petersawka/OpenHornet/MCAD/51M30-01-2-03N.SLDASM

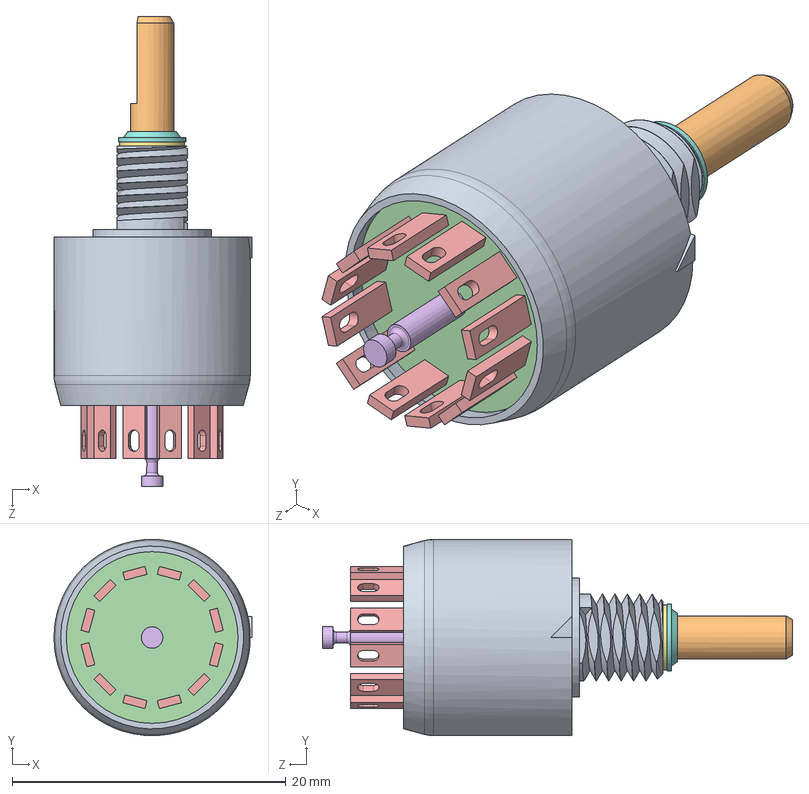
[picture p1: CAD file, 2020-11-07]
MCAD/51M30-01-2-03N.SLDASM
14.5 x 14.3 x 34.3 mm
58R3008-X
58J2001-1
58Z3130
58ZZ3040-X_PLASTIC
50C3495-5-B-001 x 12
58C3026-10
06J1025-12
58J2427
