petersawka/OpenHornet/MCAD/DSOS-0416-12D.SLDASM

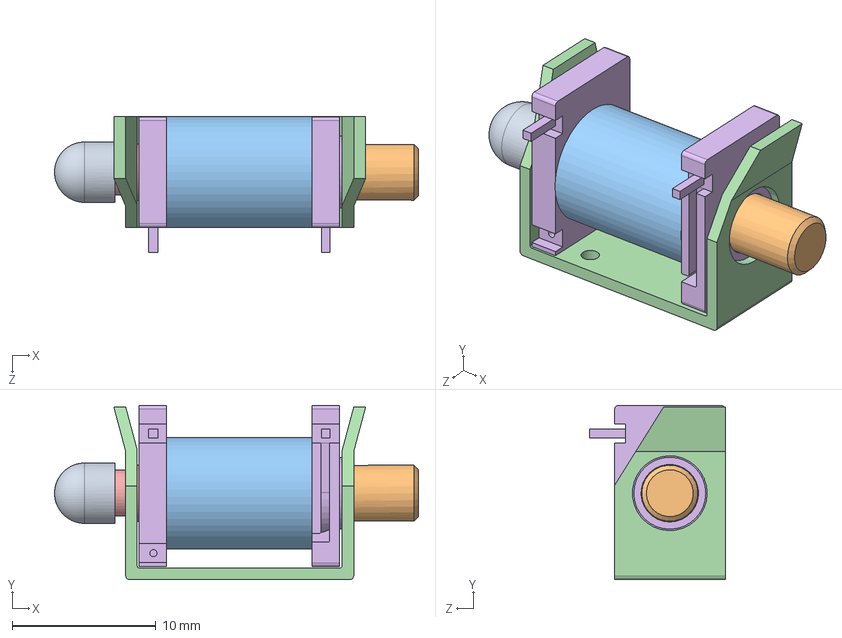
[picture p2: CAD file, 2020-11-07]
MCAD/DSOS-0416-12D.SLDASM
25.3 x 12.1 x 9.45 mm
Bumber_3248513100_051407
Plunger_3463301400_051407.dwg
Coil
Frame_3469011200
Stopper_3463600200 .bak
Bobbin
