petersawka/OpenHornet/MCAD/Wing Fold Handle Mechanism.SLDASM

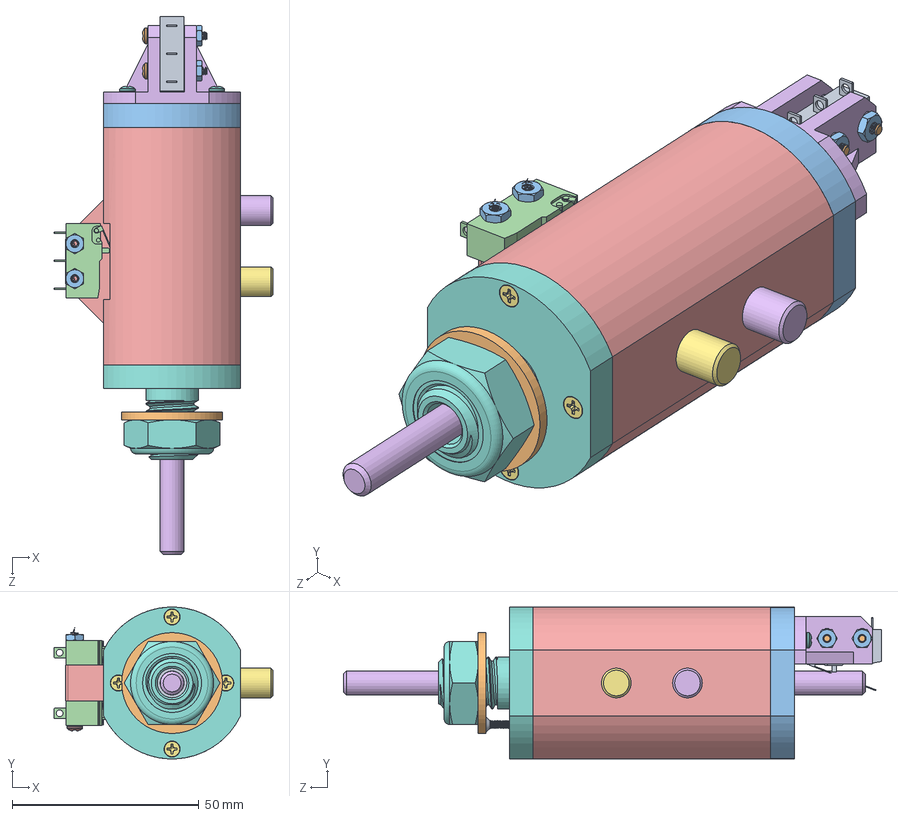
[picture p3: CAD file, 2020-11-07]
MCAD/Wing Fold Handle Mechanism.SLDASM
58.6 x 40.6 x 144.0 mm
Wing Fold Mechanism Rotary Detents
92311A105 x 3
91841A005 x 3
Wing Fold Mechanism Push-Pull Detents
9414T6 x 2
Wing Fold Mechanism .250 Shaft
92311A425
Wing Fold Mechanism Upper Cap
6338K411
93365A112 x 11
Wing Fold Mechanism Lower Cap
6338K411 (1)
Wing Fold Mechanism Main Body
Wing Fold Mechanism Locking Limit Switch Bracket
96640A027 x 8
91249A050 x 2
7658K15
91249A060 x 2
91841A003 x 4
7658K16 x 2
91249A066 x 2
84835A44
84835A36
Wing Fold Handle Retaining Nut
96640A025
92141A034
