petersawka/OpenHornet/MCAD/631H_SLASH_2 - SWITCH, TOGGLE, ON-OFF, STD BAT.SLDASM

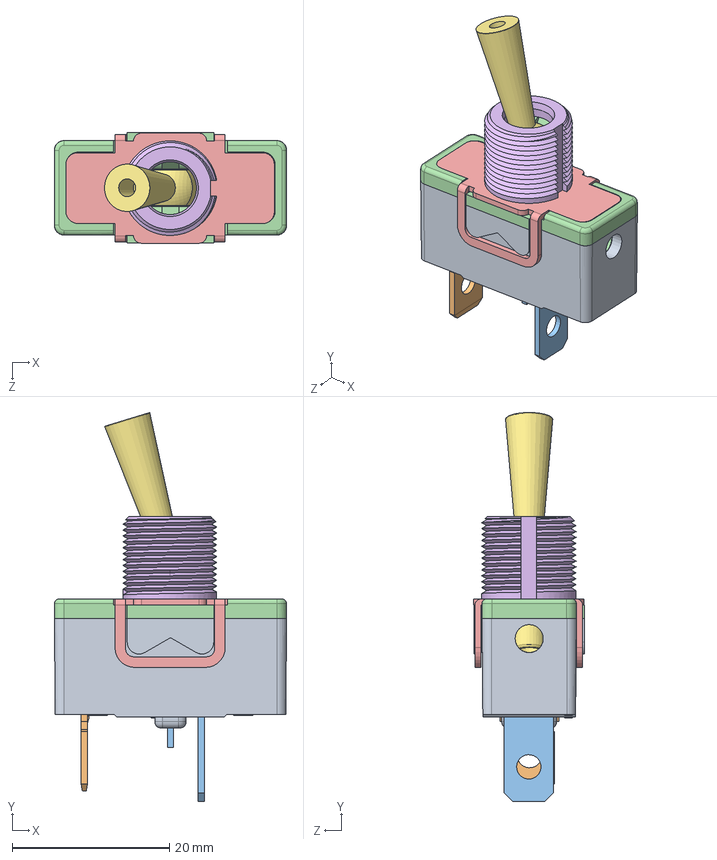
[picture p4: CAD file, 2020-11-07]
MCAD/631H_SLASH_2 - SWITCH, TOGGLE, ON-OFF, STD BAT.SLDASM
29.5 x 49.4 x 14.1 mm
