petersawka/OpenHornet/MCAD/ESE11HS2.SLDASM

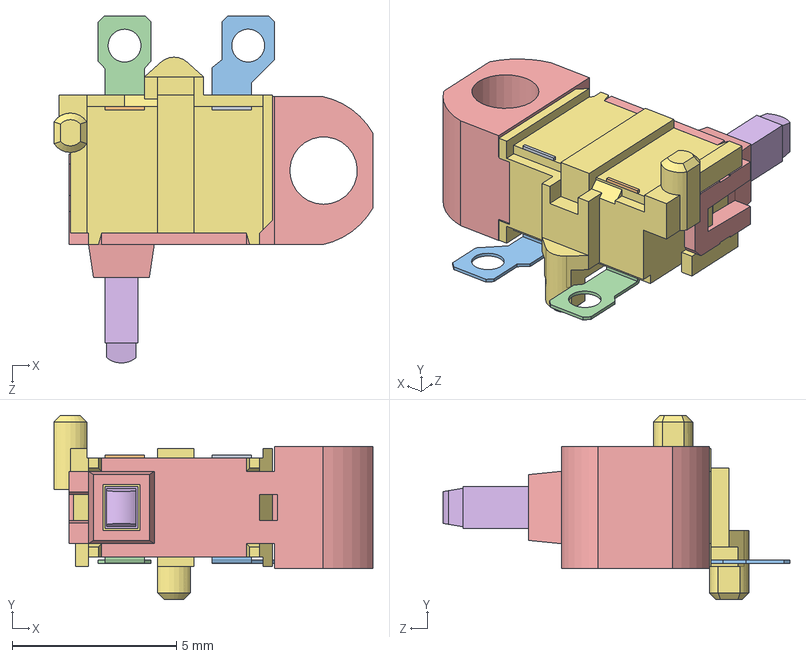
[picture p5: CAD file, 2020-11-07]
MCAD/ESE11HS2.SLDASM
9.70 x 5.60 x 10.6 mm
sw-3d-131-e11ts8-hs-sk-r00
sw-3d-131-e11ts8-hs-sk-r00_2
sw-3d-131-e11ts8-hs-sk-r00_3
sw-3d-131-e11ts8-hs-sk-r00_4
sw-3d-131-e11cv9a-hs-sk-r00
sw-3d-131-e11lv9-hs-sk-r00
sw-3d-131-e11cs3-hs-pc-r00
