petersawka/OpenHornet/MCAD/SIM CNTL Panel.sldasm

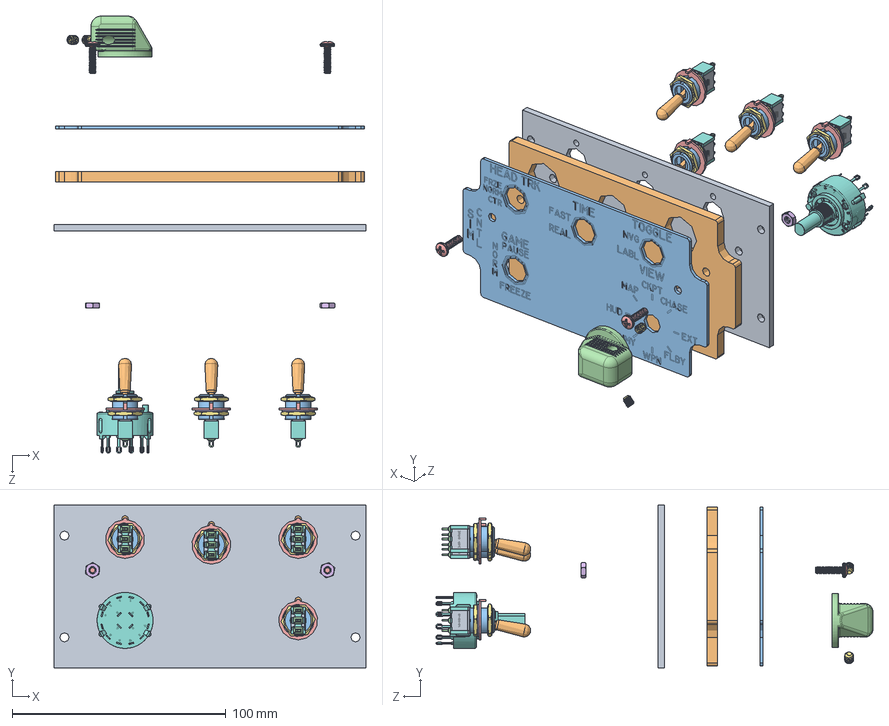
[picture p6: CAD file, 2020-11-07]
MCAD/SIM CNTL Panel.sldasm
146.1 x 76.2 x 204.5 mm
SIM CNTL Panel Backplate
SIM CNTL Panel Lightplate
SIM CNTL Panel Legend Plate
MS21384-04DNN v1
91249A148 - PHS, 6-32 X .500, 18-8, BLACK-OXIDE x 2
90760A007 - NUT, 6-32, JAM, STEEL, ZINC-PLATED x 2
92311A189 - SCREW, SET, 8-32 X .1875, CUP POINT, HEX DRIVE, 18-8 x 2
100-300SPXBODY x 4
100SPXBRACKET_1 x 4
100T8 x 4
100B13BUSHING x 4
100-300SPXM1 x 4
HDW17 - LOCKING RING, B13 x 4
HDW12 - LOCK WASHER, B13 x 4
HDW4 - NUT, B13 x 8
A12505RNZQ - SWITCH, ROTARY, 45 DEG, 8 POS, FIXED
