petersawka/OpenHornet/MCAD/100SPxT8B13M1QEH - SWITCH, TOGGLE, SPDT, 18mm BAT.SLDASM

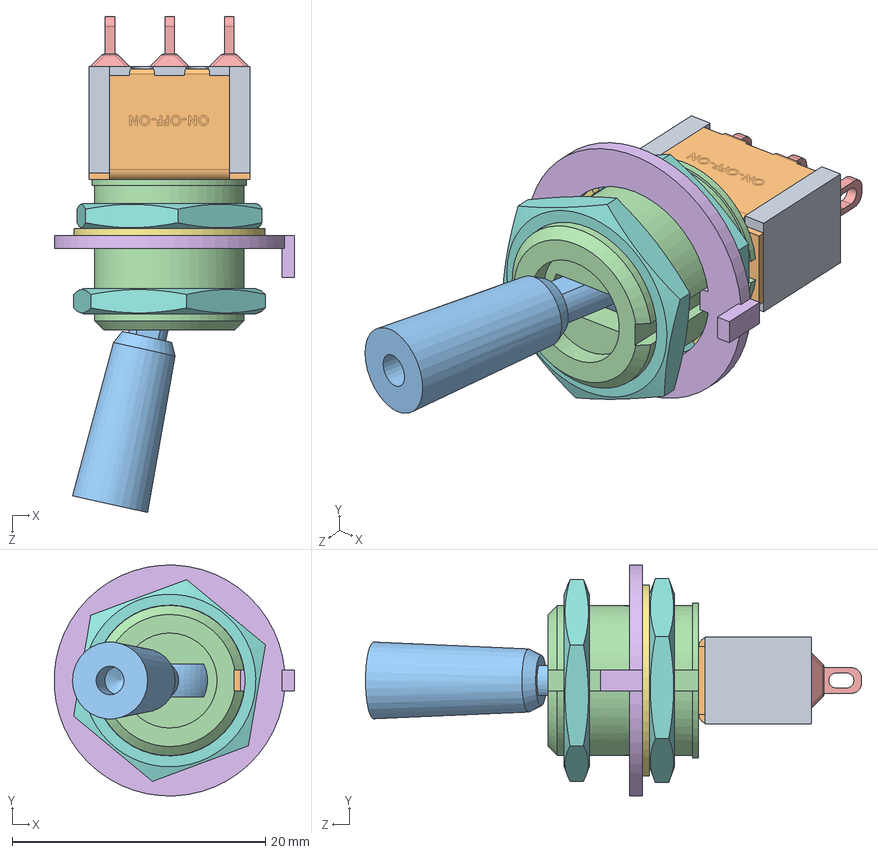
[picture p7: CAD file, 2020-11-07]
MCAD/100SPxT8B13M1QEH - SWITCH, TOGGLE, SPDT, 18mm BAT.SLDASM
19.0 x 18.2 x 39.2 mm
100-300SPXBODY
100SPXBRACKET_1
100T8
100B13BUSHING
100-300SPXM1
HDW17 - LOCKING RING, B13
HDW12 - LOCK WASHER, B13
HDW4 - NUT, B13 x 2
