petersawka/OpenHornet/MCAD/OBOGS Panel.SLDASM

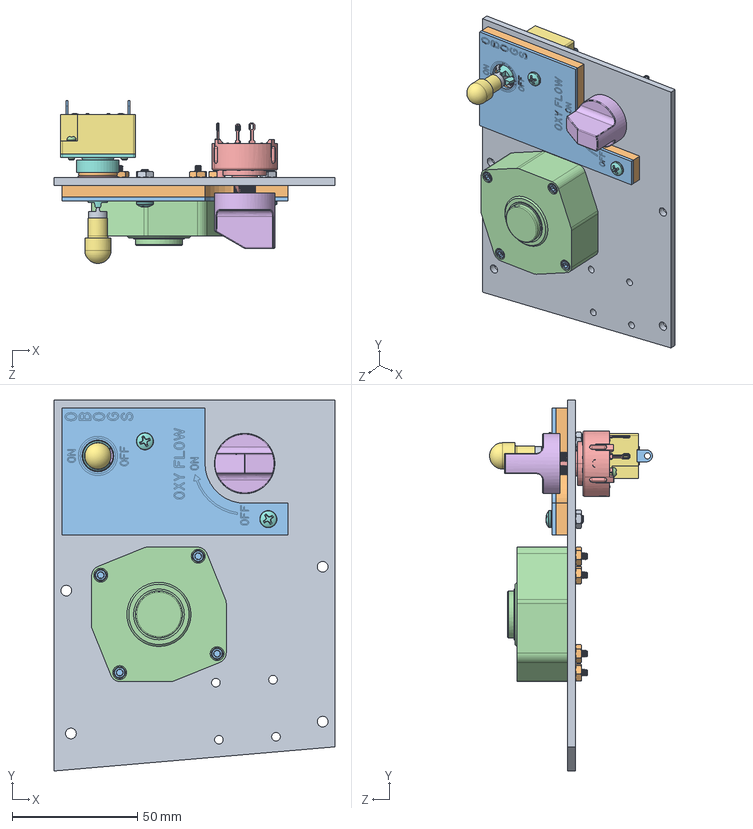
[picture p8: CAD file, 2020-11-07]
MCAD/OBOGS Panel.SLDASM
112.3 x 148.3 x 65.1 mm
OBOGS Backplate
OBOGS Lightplate
OBOGS Legend Plate
OBOGS Regulator
A11405RNZQ - SWITCH, ROTARY, 90 DEG, 2 POS
OBOGS Knob
S2AL_SMC_body1-body
S2AL_SMC_plate13
S2AL_S2AL_bat
S2AL_AT537
S2AL_SMC_trmnls2-terminals
S2AL_M2_5x7_5 x 2
S2AL_AT508
S2AL_AT503M
Round Locking Bat
91249A148 - PHS, 6-32 X .500, 18-8, BLACK-OXIDE x 2
90760A007 - NUT, 6-32, JAM, STEEL, ZINC-PLATED x 2
91841A005 - NUT, 4-40, 18-8 x 4
91251A115 - SHCS, 4-40 X 1.000, STEEL, BLACK OXIDE x 4
