petersawka/OpenHornet/MCAD/Magnetically Actuated Switch.sldasm

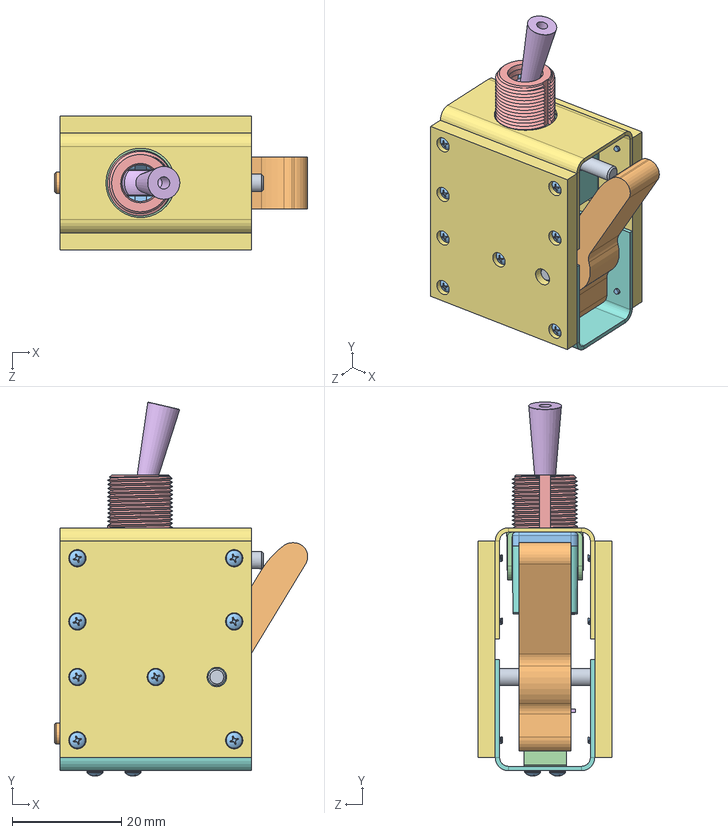
[picture p9: CAD file, 2020-11-07]
MCAD/Magnetically Actuated Switch.sldasm
46.4 x 68.4 x 24.6 mm
Bumber_3248513100_051407
Plunger_3463301400_051407.dwg
Coil
Frame_3469011200
Stopper_3463600200 .bak
Bobbin
Mag Held Switch Side Plate x 2
Upper Mag Switch Bracket
Lower Mag Switch Bracket
98381A474 - PIN, DOWEL, .125 OD X .825L, ALLOY STEEL x 2
Mag Switch Lever
99461A505 - PHS, 0-42 X .125, SELF TAPPING, 18-8 x 18
