petersawka/OpenHornet/MCAD/HS13Z_D - SWITCH, ROTARY, 45 DEG, 4 POS, FIXED.sldasm

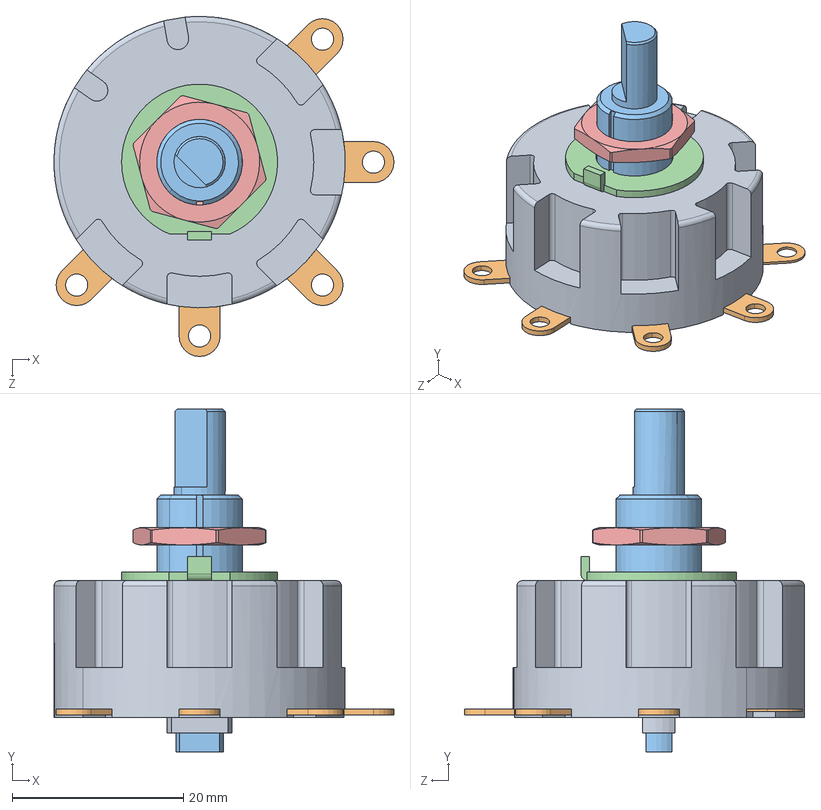
[picture p10: CAD file, 2020-11-07]
MCAD/HS13Z_D - SWITCH, ROTARY, 45 DEG, 4 POS, FIXED.sldasm
39.7 x 40.0 x 39.7 mm
_HS13Z_body_2
_HS13Z_trmnls_4
_HS13Z_D_shaft_6
_AT518_12
_AT526_8
