petersawka/OpenHornet/MCAD/SxAL.sldasm

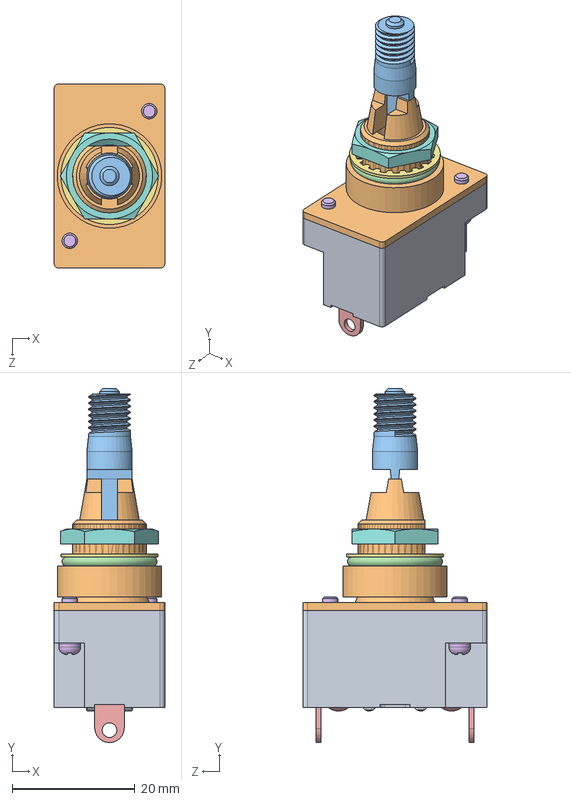
[picture p11: CAD file, 2020-11-07]
MCAD/SxAL.sldasm
18.0 x 57.6 x 30.0 mm
S2AL_SMC_body1-body
S2AL_SMC_plate13
S2AL_S2AL_bat
S2AL_AT537
S2AL_SMC_trmnls2-terminals
S2AL_M2_5x7_5 x 2
S2AL_AT508
S2AL_AT503M
