petersawka/OpenHornet/MCAD/SNSR Panel.sldasm

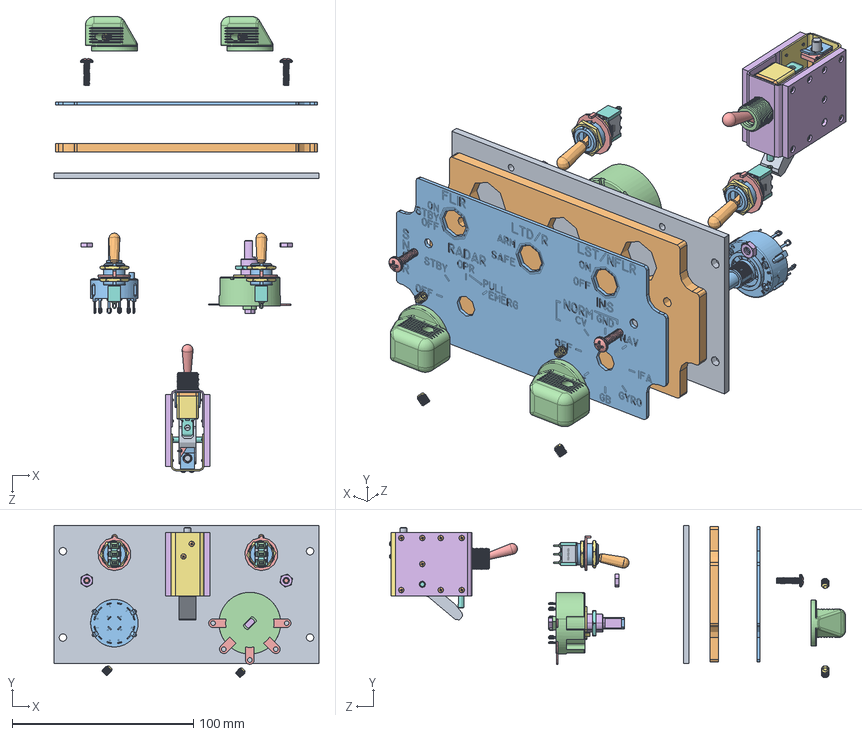
[picture p12: CAD file, 2020-11-07]
MCAD/SNSR Panel.sldasm
146.1 x 84.0 x 251.4 mm
SNSR Panel Backplate
SNSR Panel Lightplate
SNSR Panel Legend Plate
MS21384-04DNN v1 x 2
91249A148 - PHS, 6-32 X .500, 18-8, BLACK-OXIDE x 2
90760A007 - NUT, 6-32, JAM, STEEL, ZINC-PLATED x 2
92311A189 - SCREW, SET, 8-32 X .1875, CUP POINT, HEX DRIVE, 18-8 x 4
100-300SPXBODY x 2
100SPXBRACKET_1 x 2
100T8 x 2
100B13BUSHING x 2
100-300SPXM1 x 2
HDW17 - LOCKING RING, B13 x 2
HDW12 - LOCK WASHER, B13 x 2
HDW4 - NUT, B13 x 4
Bumber_3248513100_051407
Plunger_3463301400_051407.dwg
Coil
Frame_3469011200
Stopper_3463600200 .bak
Bobbin
Mag Held Switch Side Plate x 2
Upper Mag Switch Bracket
Lower Mag Switch Bracket
98381A474 - PIN, DOWEL, .125 OD X .825L, ALLOY STEEL x 2
Mag Switch Lever
99461A505 - PHS, 0-42 X .125, SELF TAPPING, 18-8 x 18
A12505RNZQ - SWITCH, ROTARY, 45 DEG, 8 POS, FIXED
_HS13Z_body_2
_HS13Z_trmnls_4
_HS13Z_D_shaft_6
_AT518_12
_AT526_8
