petersawka/OpenHornet/MCAD/DSOL-0630-12E - SOLENOID, OPEN-FRAME, PULL, INTERMITTENT, 12V, .50 STROKE.SLDASM

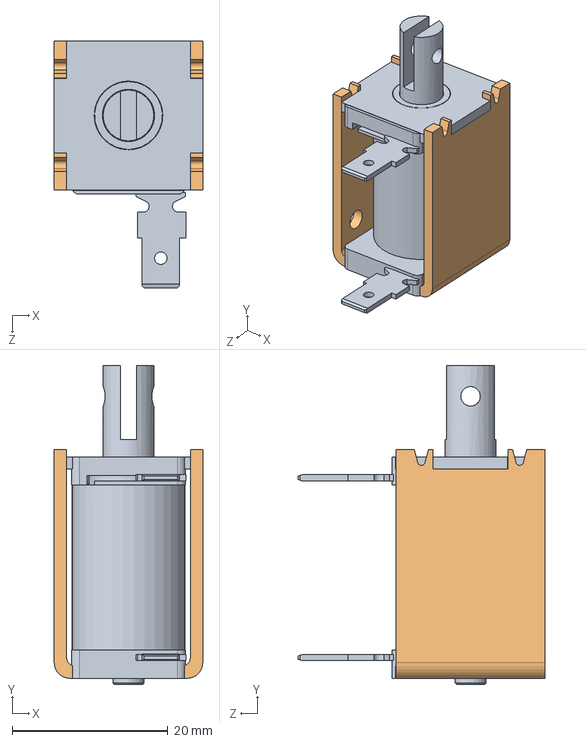
[picture p13: CAD file, 2020-11-07]
MCAD/DSOL-0630-12E - SOLENOID, OPEN-FRAME, PULL, INTERMITTENT, 12V, .50 STROKE.SLDASM
19.1 x 40.9 x 31.6 mm
COPPER_WIRE-DSOS-0630-24
U-FRAME_DSOS-0630-24
