petersawka/OpenHornet/MCAD/INT LT Panel.sldasm

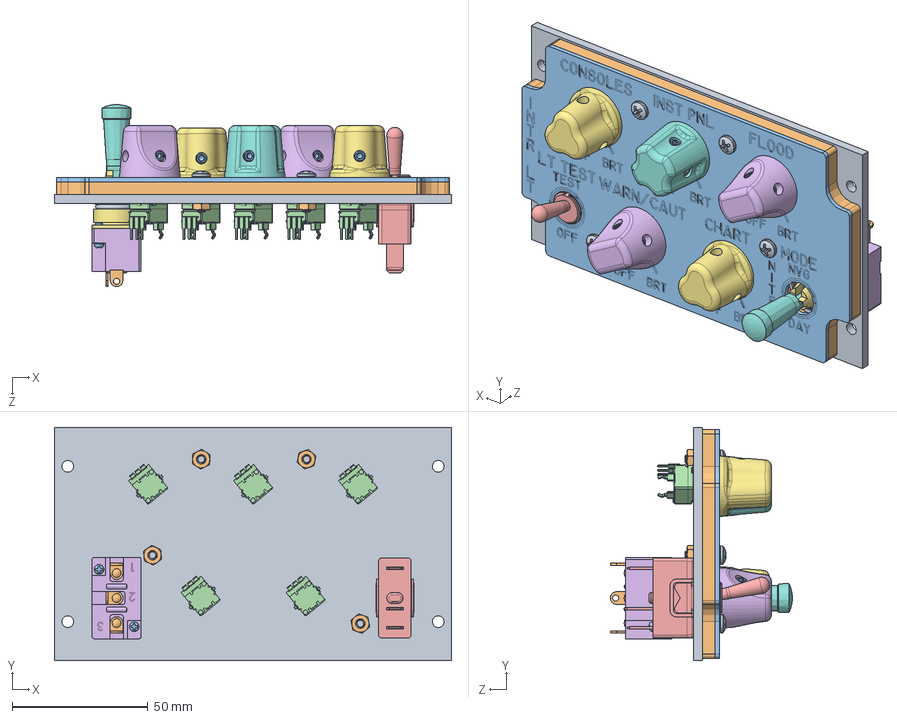
[picture p14: CAD file, 2020-11-07]
MCAD/INT LT Panel.sldasm
146.1 x 85.7 x 67.0 mm
INT Lights Backplate
INT Lights Lightplate
INT Lights Legend Plate
P0915N-FC20BR10K x 5
635H_SLASH_2 - SWITCH, TOGGLE, ON-MOM, REGULAR BAT
S2AL_SMC_body1-body
S2AL_SMC_plate13
S2AL_S2AL_bat
S2AL_AT537
S2AL_SMC_trmnls2-terminals
S2AL_M2_5x7_5 x 2
S2AL_AT508
S2AL_AT503M
MS21385-04CNN v1 x 2
MS21385-04ENN v3 x 2
MS21385-04BNN v1
91249A148 - PHS, 6-32 X .500, 18-8, BLACK-OXIDE x 4
90760A007 - NUT, 6-32, JAM, STEEL, ZINC-PLATED x 4
92311A189 - SCREW, SET, 8-32 X .1875, CUP POINT, HEX DRIVE, 18-8 x 10
