petersawka/OpenHornet/MCAD/Wing Fold Mechanism Rotating ASSY.SLDASM

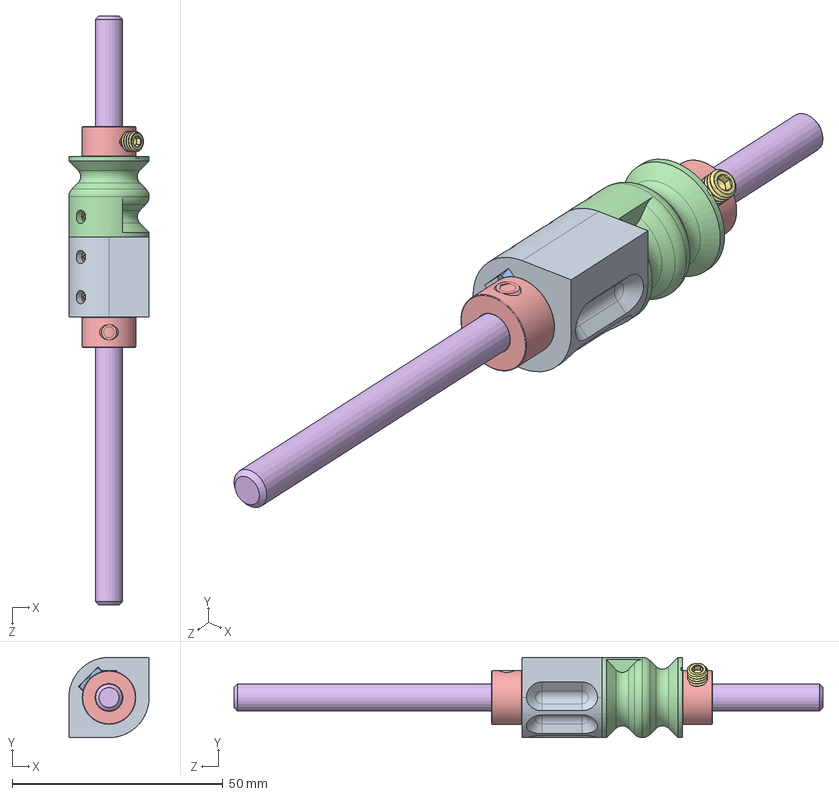
[picture p15: CAD file, 2020-11-07]
MCAD/Wing Fold Mechanism Rotating ASSY.SLDASM
19.1 x 19.1 x 139.7 mm
Wing Fold Mechanism Rotary Detents
92311A105 x 3
91841A005 x 3
Wing Fold Mechanism Push-Pull Detents
9414T6 x 2
Wing Fold Mechanism .250 Shaft
92311A425
