petersawka/OpenHornet/release/2_Upper Instrument Panel/manufacturing/3D Printed/OH1A8A1A-49 - UFC COMM LED Spacer Plate.STL

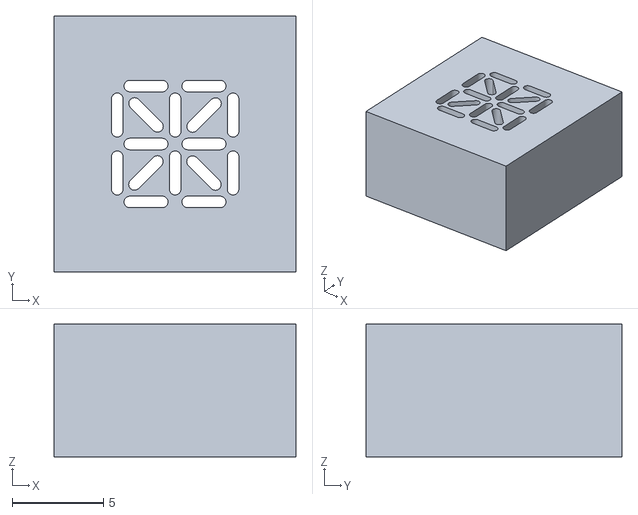
[picture p16: CAD file, 2020-11-07]
release/2_Upper Instrument Panel/manufacturing/3D Printed/OH1A8A1A-49 - UFC COMM LED Spacer Plate.STL
13.2 x 14.0 x 7.28
