petersawka/OpenHornet/release/2_Upper Instrument Panel/manufacturing/CNC/UIP .50 inch Parts/.50 DXF Drawings/UIP Left Inboard Longeron.dxf

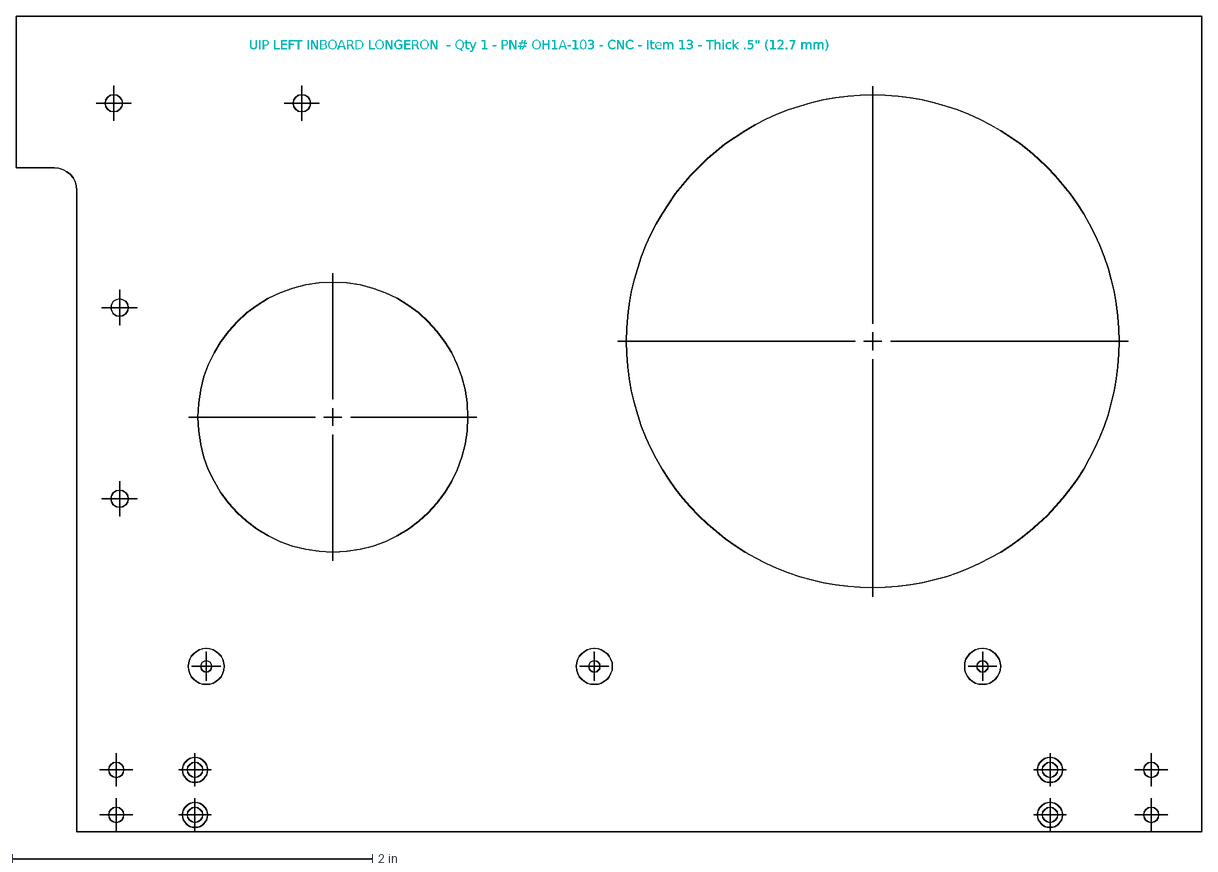
[picture p17: CAD file, 2020-11-07]
release/2_Upper Instrument Panel/manufacturing/CNC/UIP .50 inch Parts/.50 DXF Drawings/UIP Left Inboard Longeron.dxf
UIP LEFT INBOARD LONGERON - Qty 1 - PN# OH1A-103 - CNC - Item 13 - Thick .5" (12.7 mm)
