petersawka/OpenHornet/release/2_Upper Instrument Panel/manufacturing/CNC/UIP .75 inch Parts/.75 DXF Drawings/UIP Right Inboard Longeron.DXF

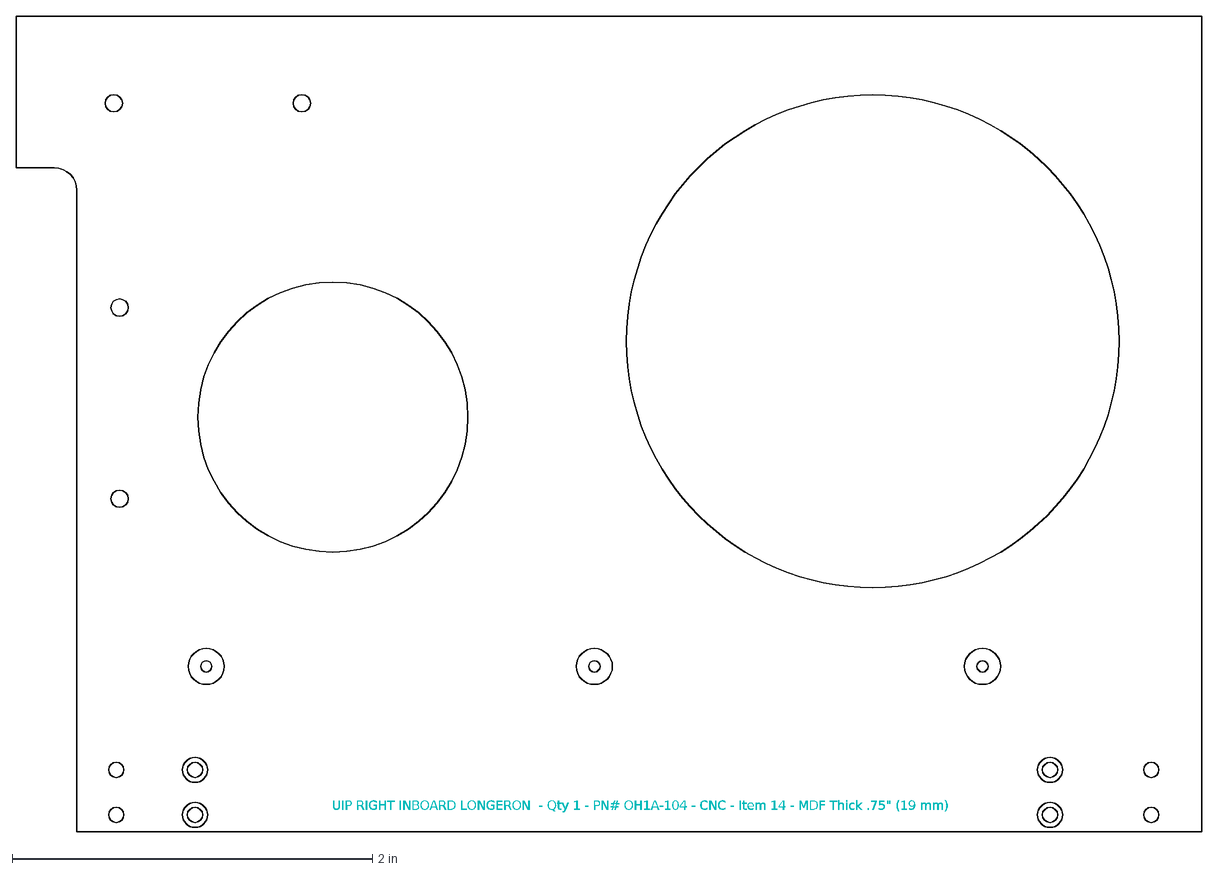
[picture p18: CAD file, 2020-11-07]
release/2_Upper Instrument Panel/manufacturing/CNC/UIP .75 inch Parts/.75 DXF Drawings/UIP Right Inboard Longeron.DXF
UIP RIGHT INBOARD LONGERON - Qty 1 - PN# OH1A-104 - CNC - Item 14 - MDF Thick .75" (19 mm)
