petersawka/OpenHornet/release/3_Lower Instrument Panel/Manufacturing/CNC/LIP .0625 inch Parts/.0625 DXF Drawings/LIP L EXT Skin.dxf

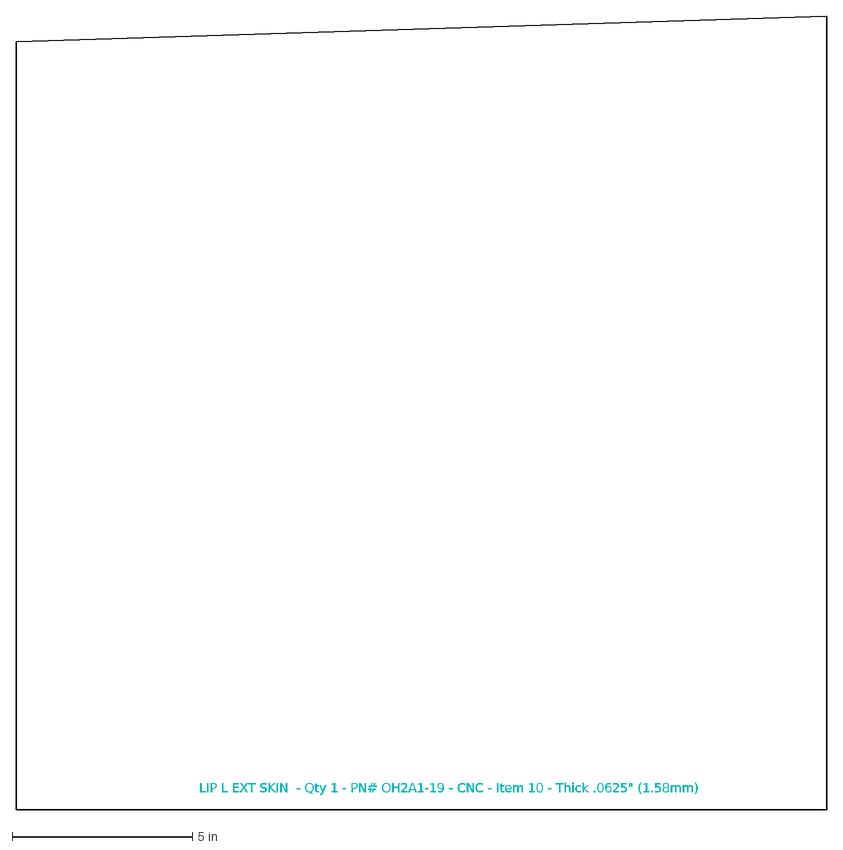
[picture p19: CAD file, 2020-11-07]
release/3_Lower Instrument Panel/Manufacturing/CNC/LIP .0625 inch Parts/.0625 DXF Drawings/LIP L EXT Skin.dxf
LIP L EXT SKIN - Qty 1 - PN# OH2A1-19 - CNC - Item 10 - Thick .0625" (1.58mm)
