petersawka/OpenHornet/release/3_Lower Instrument Panel/Manufacturing/CNC/LIP .125 inch Parts/.125 DXF Drawings/Upper Center Pedestal AMPCD Trim.dxf

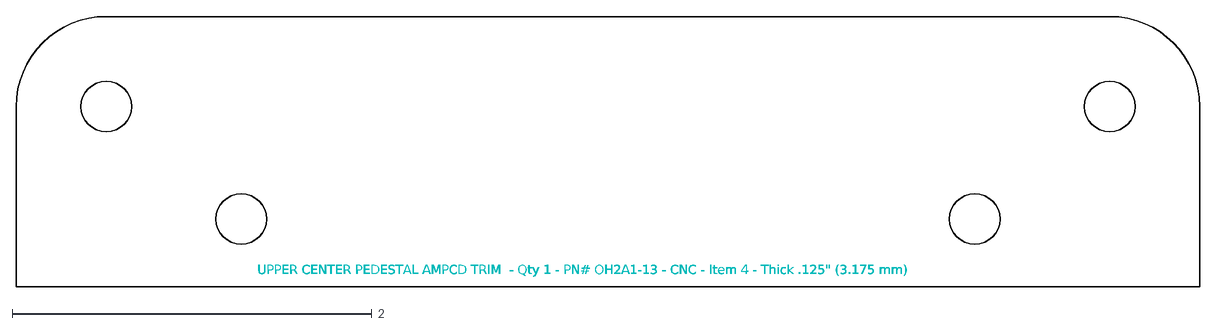
[picture p20: CAD file, 2020-11-07]
release/3_Lower Instrument Panel/Manufacturing/CNC/LIP .125 inch Parts/.125 DXF Drawings/Upper Center Pedestal AMPCD Trim.dxf
UPPER CENTER PEDESTAL AMPCD TRIM - Qty 1 - PN# OH2A1-13 - CNC - Item 4 - Thick .125" (3.175 mm)
