petersawka/OpenHornet/MCAD/Primary Rib G.sldprt

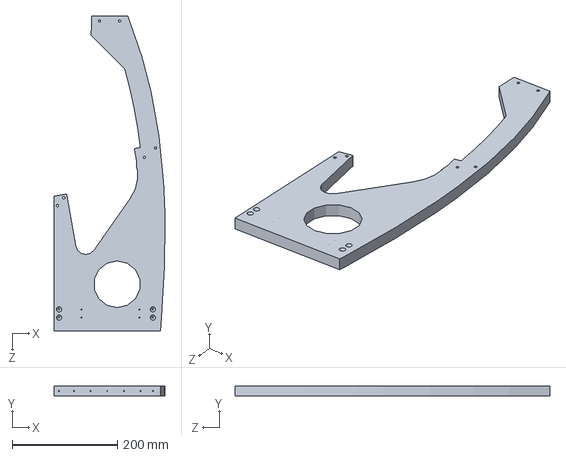
[picture p21: CAD file, 2020-11-07]
MCAD/Primary Rib G.sldprt
210.8 x 19.1 x 599.7 mm
