petersawka/OpenHornet/release/2_Upper Instrument Panel/manufacturing/3D Printed/OH1A2A-14 - Bracket, Master Arm Panel.STL

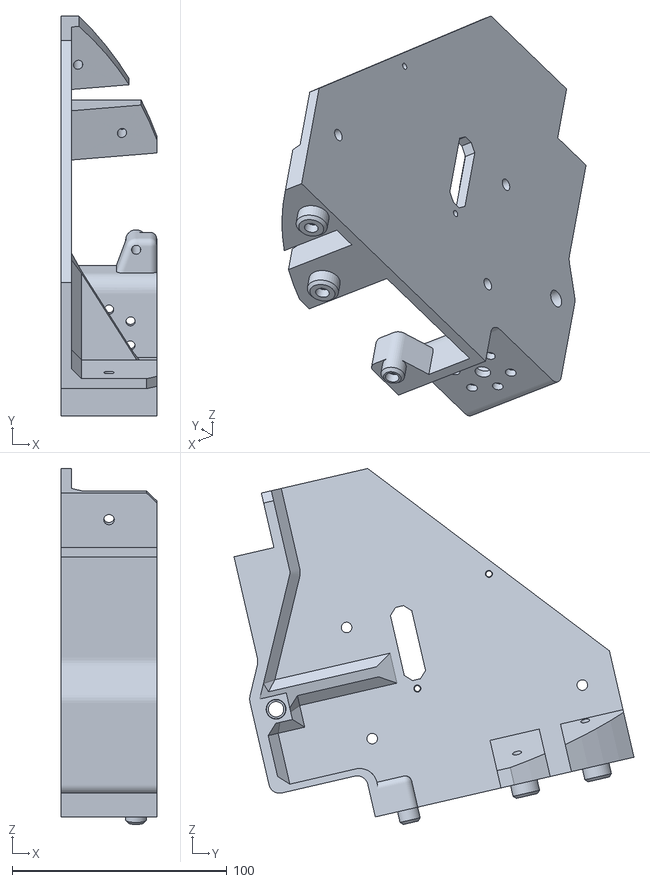
[picture p22: CAD file, 2020-11-07]
release/2_Upper Instrument Panel/manufacturing/3D Printed/OH1A2A-14 - Bracket, Master Arm Panel.STL
44.5 x 186.1 x 165.6
