petersawka/OpenHornet/release/3_Lower Instrument Panel/Manufacturing/CNC/LIP .0625 inch Parts/.0625 DXF Drawings/LIP R EXT SKIN.dxf

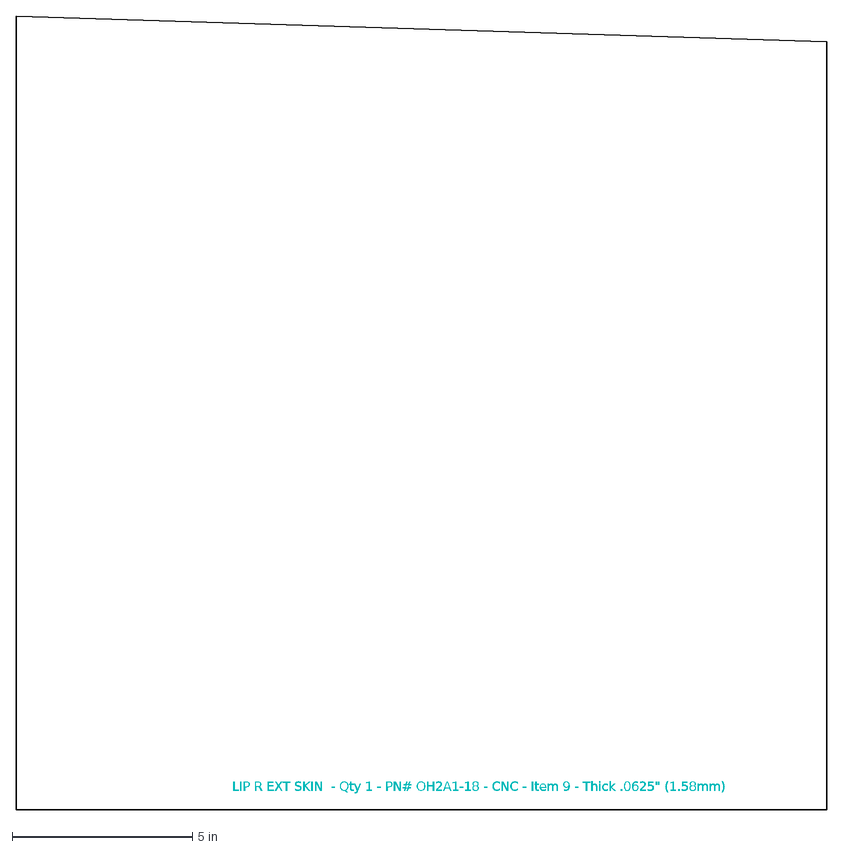
[picture p23: CAD file, 2020-11-07]
release/3_Lower Instrument Panel/Manufacturing/CNC/LIP .0625 inch Parts/.0625 DXF Drawings/LIP R EXT SKIN.dxf
LIP R EXT SKIN - Qty 1 - PN# OH2A1-18 - CNC - Item 9 - Thick .0625" (1.58mm)
