petersawka/OpenHornet/release/3_Lower Instrument Panel/Manufacturing/CNC/LIP .50 inch Parts/.50 DXF Drawings/Rudder Pedal Gantry Interface Plate.dxf

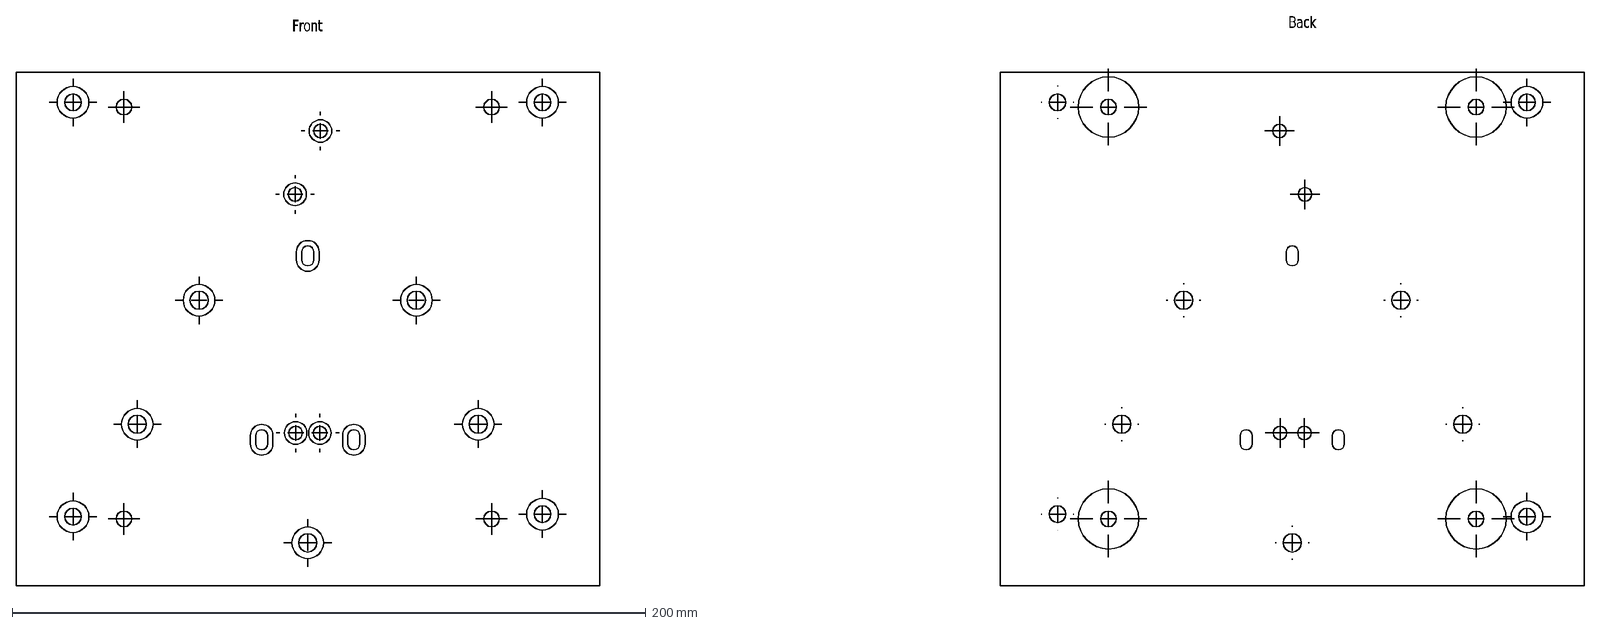
[picture p24: CAD file, 2020-11-07]
release/3_Lower Instrument Panel/Manufacturing/CNC/LIP .50 inch Parts/.50 DXF Drawings/Rudder Pedal Gantry Interface Plate.dxf
Back
Front
