petersawka/OpenHornet/release/2_Upper Instrument Panel/manufacturing/3D Printed/OH1A3A-11 - DDI Button.STL

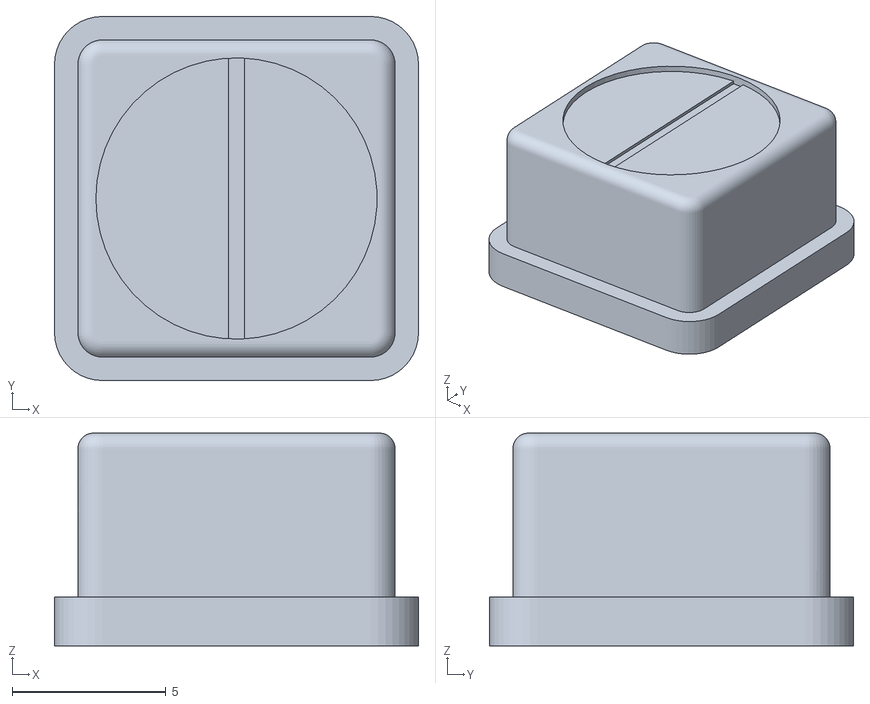
[picture p25: CAD file, 2020-11-07]
release/2_Upper Instrument Panel/manufacturing/3D Printed/OH1A3A-11 - DDI Button.STL
11.8 x 11.8 x 6.92
