petersawka/OpenHornet/release/2_Upper Instrument Panel/manufacturing/CNC/UIP .50 inch Parts/.50 DXF Drawings/Upper HUD Box Support.DXF

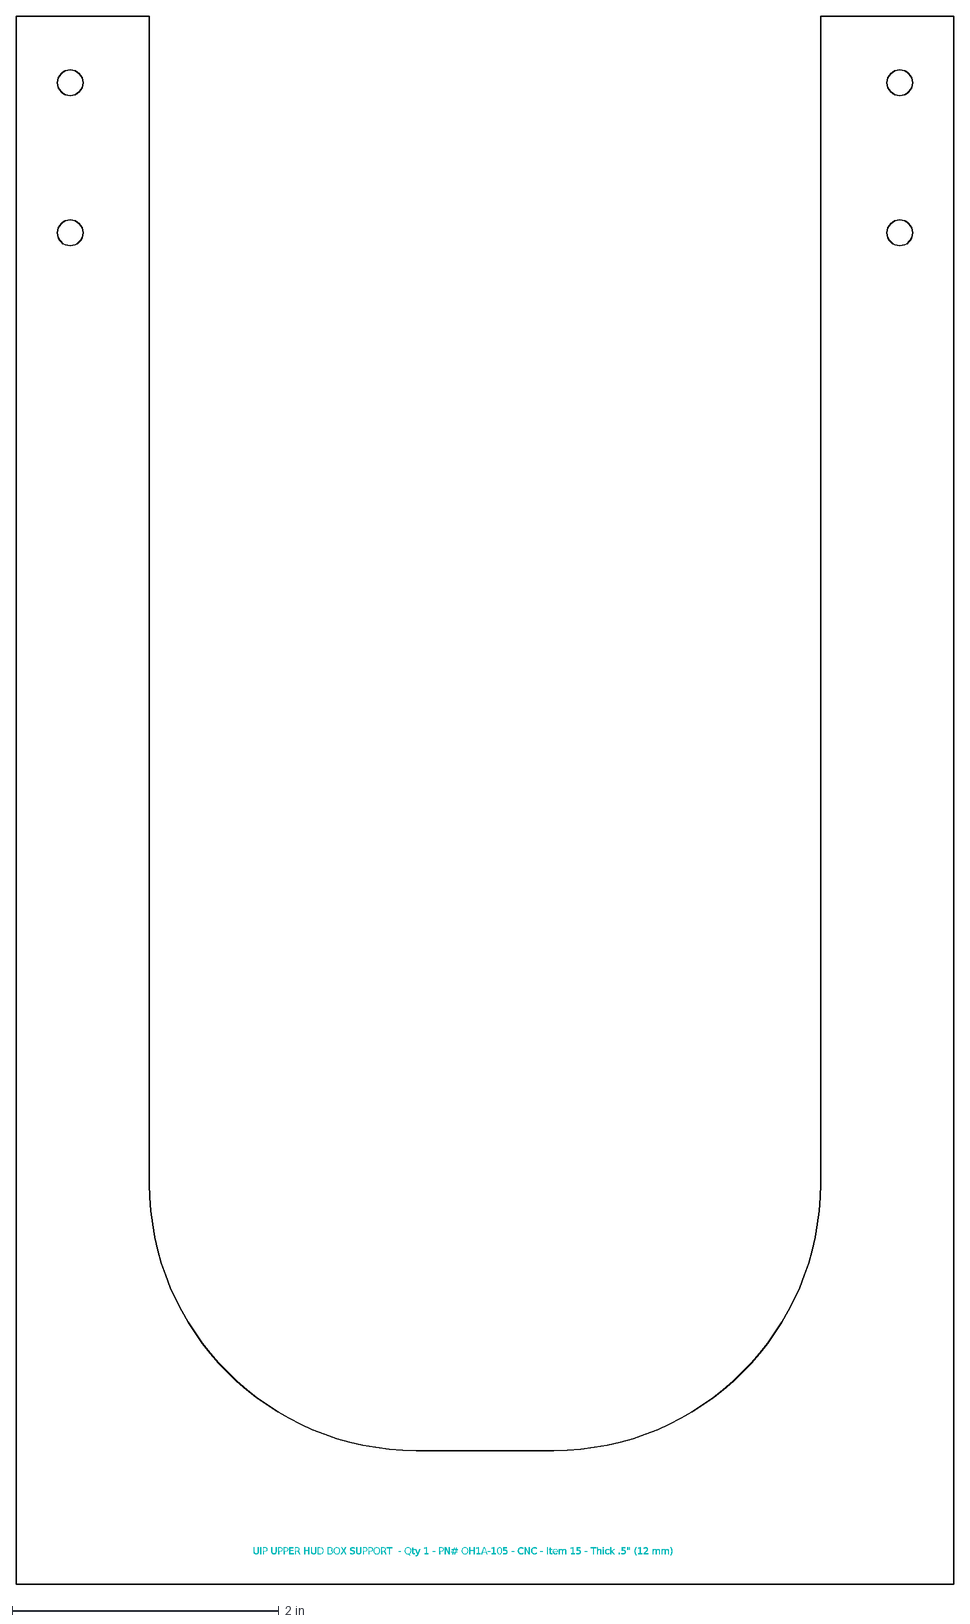
[picture p26: CAD file, 2020-11-07]
release/2_Upper Instrument Panel/manufacturing/CNC/UIP .50 inch Parts/.50 DXF Drawings/Upper HUD Box Support.DXF
UIP UPPER HUD BOX SUPPORT - Qty 1 - PN# OH1A-105 - CNC - Item 15 - Thick .5" (12 mm)
