petersawka/OpenHornet/release/2_Upper Instrument Panel/manufacturing/CNC/UIP .75 inch Parts/.75 DXF Drawings/UIP Left Inboard Longeron.DXF

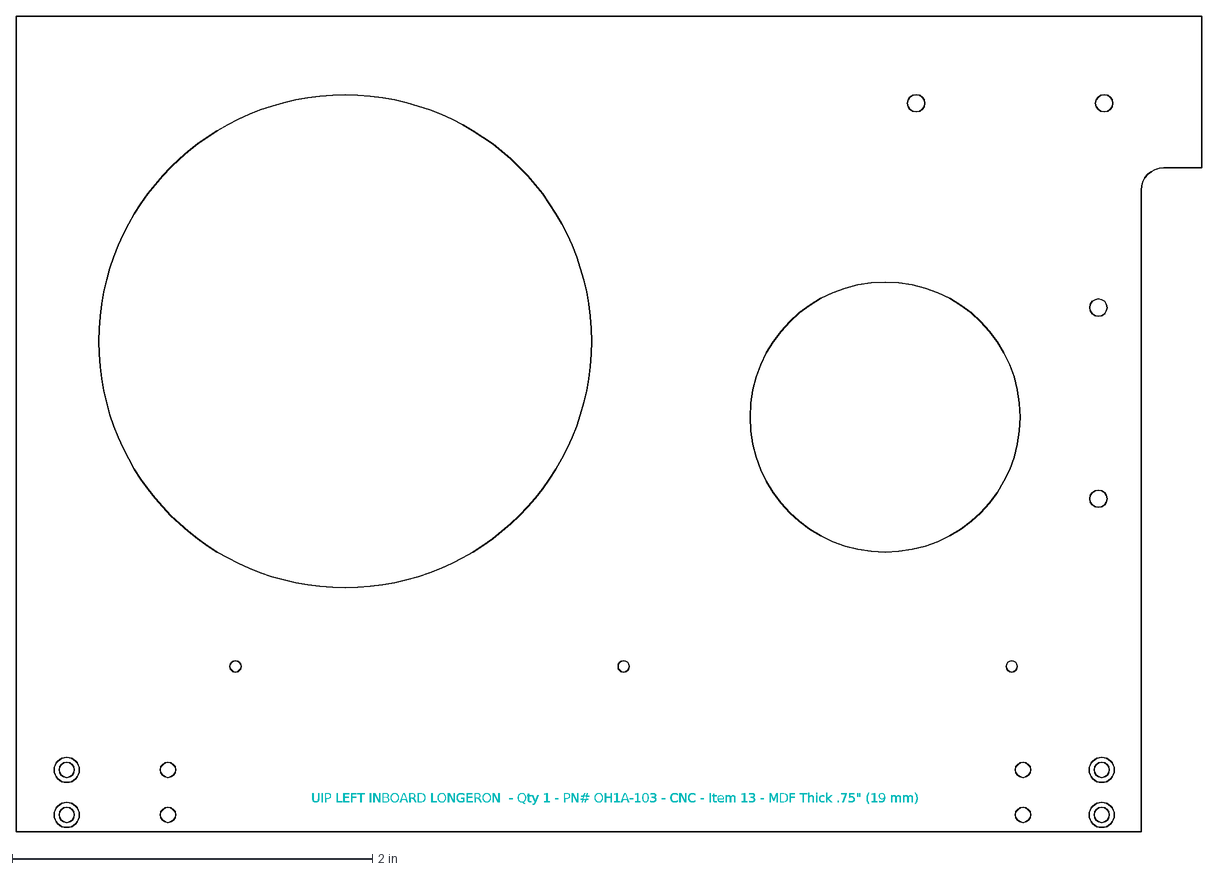
[picture p27: CAD file, 2020-11-07]
release/2_Upper Instrument Panel/manufacturing/CNC/UIP .75 inch Parts/.75 DXF Drawings/UIP Left Inboard Longeron.DXF
UIP LEFT INBOARD LONGERON - Qty 1 - PN# OH1A-103 - CNC - Item 13 - MDF Thick .75" (19 mm)
