petersawka/OpenHornet/release/2_Upper Instrument Panel/manufacturing/3D Printed/OH1A8A1A-13 - UFC Outer Spacer Plate.STL

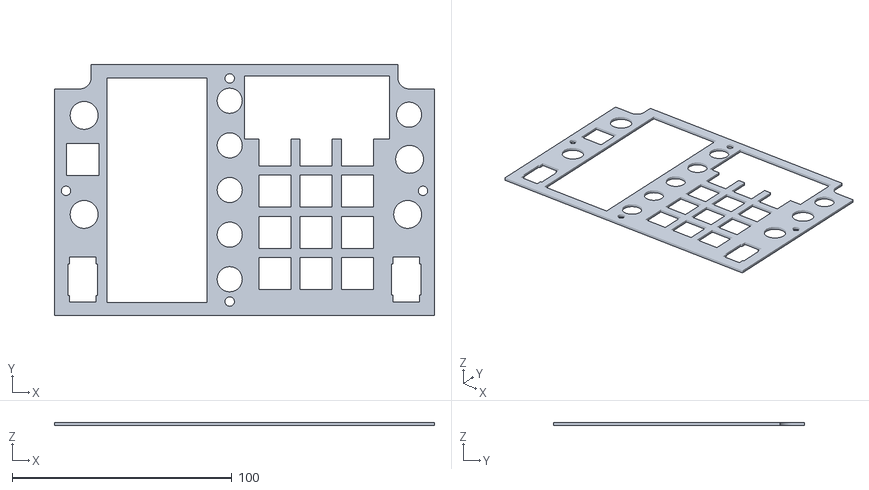
[picture p28: CAD file, 2020-11-07]
release/2_Upper Instrument Panel/manufacturing/3D Printed/OH1A8A1A-13 - UFC Outer Spacer Plate.STL
173.0 x 114.3 x 1.59
