petersawka/OpenHornet/release/3_Lower Instrument Panel/Manufacturing/CNC/LIP .75 inch Parts/.75 DXF Drawings/Right LIP Canopy Sill1.dxf

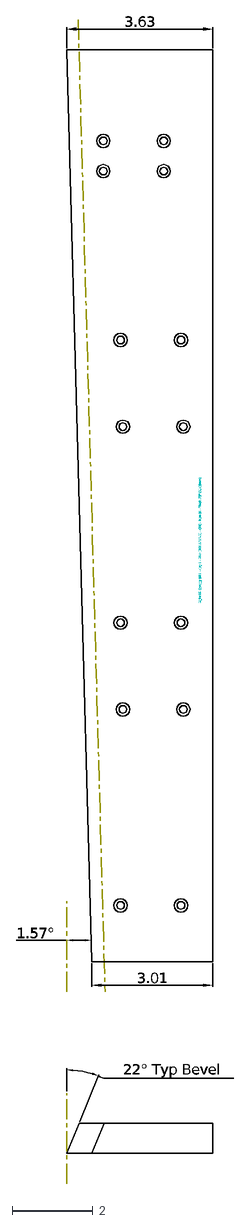
[picture p29: CAD file, 2020-11-07]
release/3_Lower Instrument Panel/Manufacturing/CNC/LIP .75 inch Parts/.75 DXF Drawings/Right LIP Canopy Sill1.dxf
22° Typ Bevel
Right LIP Canopy Sill1 - Qty 1 - PN# OH2A1A1A-40 - CNC - Item 31 - Thick .75" (19.05mm)
1.57°
3.63
3.01
