petersawka/OpenHornet/release/2_Upper Instrument Panel/manufacturing/3D Printed/OH1A8A1A-44 - UFC MS21382-0XNX.STL

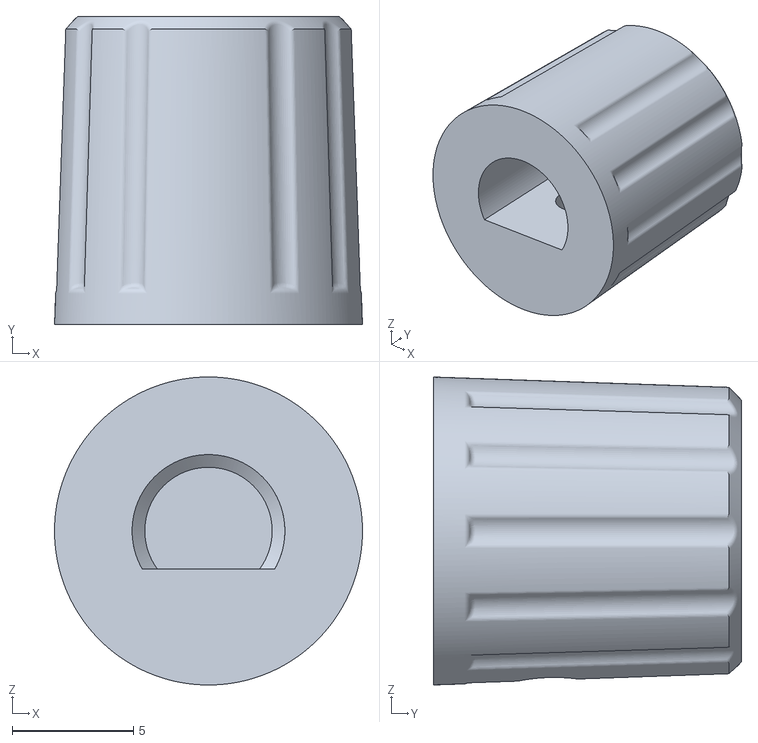
[picture p30: CAD file, 2020-11-07]
release/2_Upper Instrument Panel/manufacturing/3D Printed/OH1A8A1A-44 - UFC MS21382-0XNX.STL
12.7 x 12.7 x 12.7
