petersawka/OpenHornet/release/2_Upper Instrument Panel/manufacturing/3D Printed/OH1A8A2A-13 - HUD Panel Legend Plate.STL

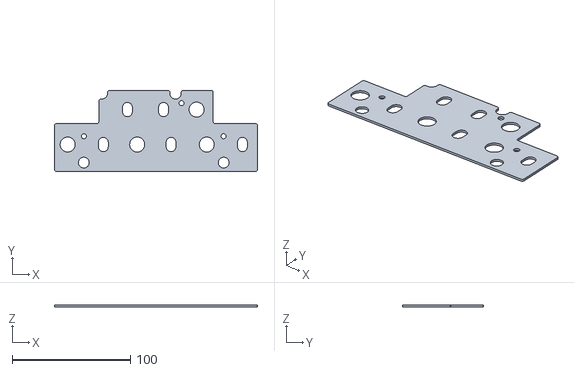
[picture p31: CAD file, 2020-11-07]
release/2_Upper Instrument Panel/manufacturing/3D Printed/OH1A8A2A-13 - HUD Panel Legend Plate.STL
171.4 x 68.6 x 1.59
