petersawka/OpenHornet/release/2_Upper Instrument Panel/manufacturing/3D Printed/OH1A8A2A-12 - HUD Panel Light Plate.STL

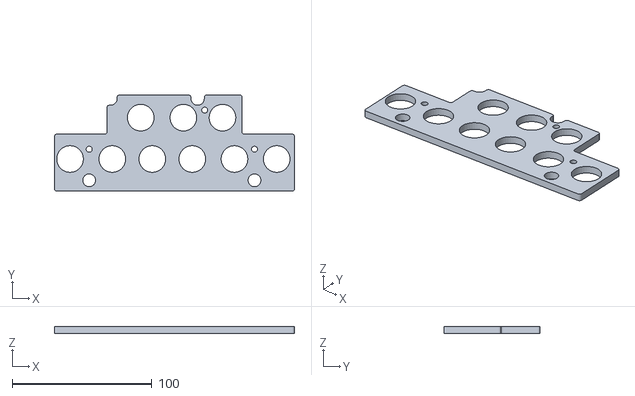
[picture p32: CAD file, 2020-11-07]
release/2_Upper Instrument Panel/manufacturing/3D Printed/OH1A8A2A-12 - HUD Panel Light Plate.STL
171.4 x 68.6 x 4.76
