petersawka/OpenHornet/release/2_Upper Instrument Panel/manufacturing/3D Printed/OH1A3A-14 - DDI Fingerguard, Left Clipped.STL

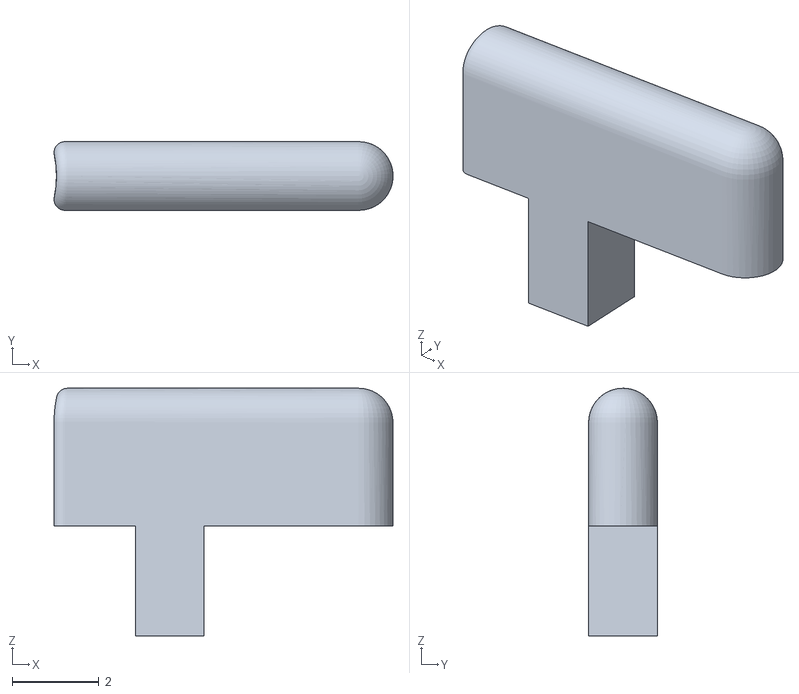
[picture p33: CAD file, 2020-11-07]
release/2_Upper Instrument Panel/manufacturing/3D Printed/OH1A3A-14 - DDI Fingerguard, Left Clipped.STL
7.83 x 1.59 x 5.72
