petersawka/OpenHornet/MCAD/AMPCD Button.sldprt

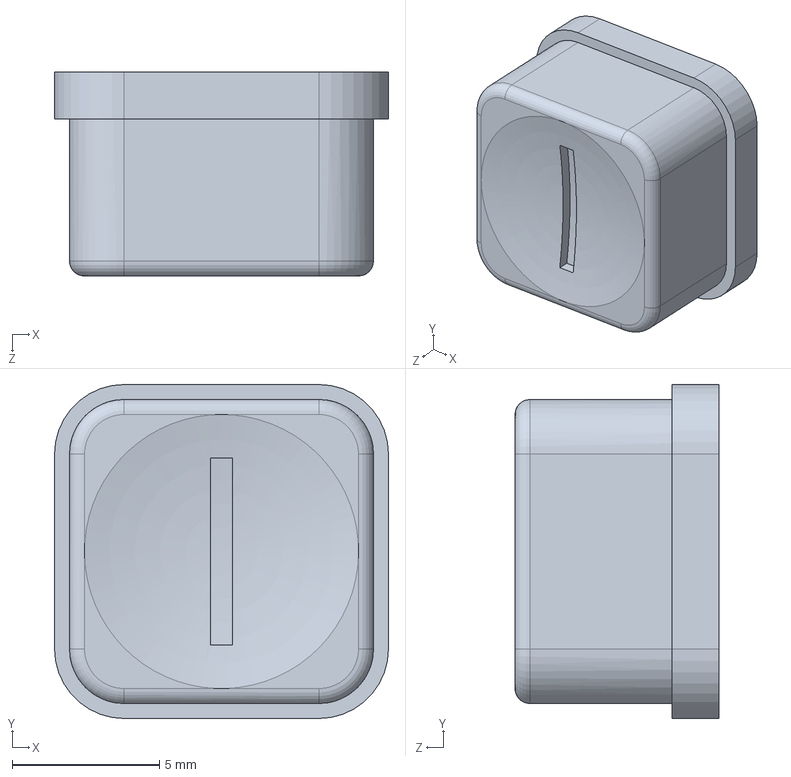
[picture p34: CAD file, 2020-11-07]
MCAD/AMPCD Button.sldprt
11.3 x 11.3 x 6.92 mm
