petersawka/OpenHornet/release/2_Upper Instrument Panel/manufacturing/3D Printed/OH1A7A-14 - KNOB, KORRY, RD239-A1G2.stl

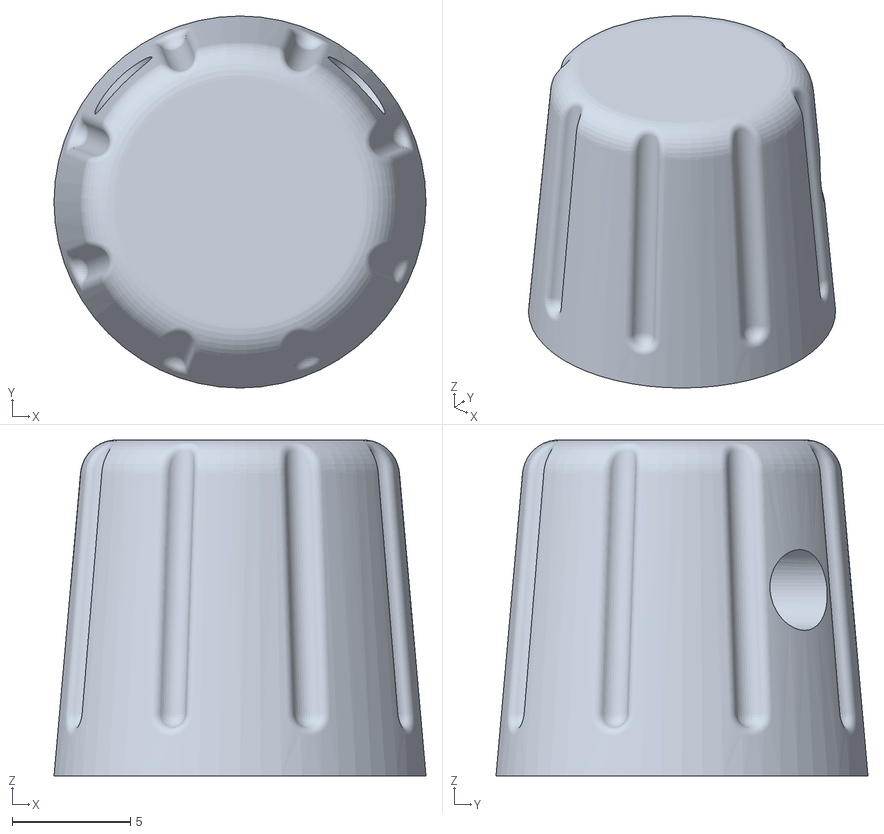
[picture p35: CAD file, 2020-11-07]
release/2_Upper Instrument Panel/manufacturing/3D Printed/OH1A7A-14 - KNOB, KORRY, RD239-A1G2.stl
15.7 x 15.7 x 14.2
