petersawka/OpenHornet/release/2_Upper Instrument Panel/manufacturing/3D Printed/OH1A2A-41 - EMERG JETT Button.STL

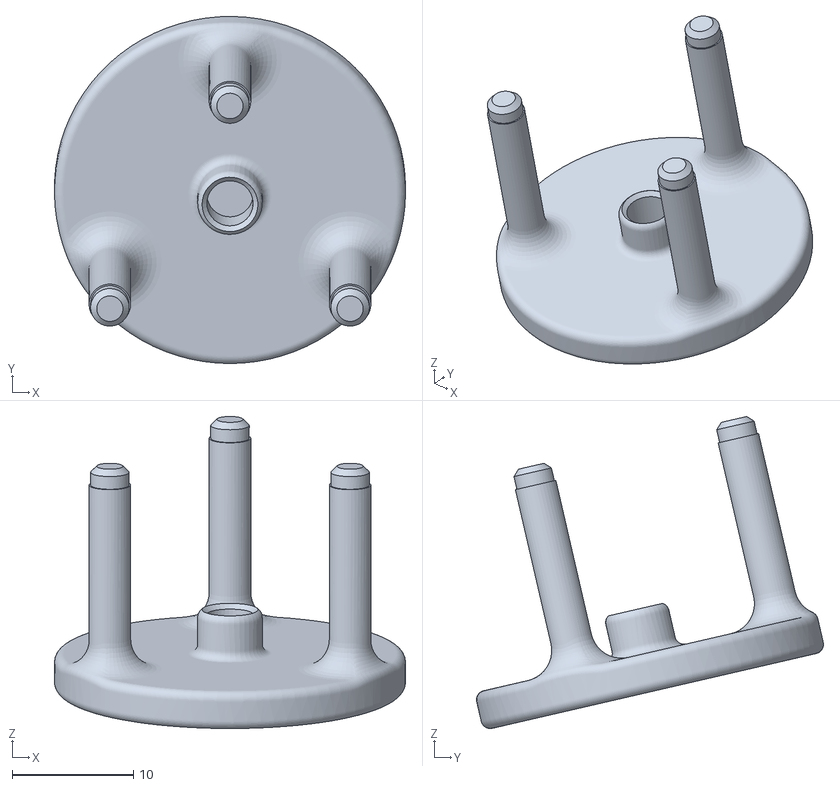
[picture p36: CAD file, 2020-11-07]
release/2_Upper Instrument Panel/manufacturing/3D Printed/OH1A2A-41 - EMERG JETT Button.STL
28.9 x 28.6 x 25.7
