petersawka/OpenHornet/release/2_Upper Instrument Panel/manufacturing/3D Printed/OH1A3A-19 - DDI MS21382-0XNX (MODIFIED).stl

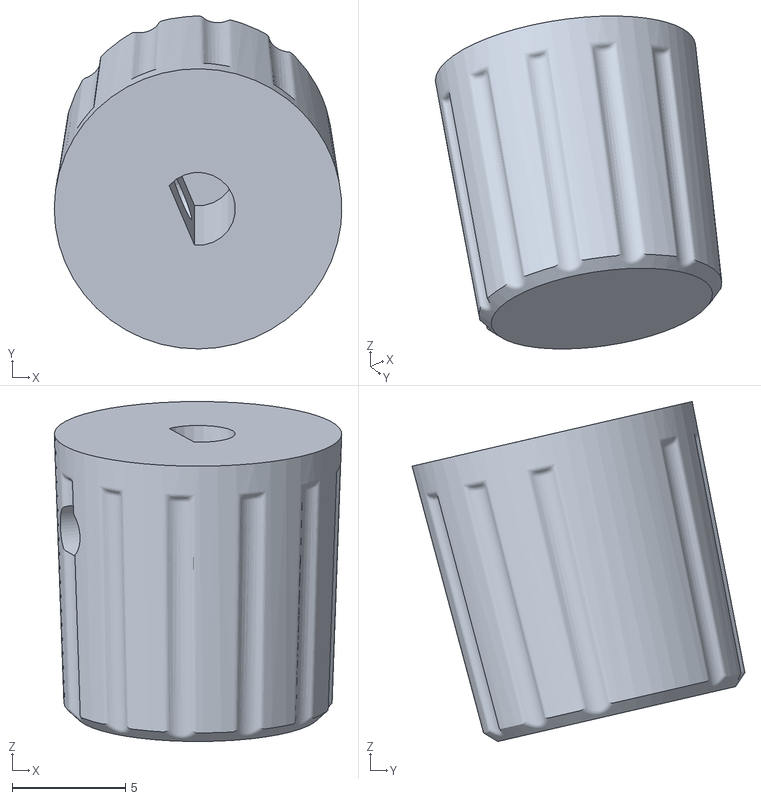
[picture p37: CAD file, 2020-11-07]
release/2_Upper Instrument Panel/manufacturing/3D Printed/OH1A3A-19 - DDI MS21382-0XNX (MODIFIED).stl
12.7 x 14.7 x 15.0
