petersawka/OpenHornet/release/2_Upper Instrument Panel/manufacturing/3D Printed/OH1A7A-11 - Spin Panel Lightplate.STL

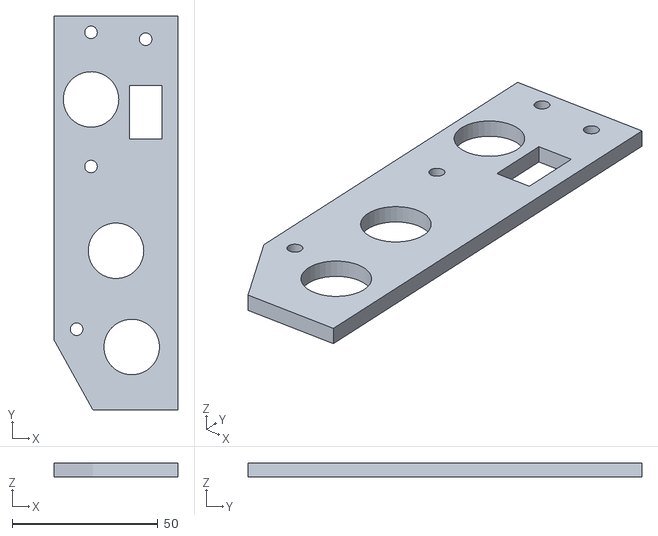
[picture p38: CAD file, 2020-11-07]
release/2_Upper Instrument Panel/manufacturing/3D Printed/OH1A7A-11 - Spin Panel Lightplate.STL
42.5 x 135.1 x 4.76
