petersawka/OpenHornet/MCAD/Right Console - Right AUX Spacer.sldprt

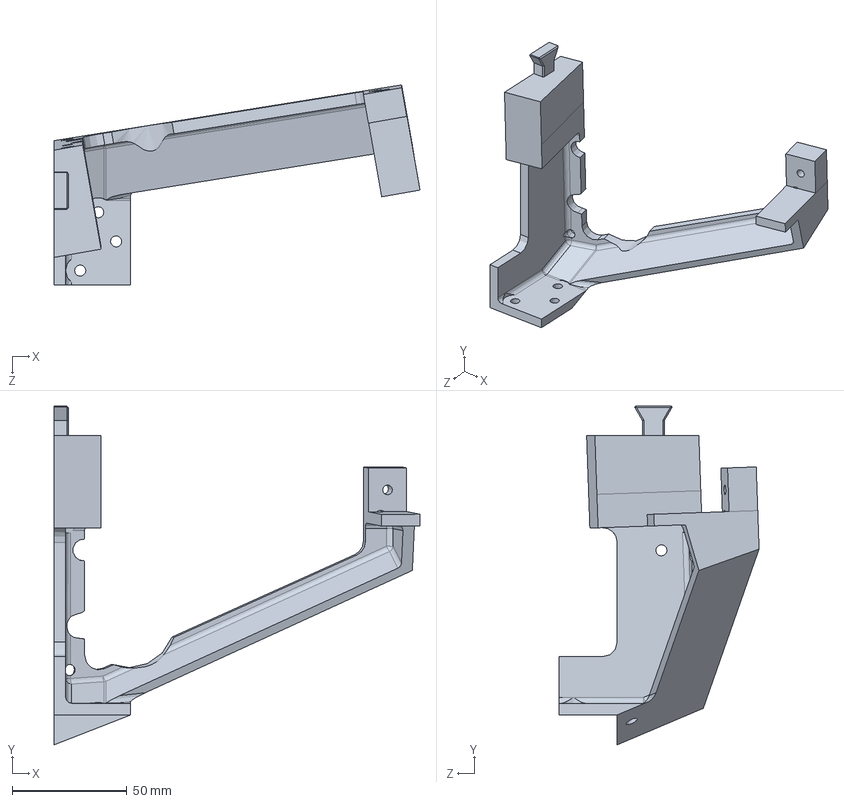
[picture p39: CAD file, 2020-11-07]
MCAD/Right Console - Right AUX Spacer.sldprt
159.5 x 147.7 x 87.3 mm
