petersawka/OpenHornet/release/2_Upper Instrument Panel/manufacturing/3D Printed/OH1A8A1A-17 - UFC COMM Knob.STL

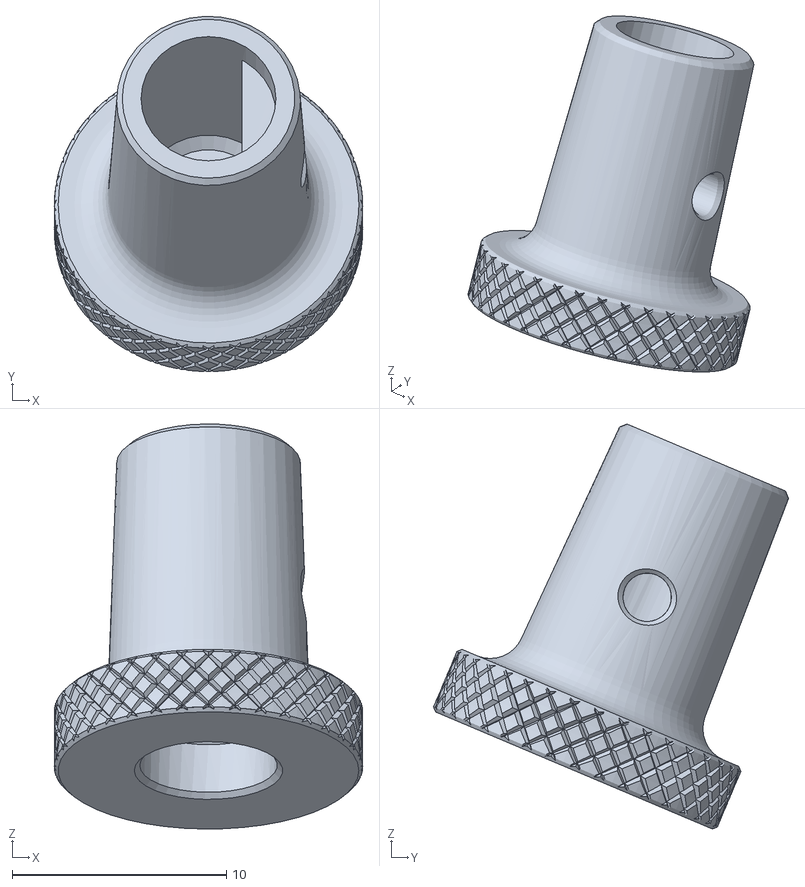
[picture p40: CAD file, 2020-11-07]
release/2_Upper Instrument Panel/manufacturing/3D Printed/OH1A8A1A-17 - UFC COMM Knob.STL
14.4 x 16.6 x 18.9
