petersawka/OpenHornet/MCAD/Left AUX Vent Plug.sldprt

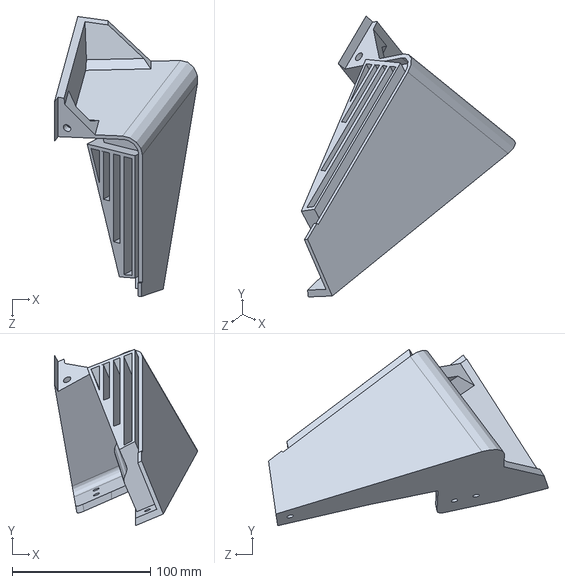
[picture p41: CAD file, 2020-11-07]
MCAD/Left AUX Vent Plug.sldprt
103.4 x 127.6 x 202.3 mm
