petersawka/OpenHornet/release/2_Upper Instrument Panel/manufacturing/3D Printed/OH1A4A-13 - Pushbutton Indicator Standoff.STL

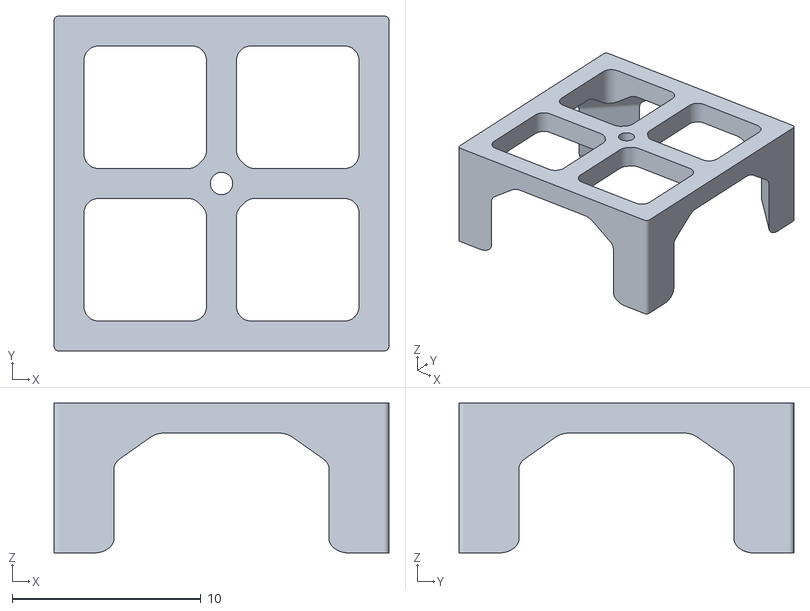
[picture p42: CAD file, 2020-11-07]
release/2_Upper Instrument Panel/manufacturing/3D Printed/OH1A4A-13 - Pushbutton Indicator Standoff.STL
17.7 x 17.7 x 7.94
