petersawka/OpenHornet/release/2_Upper Instrument Panel/manufacturing/3D Printed/OH1A7A-20 - Spin Indicator Body.STL

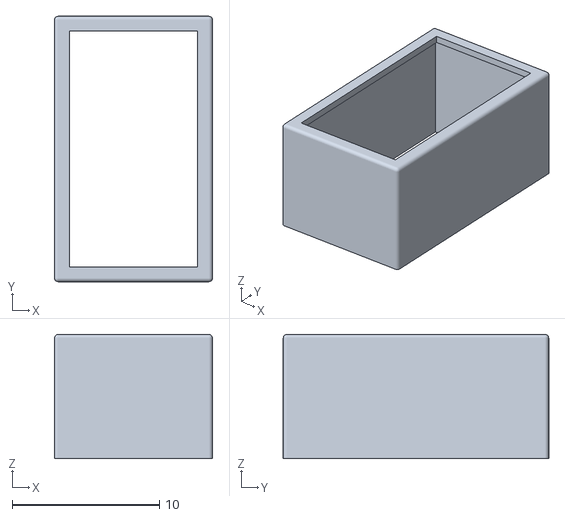
[picture p43: CAD file, 2020-11-07]
release/2_Upper Instrument Panel/manufacturing/3D Printed/OH1A7A-20 - Spin Indicator Body.STL
10.7 x 18.0 x 8.45
