petersawka/OpenHornet/MCAD/SNSR Panel Backplate.sldprt

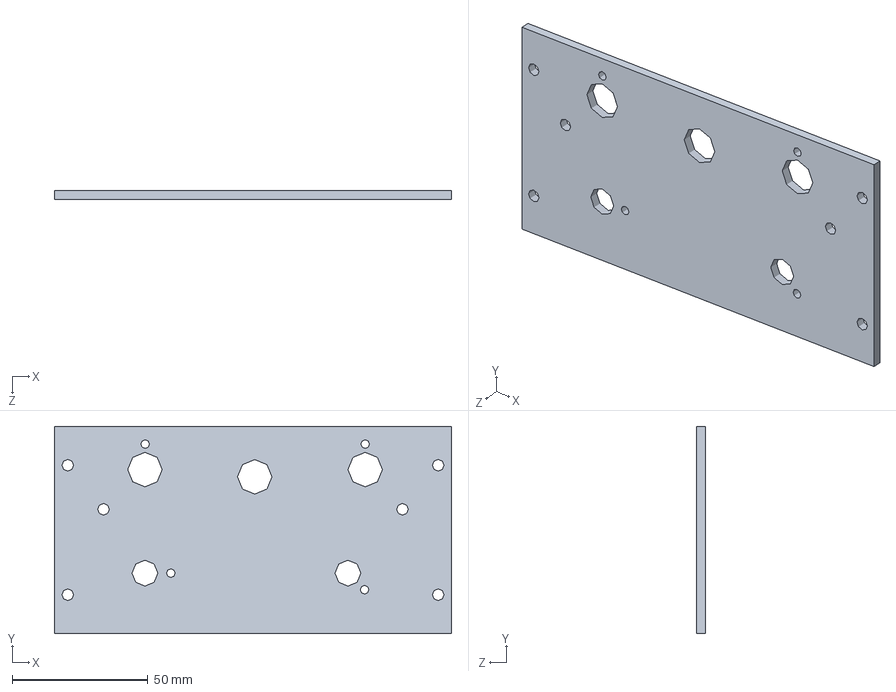
[picture p44: CAD file, 2020-11-07]
MCAD/SNSR Panel Backplate.sldprt
146.1 x 76.2 x 3.17 mm
