petersawka/OpenHornet/release/2_Upper Instrument Panel/manufacturing/3D Printed/OH1A-108 - Upper UIP Face Mount, Right.stl

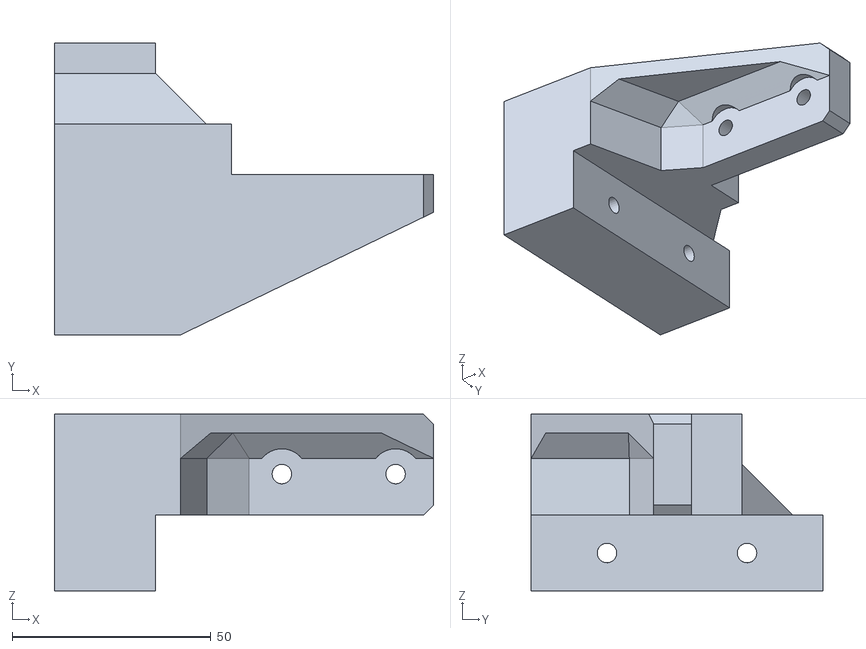
[picture p45: CAD file, 2020-11-07]
release/2_Upper Instrument Panel/manufacturing/3D Printed/OH1A-108 - Upper UIP Face Mount, Right.stl
95.3 x 73.3 x 44.5
