petersawka/OpenHornet/release/2_Upper Instrument Panel/manufacturing/3D Printed/OH1A8A3A-10 - AP Module FWD Body.STL

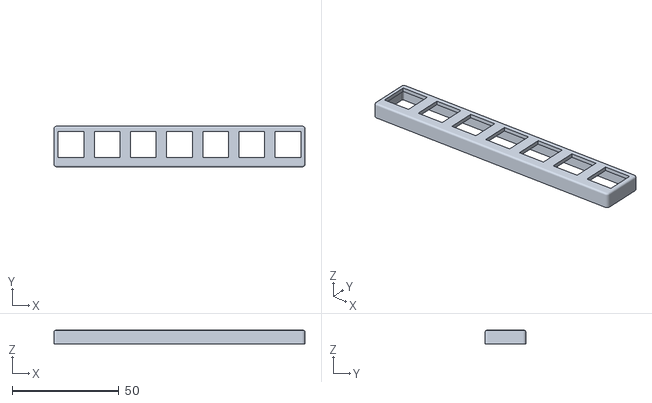
[picture p46: CAD file, 2020-11-07]
release/2_Upper Instrument Panel/manufacturing/3D Printed/OH1A8A3A-10 - AP Module FWD Body.STL
117.5 x 19.1 x 6.35
