petersawka/OpenHornet/MCAD/Left AUX Support Bracket, Lower, Outboard.sldprt

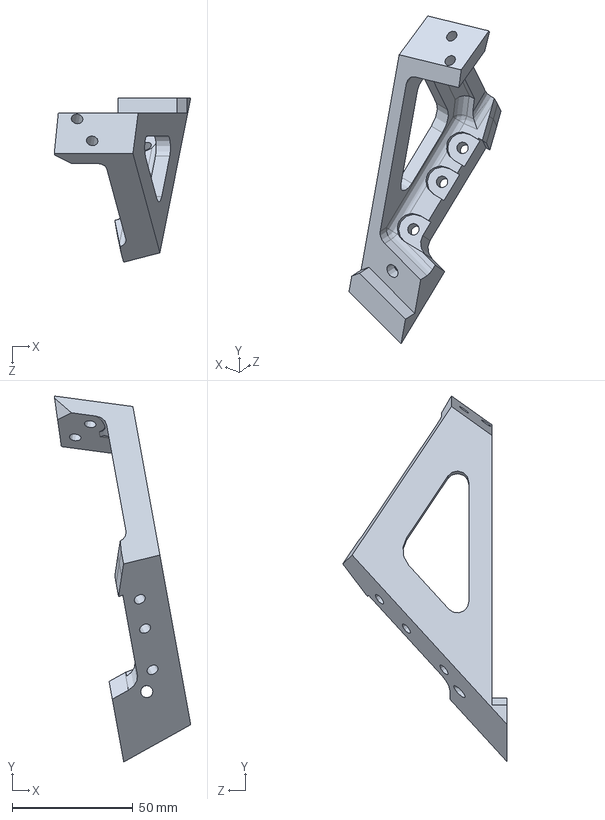
[picture p47: CAD file, 2020-11-07]
MCAD/Left AUX Support Bracket, Lower, Outboard.sldprt
56.5 x 151.5 x 68.1 mm
