petersawka/OpenHornet/release/2_Upper Instrument Panel/manufacturing/3D Printed/OH1A4A-12 - EWI Light Channels, Left.STL

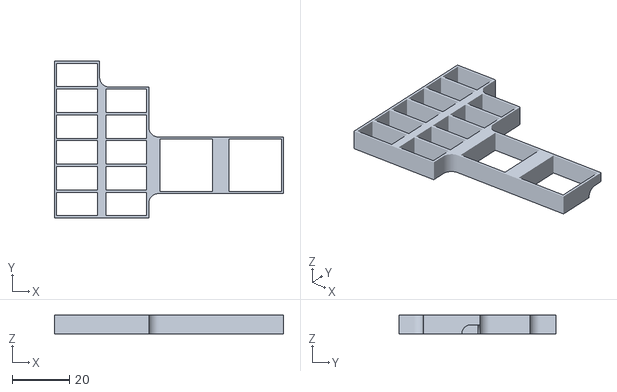
[picture p48: CAD file, 2020-11-07]
release/2_Upper Instrument Panel/manufacturing/3D Printed/OH1A4A-12 - EWI Light Channels, Left.STL
79.8 x 54.6 x 6.53
