petersawka/OpenHornet/release/2_Upper Instrument Panel/manufacturing/3D Printed/OH1A2A-10 - Master Arm Legend Plate.STL

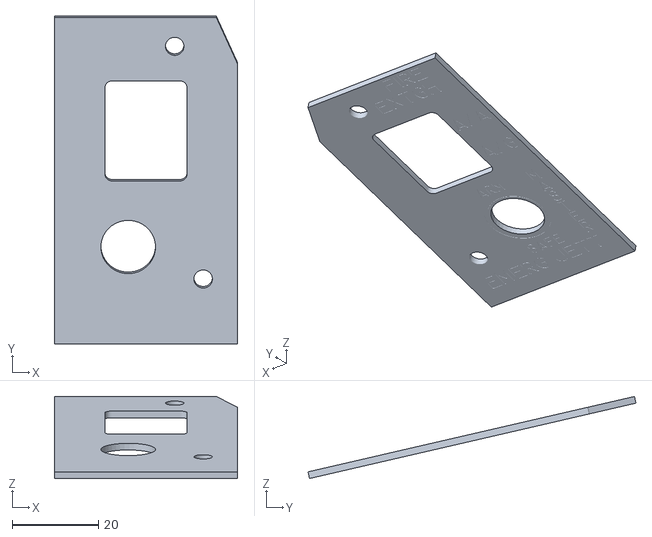
[picture p49: CAD file, 2020-11-07]
release/2_Upper Instrument Panel/manufacturing/3D Printed/OH1A2A-10 - Master Arm Legend Plate.STL
42.5 x 76.2 x 19.0
