petersawka/OpenHornet/release/2_Upper Instrument Panel/manufacturing/3D Printed/OH1A-109 - UIP Display Pressure Foot.stl

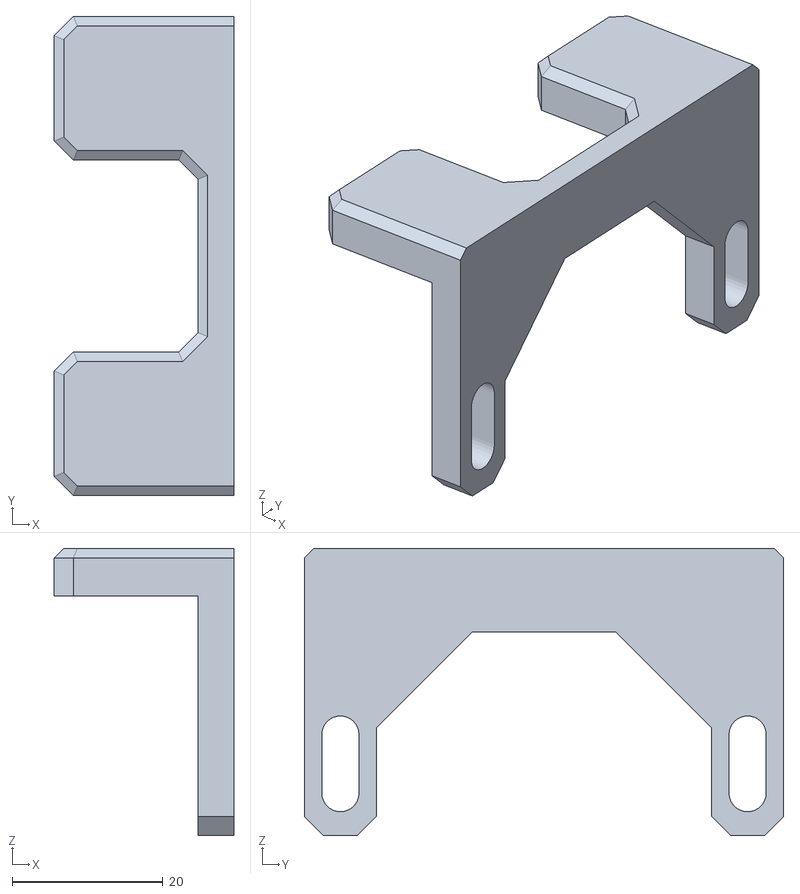
[picture p50: CAD file, 2020-11-07]
release/2_Upper Instrument Panel/manufacturing/3D Printed/OH1A-109 - UIP Display Pressure Foot.stl
23.8 x 63.5 x 38.1
