petersawka/OpenHornet/MCAD/Right Console Floor.sldprt

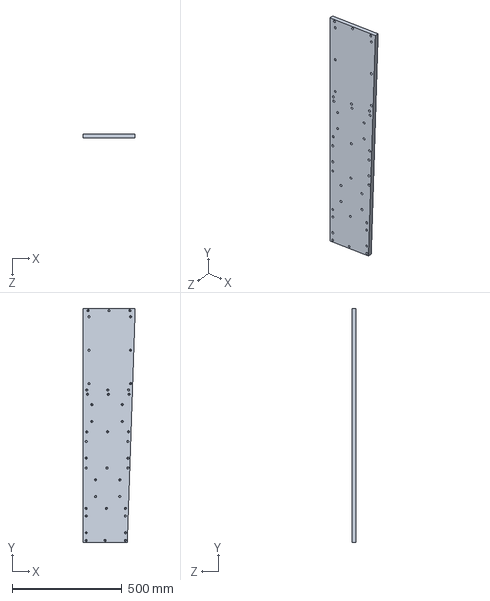
[picture p51: CAD file, 2020-11-07]
MCAD/Right Console Floor.sldprt
239.3 x 1066.8 x 19.1 mm
