petersawka/OpenHornet/release/2_Upper Instrument Panel/manufacturing/3D Printed/OH1A8A1A-18 - UFC COMM Bezel.STL

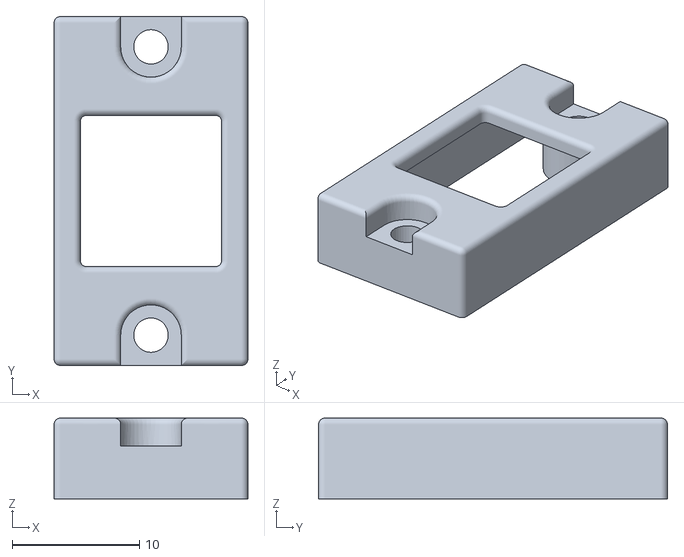
[picture p52: CAD file, 2020-11-07]
release/2_Upper Instrument Panel/manufacturing/3D Printed/OH1A8A1A-18 - UFC COMM Bezel.STL
15.2 x 27.4 x 6.35
