petersawka/OpenHornet/MCAD/ECS Panel Backplate.sldprt

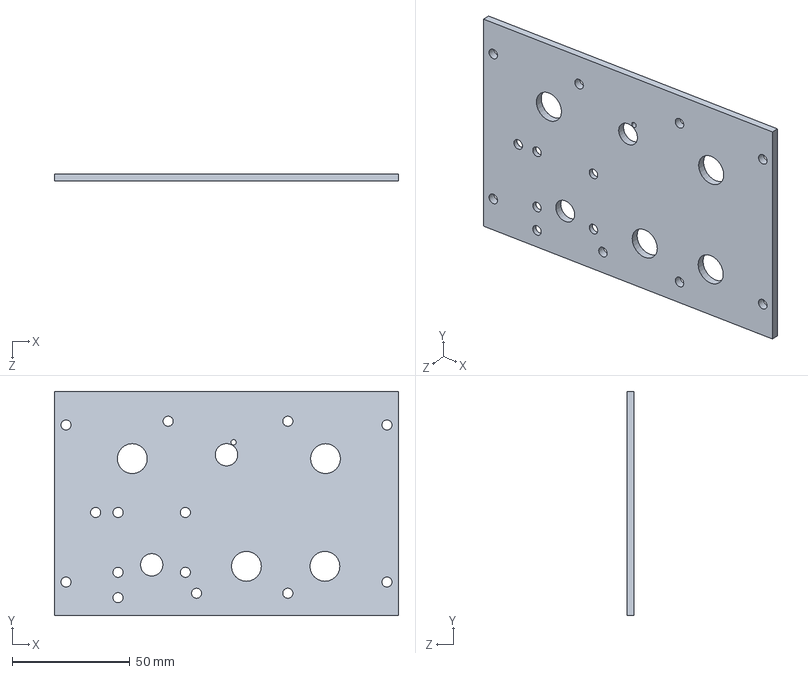
[picture p53: CAD file, 2020-11-07]
MCAD/ECS Panel Backplate.sldprt
146.1 x 95.2 x 3.17 mm
