petersawka/OpenHornet/release/2_Upper Instrument Panel/manufacturing/3D Printed/OH1A3A-15 - DDI Fingerguards, Right Clipped.STL

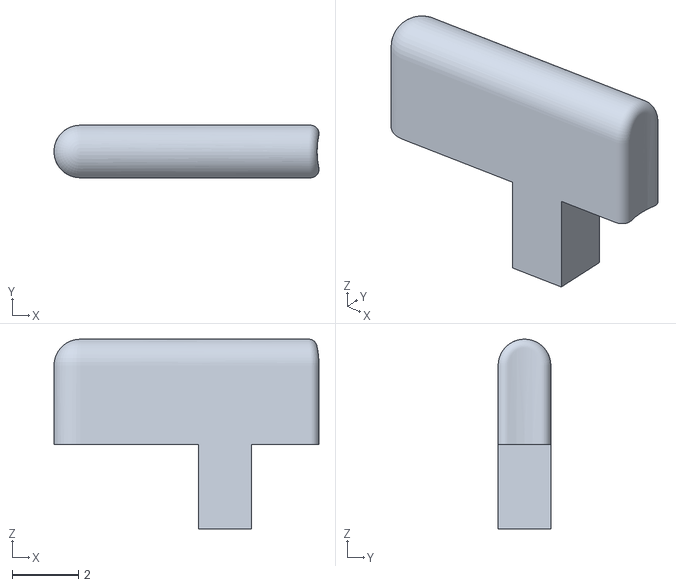
[picture p54: CAD file, 2020-11-07]
release/2_Upper Instrument Panel/manufacturing/3D Printed/OH1A3A-15 - DDI Fingerguards, Right Clipped.STL
7.98 x 1.59 x 5.72
