petersawka/OpenHornet/MCAD/KY58 Panel FWD Legend Plate.sldprt

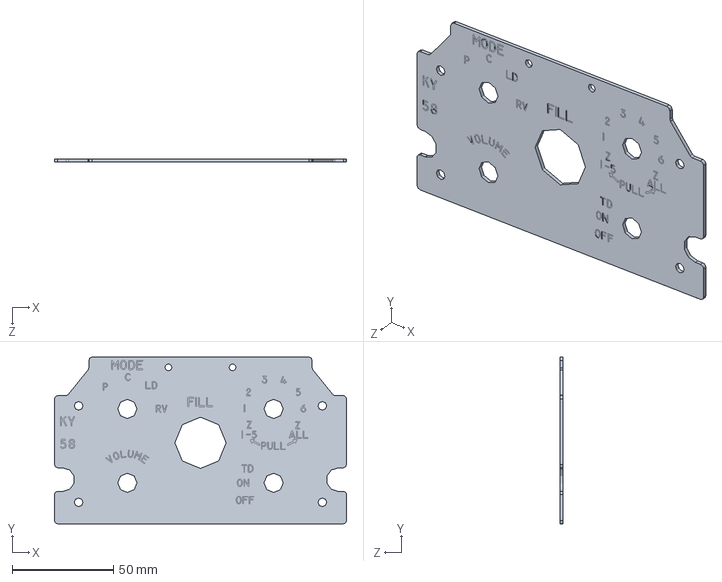
[picture p55: CAD file, 2020-11-07]
MCAD/KY58 Panel FWD Legend Plate.sldprt
144.5 x 82.6 x 1.59 mm
