petersawka/OpenHornet/release/2_Upper Instrument Panel/manufacturing/3D Printed/OH1A8A1A-24 - UFC Scratchpad Bezel.STL

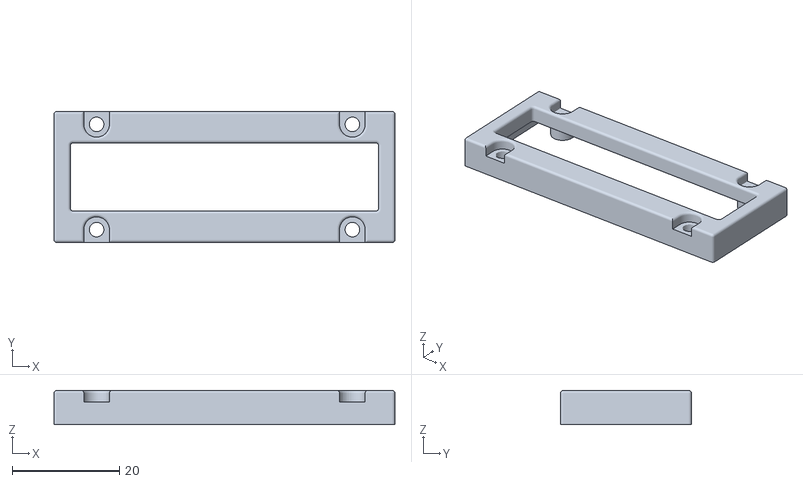
[picture p56: CAD file, 2020-11-07]
release/2_Upper Instrument Panel/manufacturing/3D Printed/OH1A8A1A-24 - UFC Scratchpad Bezel.STL
63.5 x 24.4 x 6.35
