petersawka/OpenHornet/MCAD/SNSR Panel Lightplate.sldprt

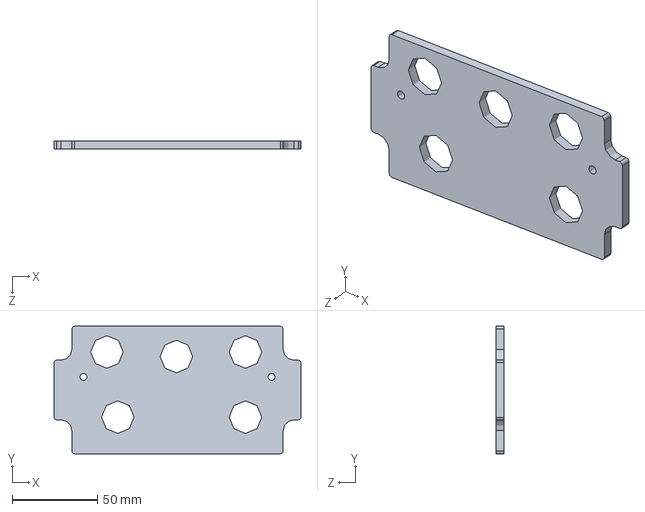
[picture p57: CAD file, 2020-11-07]
MCAD/SNSR Panel Lightplate.sldprt
144.5 x 74.6 x 4.76 mm
