petersawka/OpenHornet/release/2_Upper Instrument Panel/manufacturing/3D Printed/OH1A2A-40 - EMERG JETT Housing.STL

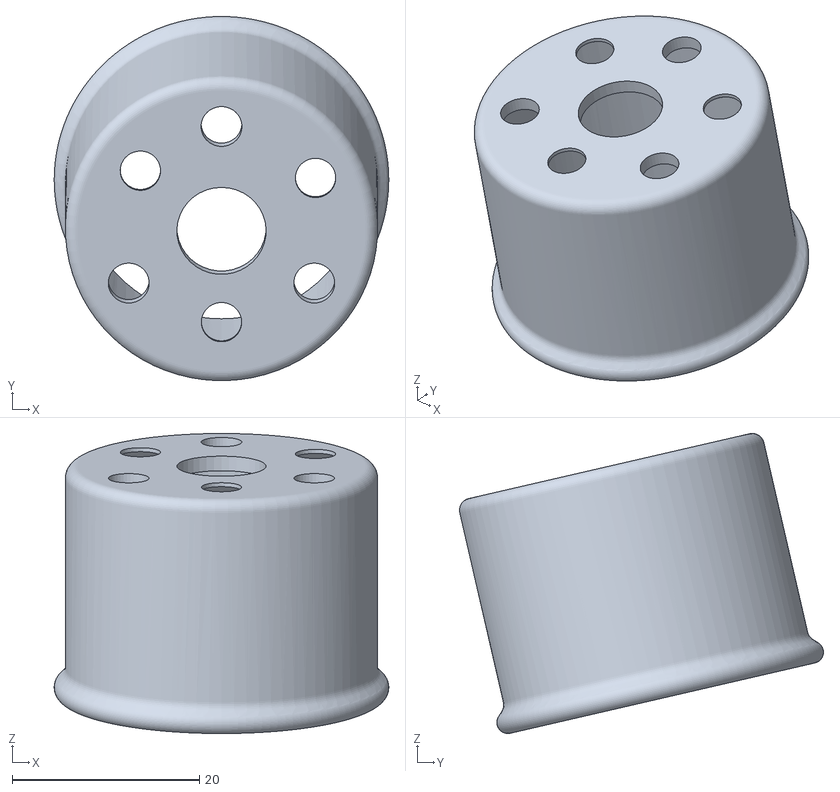
[picture p58: CAD file, 2020-11-07]
release/2_Upper Instrument Panel/manufacturing/3D Printed/OH1A2A-40 - EMERG JETT Housing.STL
35.7 x 38.8 x 32.0
