petersawka/OpenHornet/release/2_Upper Instrument Panel/manufacturing/3D Printed/OH1A-114 - HUD Panel Cnnection Bracket.stl

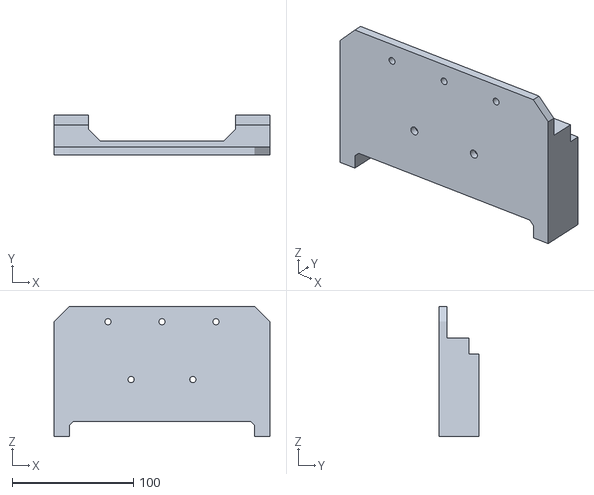
[picture p59: CAD file, 2020-11-07]
release/2_Upper Instrument Panel/manufacturing/3D Printed/OH1A-114 - HUD Panel Cnnection Bracket.stl
177.8 x 32.6 x 107.3
