petersawka/OpenHornet/MCAD/KY58 Panel AFT Lightplate.sldprt

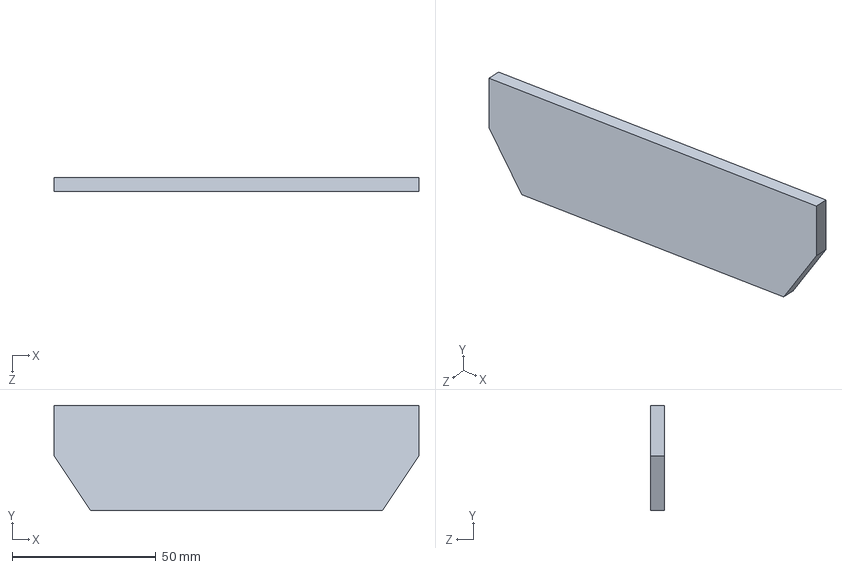
[picture p60: CAD file, 2020-11-07]
MCAD/KY58 Panel AFT Lightplate.sldprt
127.0 x 36.6 x 4.76 mm
