petersawka/OpenHornet/release/2_Upper Instrument Panel/manufacturing/3D Printed/OH1A8A2A-15 - KNOB, MS21387.stl

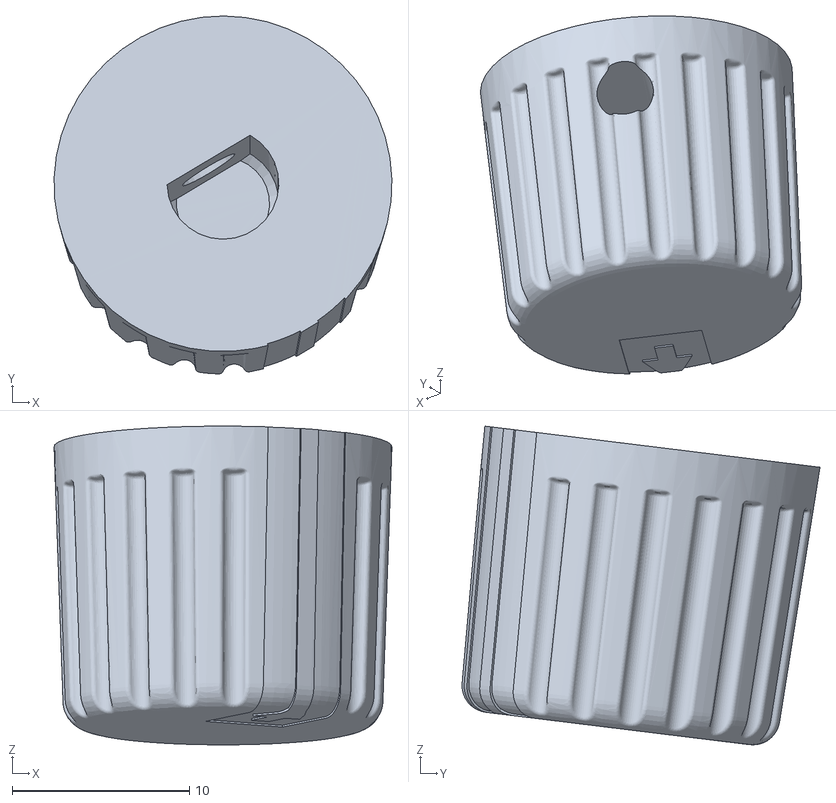
[picture p61: CAD file, 2020-11-07]
release/2_Upper Instrument Panel/manufacturing/3D Printed/OH1A8A2A-15 - KNOB, MS21387.stl
19.0 x 20.2 x 18.0
