petersawka/OpenHornet/release/2_Upper Instrument Panel/manufacturing/3D Printed/OH1A8A1A-27 - UFC Square Button.STL

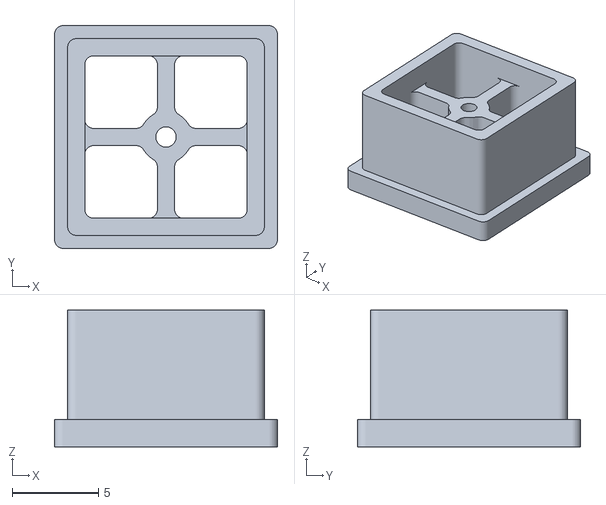
[picture p62: CAD file, 2020-11-07]
release/2_Upper Instrument Panel/manufacturing/3D Printed/OH1A8A1A-27 - UFC Square Button.STL
13.0 x 13.0 x 7.94
