petersawka/OpenHornet/release/2_Upper Instrument Panel/manufacturing/3D Printed/OH1A6A-12 - EWI Light Channels, Right.STL

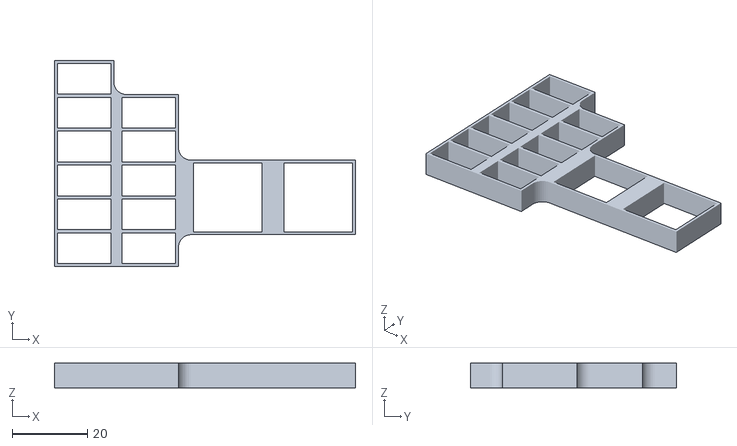
[picture p63: CAD file, 2020-11-07]
release/2_Upper Instrument Panel/manufacturing/3D Printed/OH1A6A-12 - EWI Light Channels, Right.STL
79.8 x 54.6 x 6.53
