petersawka/OpenHornet/release/3_Lower Instrument Panel/Manufacturing/CNC/LIP .75 inch Parts/.75 DXF Drawings/Center Pedestal Lower Mount.dxf

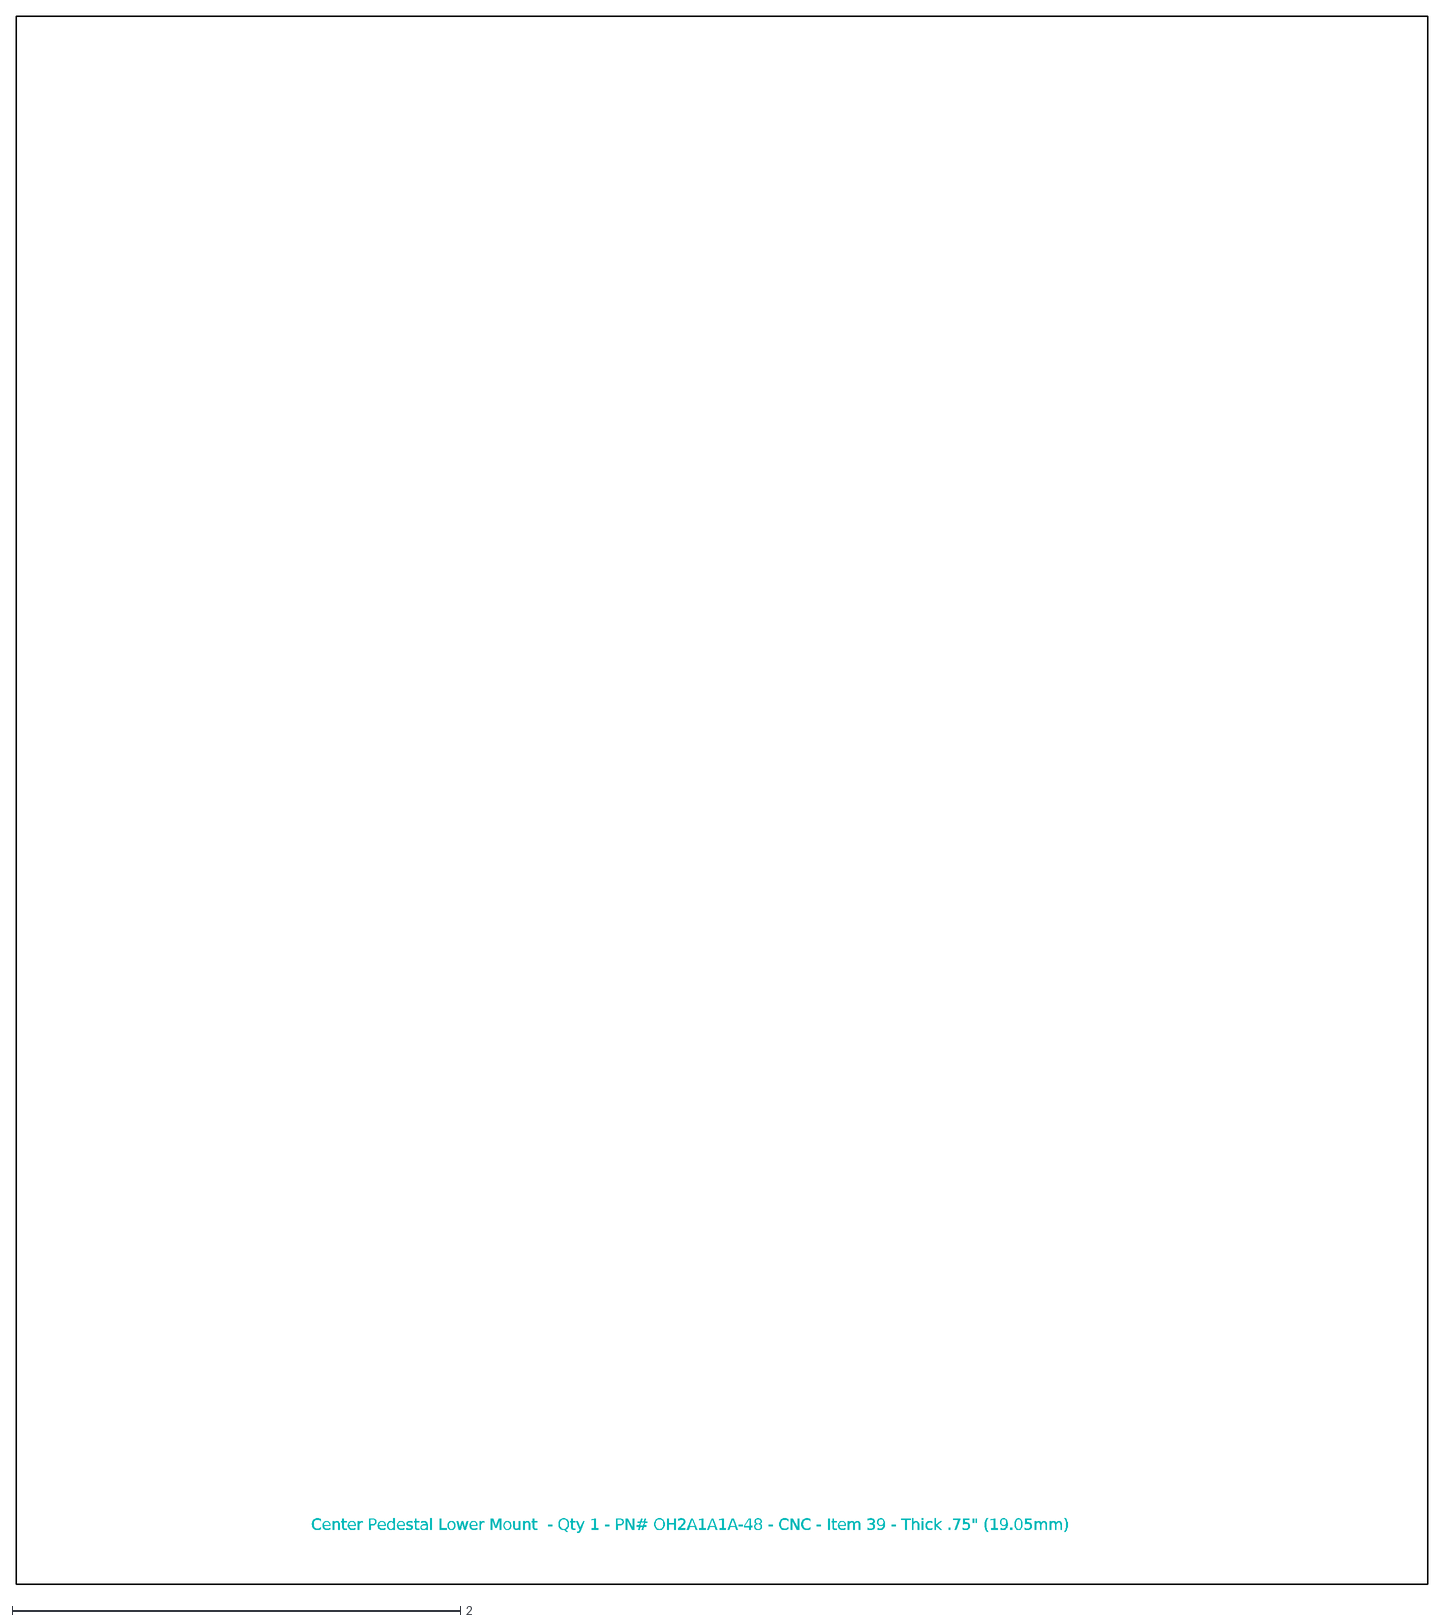
[picture p64: CAD file, 2020-11-07]
release/3_Lower Instrument Panel/Manufacturing/CNC/LIP .75 inch Parts/.75 DXF Drawings/Center Pedestal Lower Mount.dxf
Center Pedestal Lower Mount - Qty 1 - PN# OH2A1A1A-48 - CNC - Item 39 - Thick .75" (19.05mm)
