petersawka/OpenHornet/MCAD/KY58 Panel Backplate.sldprt

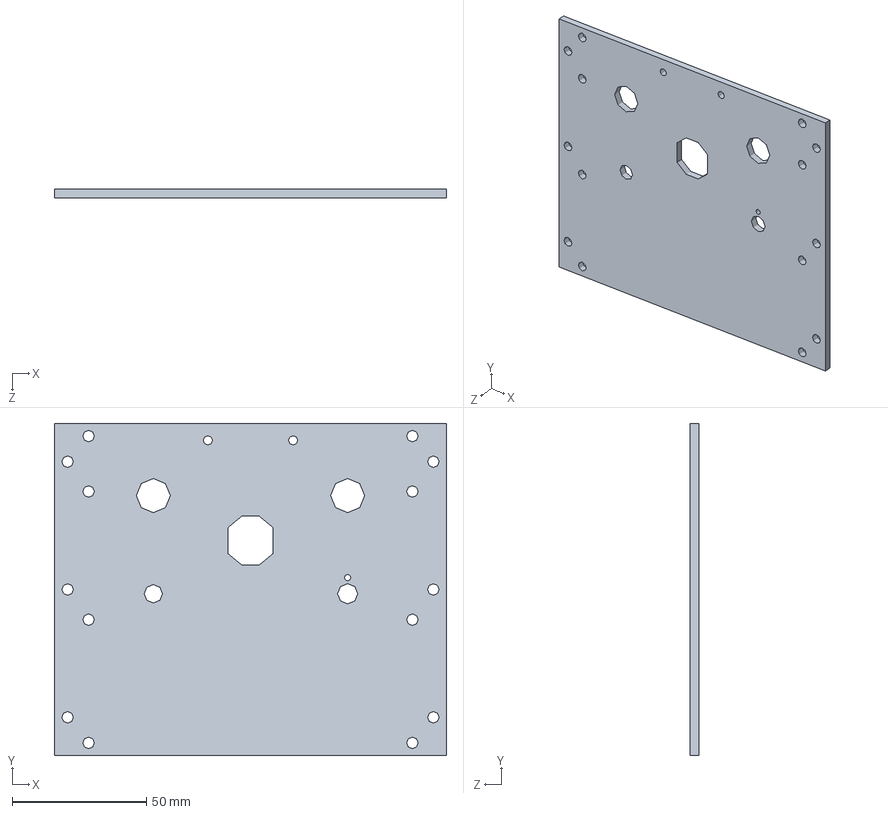
[picture p65: CAD file, 2020-11-07]
MCAD/KY58 Panel Backplate.sldprt
146.1 x 123.8 x 3.17 mm
