petersawka/OpenHornet/release/2_Upper Instrument Panel/manufacturing/3D Printed/OH1A8A4A-11 - HUD BIT Box Lid.STL

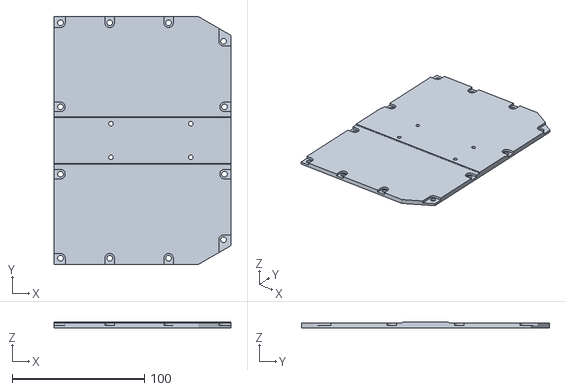
[picture p67: CAD file, 2020-11-07]
release/2_Upper Instrument Panel/manufacturing/3D Printed/OH1A8A4A-11 - HUD BIT Box Lid.STL
133.3 x 187.3 x 4.60
