petersawka/OpenHornet/release/2_Upper Instrument Panel/manufacturing/3D Printed/OH1A8A1A-48 - UFC COMM Matrixing Plate.STL

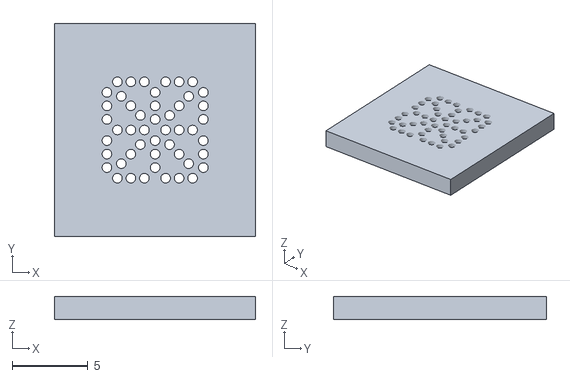
[picture p68: CAD file, 2020-11-07]
release/2_Upper Instrument Panel/manufacturing/3D Printed/OH1A8A1A-48 - UFC COMM Matrixing Plate.STL
13.2 x 14.0 x 1.52
