petersawka/OpenHornet/release/2_Upper Instrument Panel/manufacturing/3D Printed/OH1A8A1A-43 - UFC Round Button Guard.STL

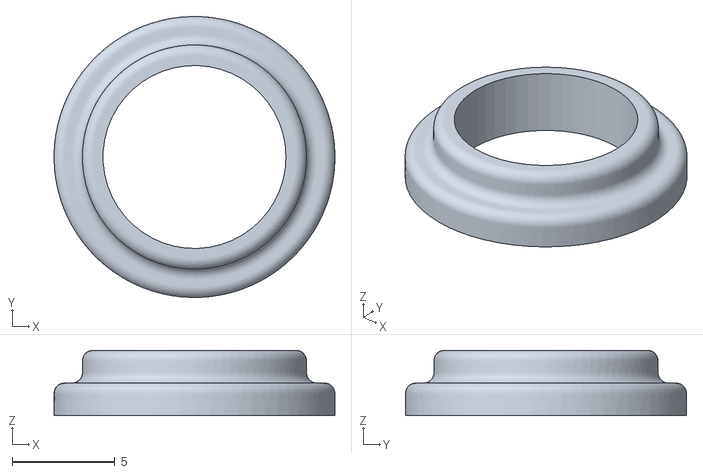
[picture p69: CAD file, 2020-11-07]
release/2_Upper Instrument Panel/manufacturing/3D Printed/OH1A8A1A-43 - UFC Round Button Guard.STL
13.7 x 13.7 x 3.18
