petersawka/OpenHornet/release/2_Upper Instrument Panel/manufacturing/3D Printed/OH1A-116 - MFD Lower Support A, Right.stl

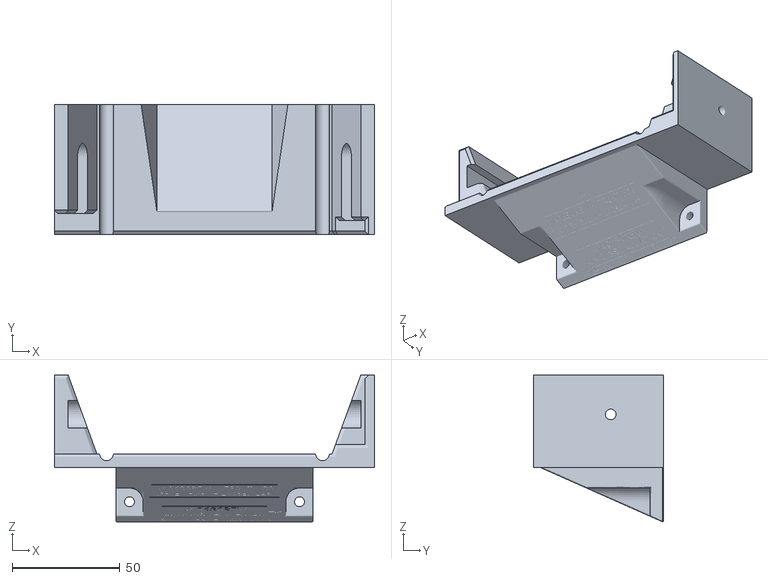
[picture p70: CAD file, 2020-11-07]
release/2_Upper Instrument Panel/manufacturing/3D Printed/OH1A-116 - MFD Lower Support A, Right.stl
148.2 x 60.3 x 68.0
