petersawka/OpenHornet/MCAD/Korry BP246-A1B1 v3.sldprt

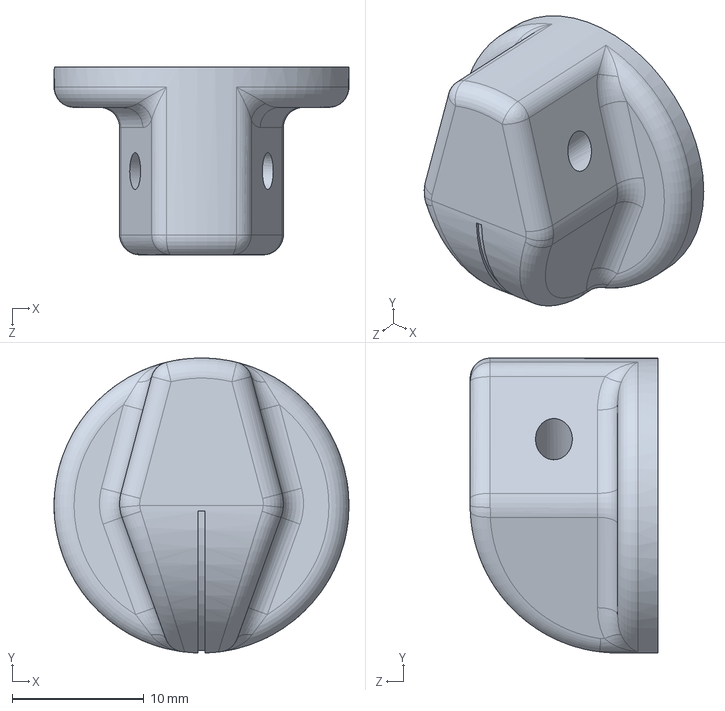
[picture p71: CAD file, 2020-11-07]
MCAD/Korry BP246-A1B1 v3.sldprt
22.4 x 22.3 x 14.2 mm
