petersawka/OpenHornet/release/2_Upper Instrument Panel/manufacturing/3D Printed/OH1A8A4A-10 - HUD BIT BOX.STL

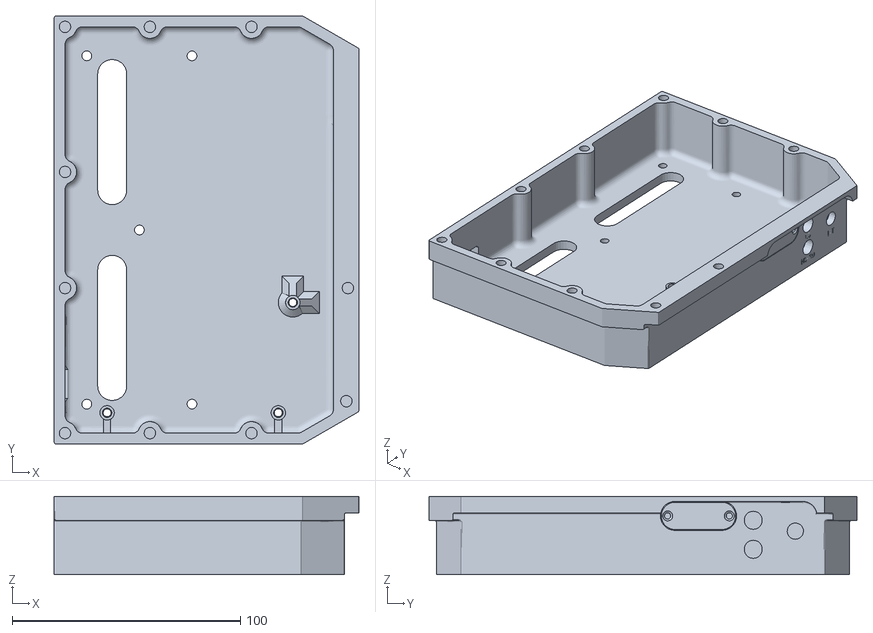
[picture p72: CAD file, 2020-11-07]
release/2_Upper Instrument Panel/manufacturing/3D Printed/OH1A8A4A-10 - HUD BIT BOX.STL
133.3 x 187.3 x 34.3
