petersawka/OpenHornet/release/2_Upper Instrument Panel/manufacturing/3D Printed/OH1A2A-21 - Master Mode Pushbutton Bezel.STL

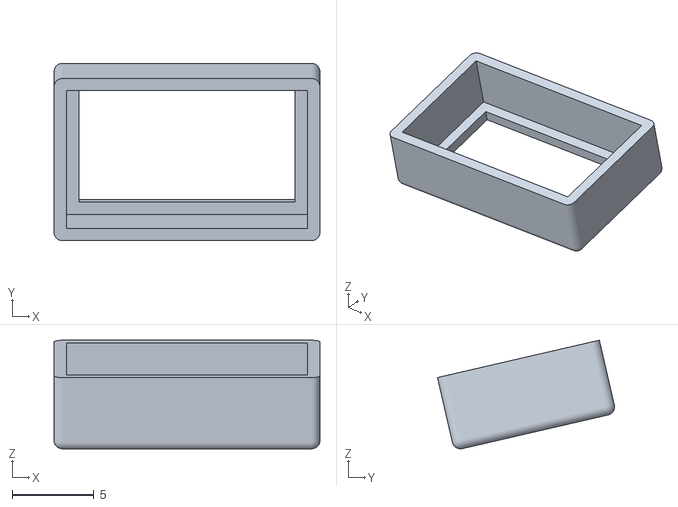
[picture p73: CAD file, 2020-11-07]
release/2_Upper Instrument Panel/manufacturing/3D Printed/OH1A2A-21 - Master Mode Pushbutton Bezel.STL
16.3 x 10.8 x 6.64
