petersawka/OpenHornet/MCAD/Upper Instrument Panel Mount.sldprt

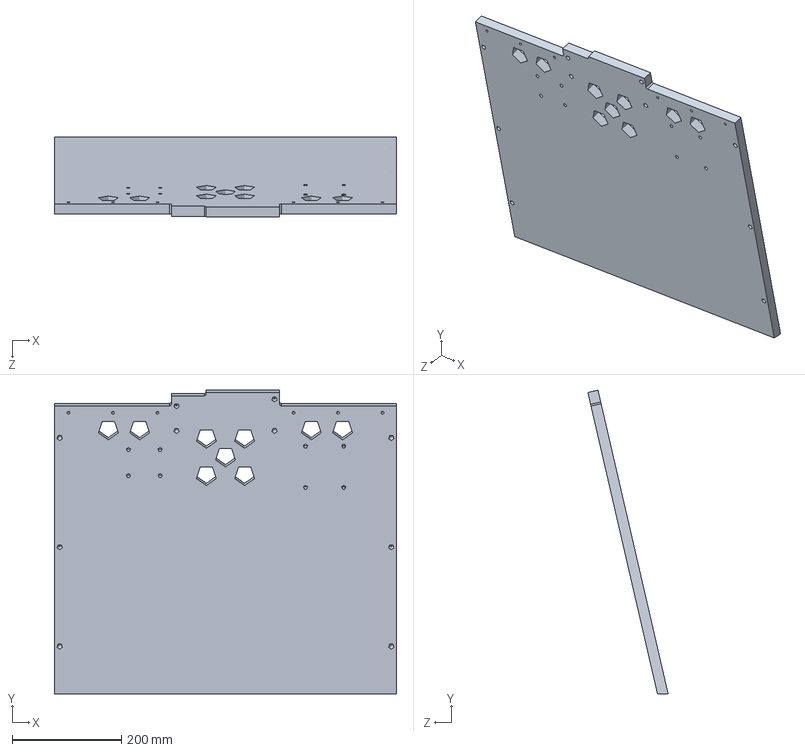
[picture p74: CAD file, 2020-11-07]
MCAD/Upper Instrument Panel Mount.sldprt
624.8 x 554.9 x 146.7 mm
