petersawka/OpenHornet/release/2_Upper Instrument Panel/manufacturing/3D Printed/OH1A6A-10 - EWI Legend Plate, Right.STL

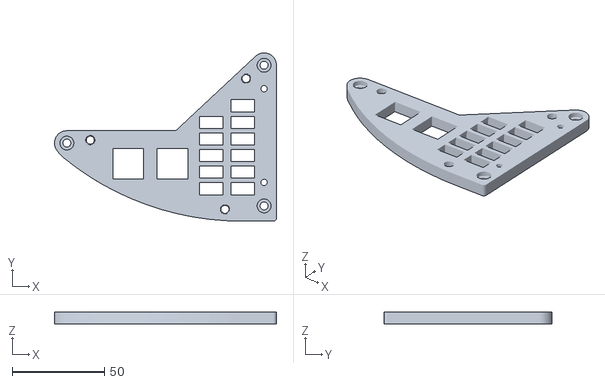
[picture p75: CAD file, 2020-11-07]
release/2_Upper Instrument Panel/manufacturing/3D Printed/OH1A6A-10 - EWI Legend Plate, Right.STL
120.4 x 91.2 x 6.35
