petersawka/OpenHornet/release/2_Upper Instrument Panel/manufacturing/3D Printed/OH1A3A-13 - DDI Fingerguards.STL

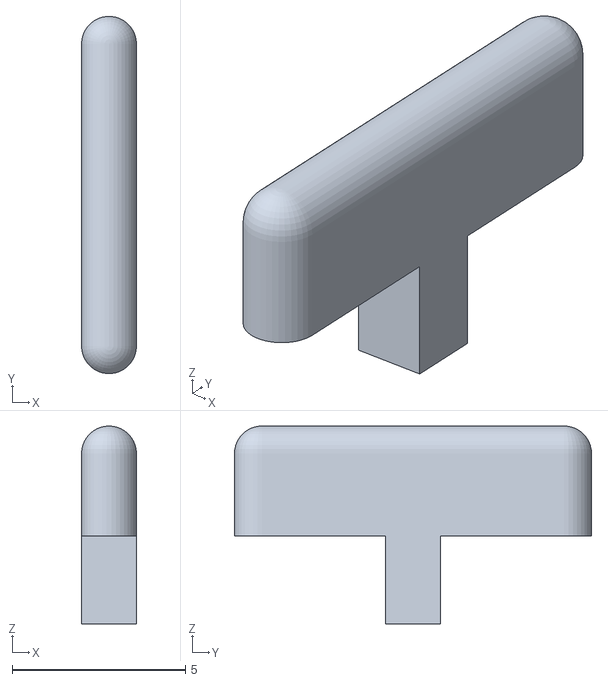
[picture p76: CAD file, 2020-11-07]
release/2_Upper Instrument Panel/manufacturing/3D Printed/OH1A3A-13 - DDI Fingerguards.STL
1.59 x 10.3 x 5.72
