petersawka/OpenHornet/MCAD/200MSPxT1B1M1QE.SLDPRT

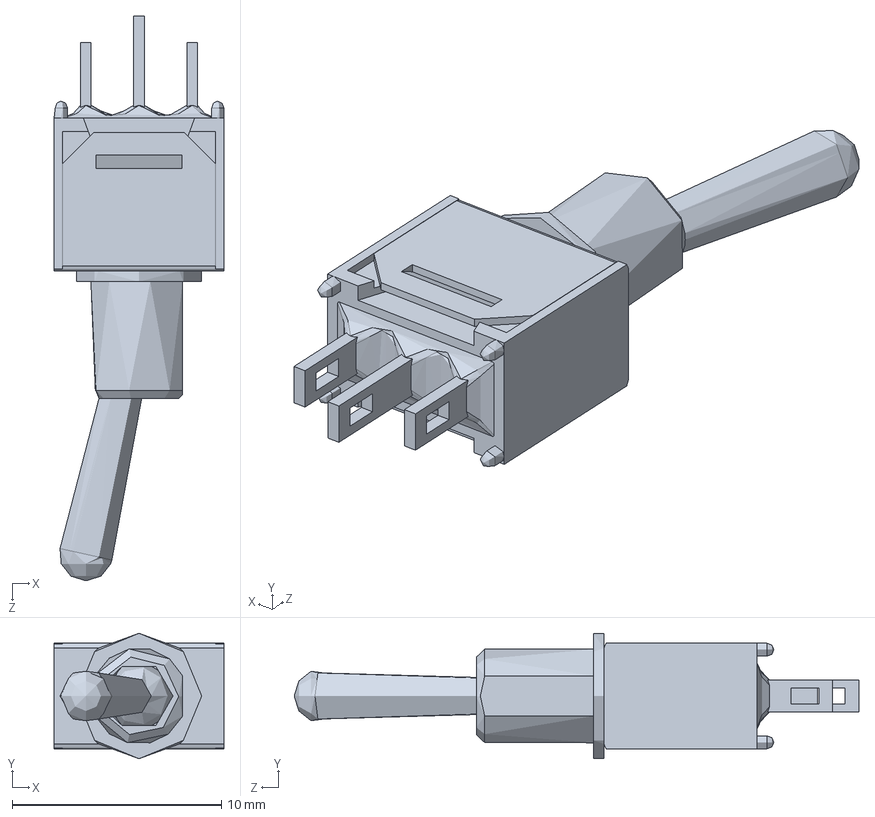
[picture p77: CAD file, 2020-11-07]
MCAD/200MSPxT1B1M1QE.SLDPRT
8.13 x 6.00 x 27.0 mm
