petersawka/OpenHornet/release/2_Upper Instrument Panel/manufacturing/3D Printed/OH1A-112 - MFD Lower Support C.stl

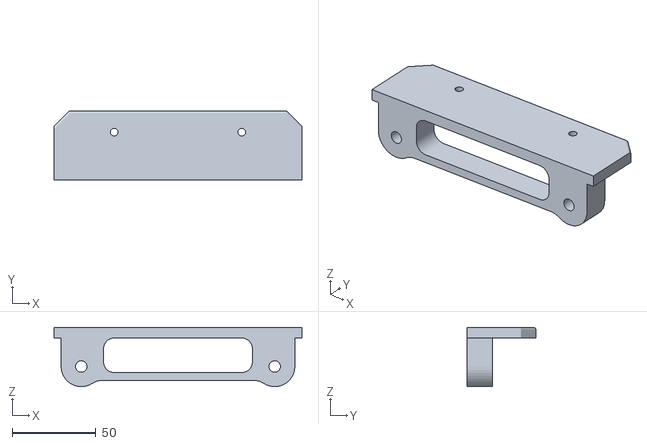
[picture p78: CAD file, 2020-11-07]
release/2_Upper Instrument Panel/manufacturing/3D Printed/OH1A-112 - MFD Lower Support C.stl
148.2 x 41.3 x 35.4
