petersawka/OpenHornet/release/2_Upper Instrument Panel/manufacturing/3D Printed/OH1A2A-33 - .55 SQ Indicator Actuator.STL

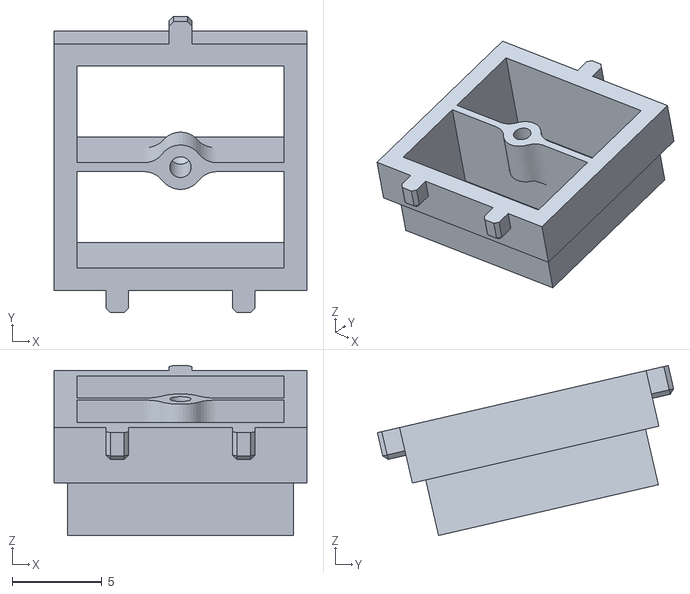
[picture p79: CAD file, 2020-11-07]
release/2_Upper Instrument Panel/manufacturing/3D Printed/OH1A2A-33 - .55 SQ Indicator Actuator.STL
14.1 x 16.5 x 9.47
