petersawka/OpenHornet/MCAD/G-H Right Outboard Spacer.sldprt

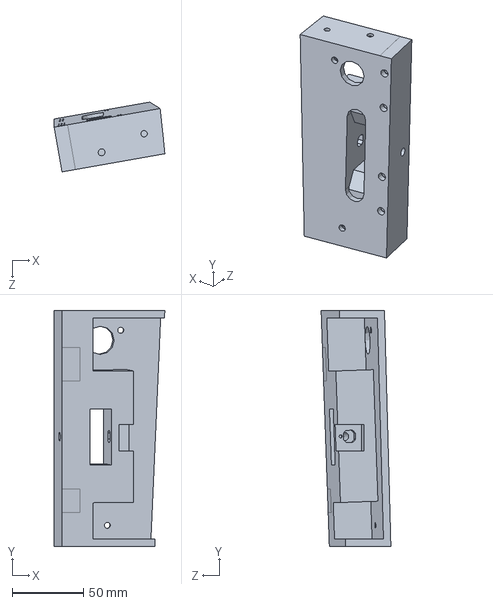
[picture p80: CAD file, 2020-11-07]
MCAD/G-H Right Outboard Spacer.sldprt
77.4 x 165.1 x 48.8 mm
