petersawka/OpenHornet/release/2_Upper Instrument Panel/manufacturing/3D Printed/OH1A8A2A-14 - KNOB, TS3750.stl

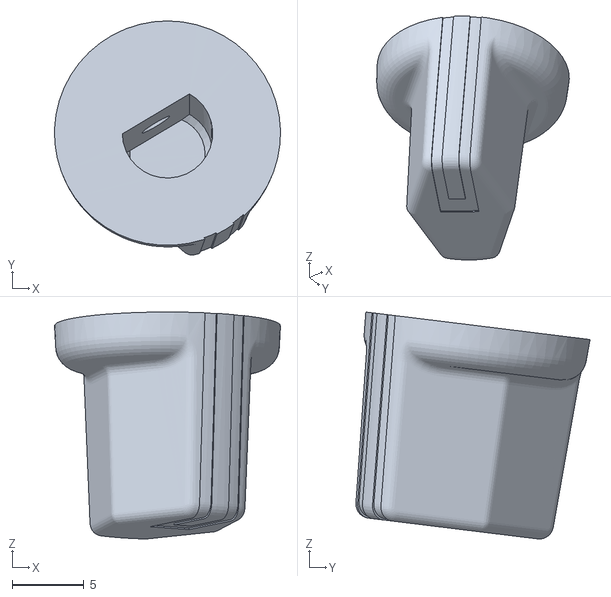
[picture p81: CAD file, 2020-11-07]
release/2_Upper Instrument Panel/manufacturing/3D Printed/OH1A8A2A-14 - KNOB, TS3750.stl
15.7 x 16.3 x 15.8
