petersawka/OpenHornet/release/2_Upper Instrument Panel/manufacturing/3D Printed/OH1A8A1A-16 - FWD UFC Guard.STL.stl

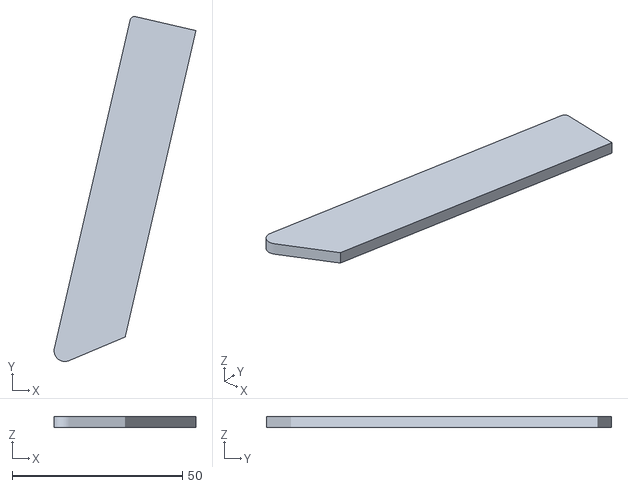
[picture p82: CAD file, 2020-11-07]
release/2_Upper Instrument Panel/manufacturing/3D Printed/OH1A8A1A-16 - FWD UFC Guard.STL.stl
41.7 x 101.4 x 3.17
