petersawka/OpenHornet/release/2_Upper Instrument Panel/manufacturing/3D Printed/OH1A8A1A-28 - UFC Round Button.STL

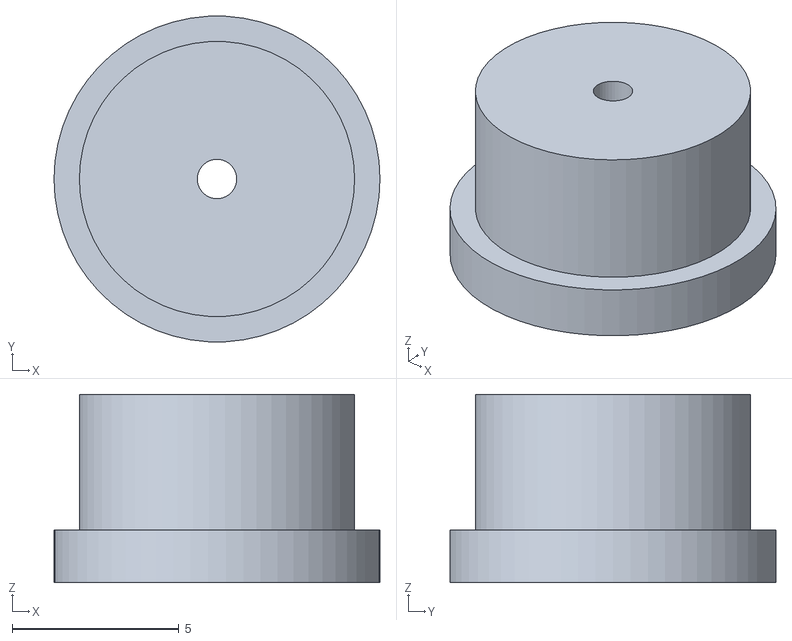
[picture p83: CAD file, 2020-11-07]
release/2_Upper Instrument Panel/manufacturing/3D Printed/OH1A8A1A-28 - UFC Round Button.STL
9.78 x 9.76 x 5.65
