petersawka/OpenHornet/release/2_Upper Instrument Panel/manufacturing/3D Printed/OH1A2A-13 - Master Arm Module Spacer.STL

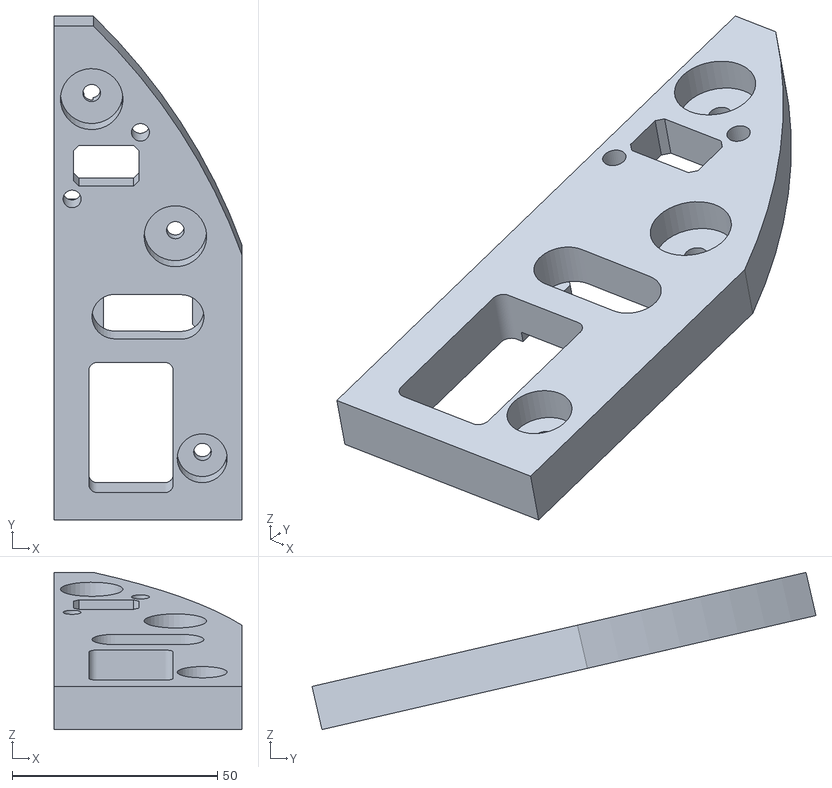
[picture p84: CAD file, 2020-11-07]
release/2_Upper Instrument Panel/manufacturing/3D Printed/OH1A2A-13 - Master Arm Module Spacer.STL
45.7 x 122.8 x 38.3
