petersawka/OpenHornet/MCAD/KY58 Panel FWD Lightplate.sldprt

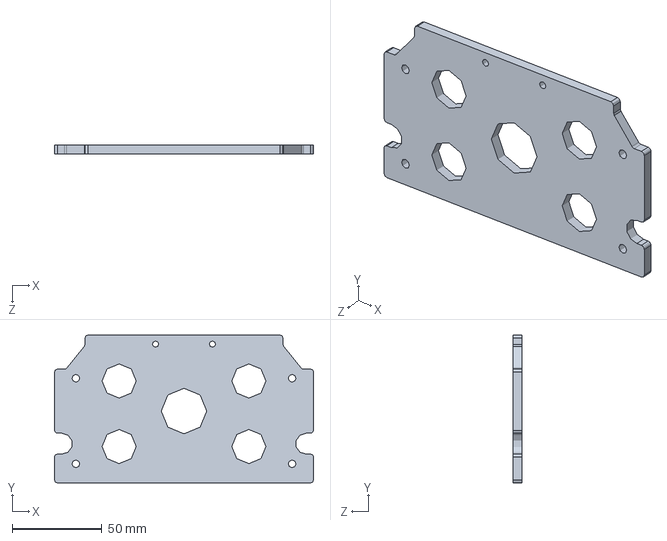
[picture p85: CAD file, 2020-11-07]
MCAD/KY58 Panel FWD Lightplate.sldprt
144.5 x 82.6 x 4.76 mm
