petersawka/OpenHornet/release/2_Upper Instrument Panel/manufacturing/3D Printed/OH1A6A-11 - EWI Chassis, Right.STL

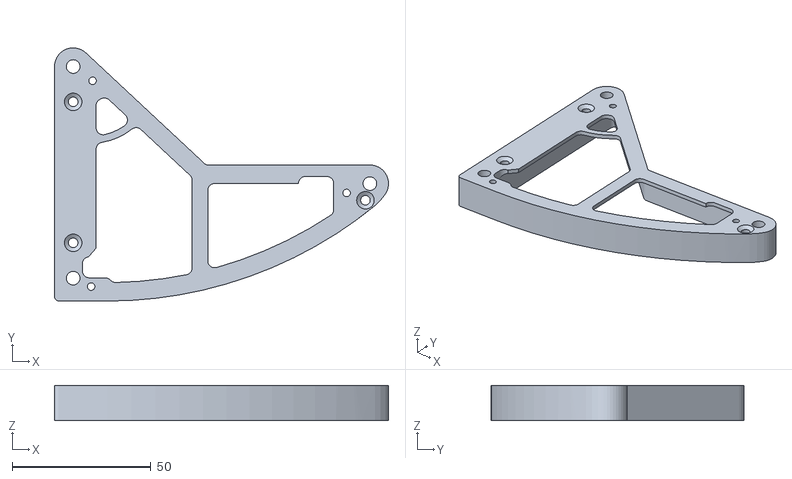
[picture p86: CAD file, 2020-11-07]
release/2_Upper Instrument Panel/manufacturing/3D Printed/OH1A6A-11 - EWI Chassis, Right.STL
120.4 x 91.2 x 12.7
