petersawka/OpenHornet/MCAD/Primary Rib H.sldprt

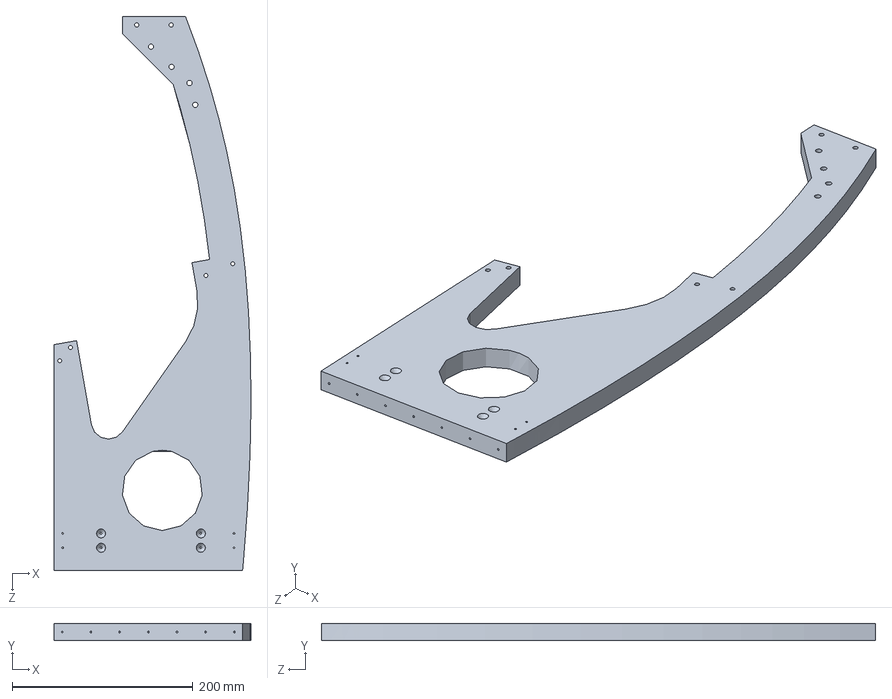
[picture p87: CAD file, 2020-11-07]
MCAD/Primary Rib H.sldprt
218.0 x 19.1 x 613.5 mm
