petersawka/OpenHornet/MCAD/Primary Rib B.sldprt

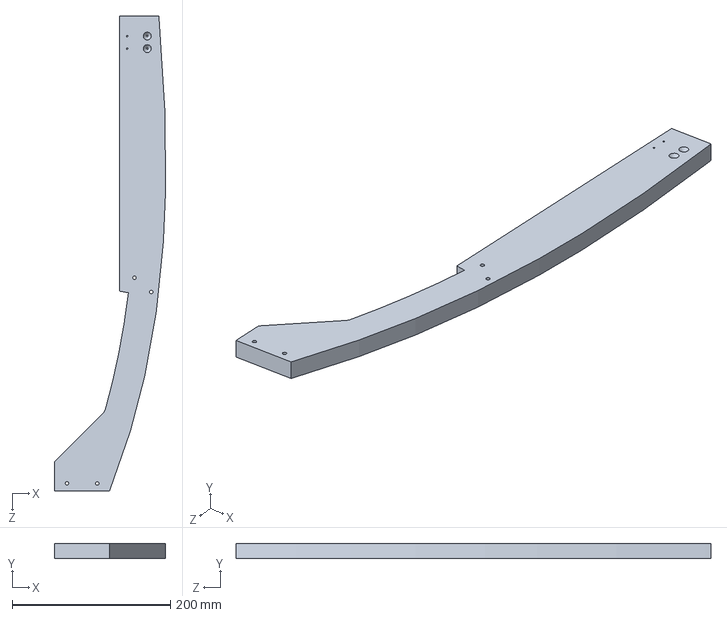
[picture p88: CAD file, 2020-11-07]
MCAD/Primary Rib B.sldprt
140.4 x 19.1 x 599.7 mm
