petersawka/OpenHornet/release/2_Upper Instrument Panel/manufacturing/3D Printed/OH1A3A-16 - DDI Mounting Spacer.STL

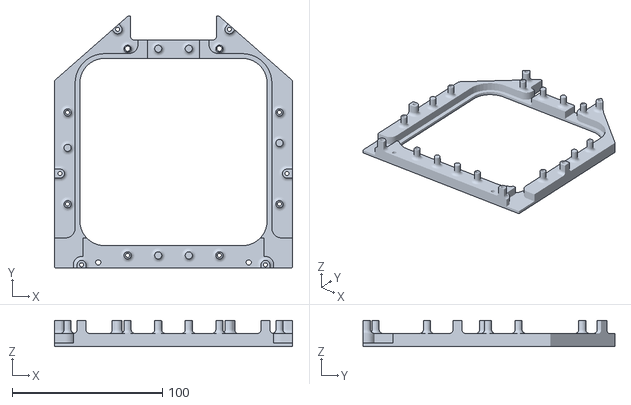
[picture p89: CAD file, 2020-11-07]
release/2_Upper Instrument Panel/manufacturing/3D Printed/OH1A3A-16 - DDI Mounting Spacer.STL
158.2 x 167.4 x 17.4
