petersawka/OpenHornet/MCAD/DEFOG Lever.SLDPRT

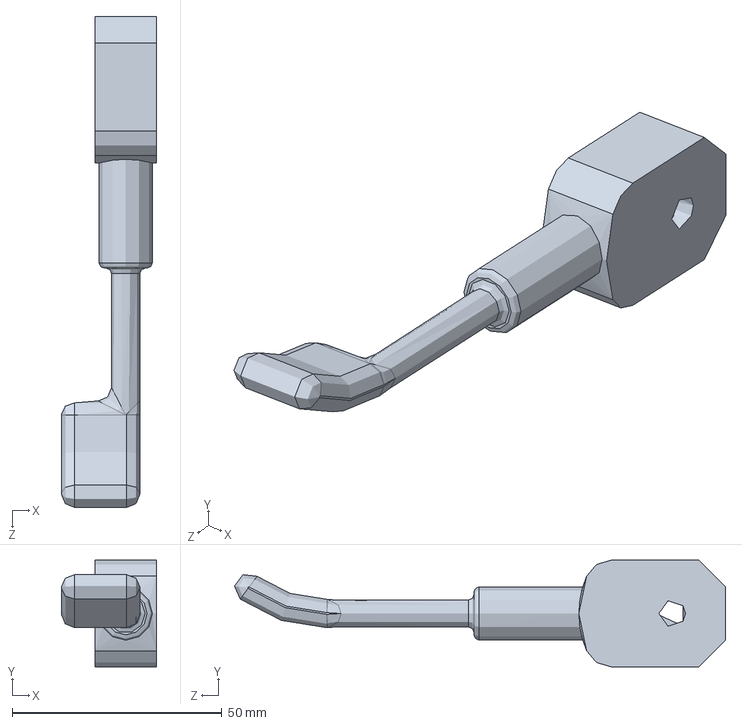
[picture p90: CAD file, 2020-11-07]
MCAD/DEFOG Lever.SLDPRT
22.7 x 25.4 x 116.9 mm
