petersawka/OpenHornet/release/2_Upper Instrument Panel/manufacturing/3D Printed/OH1A2A-12 - Master Arm Backplate.STL

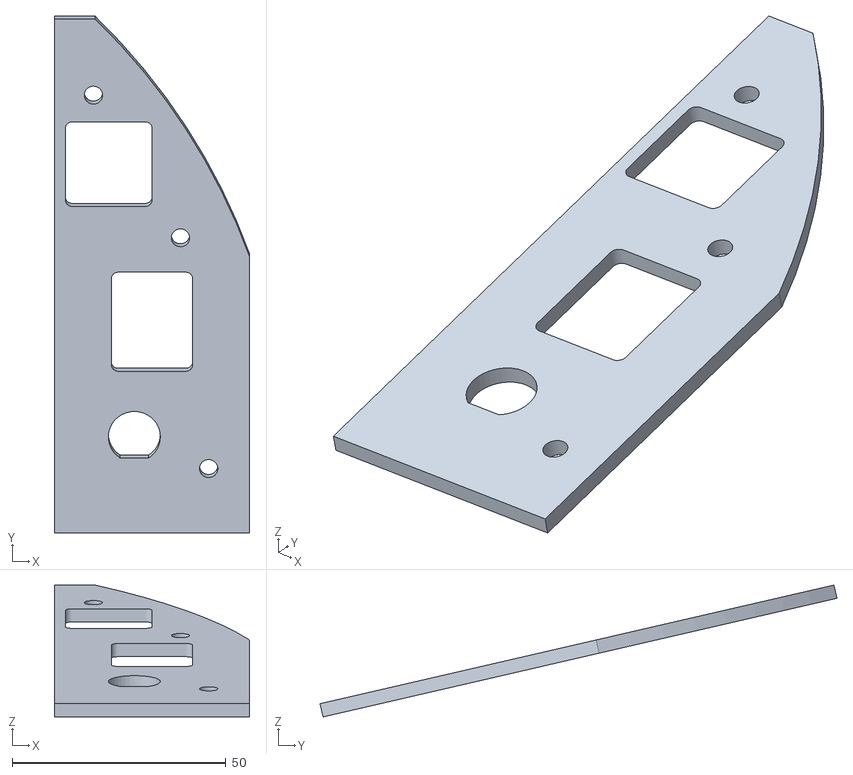
[picture p91: CAD file, 2020-11-07]
release/2_Upper Instrument Panel/manufacturing/3D Printed/OH1A2A-12 - Master Arm Backplate.STL
45.7 x 121.1 x 30.9
