petersawka/OpenHornet/MCAD/RH Seat Pan Outboard Support.sldprt

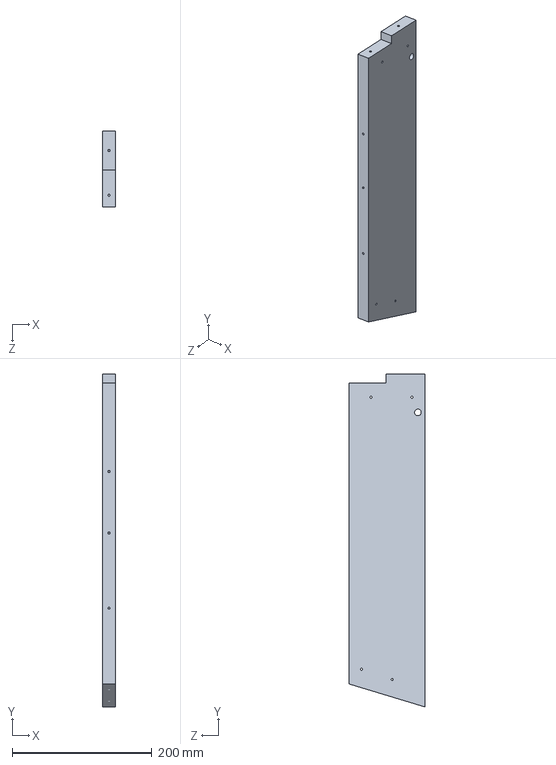
[picture p92: CAD file, 2020-11-07]
MCAD/RH Seat Pan Outboard Support.sldprt
19.0 x 477.0 x 109.3 mm
