petersawka/OpenHornet/release/2_Upper Instrument Panel/manufacturing/3D Printed/OH1A3A-10 - DDI Bezel.STL

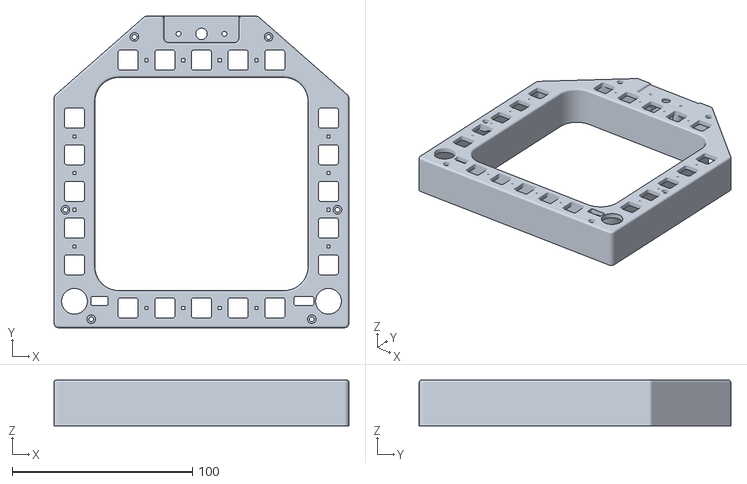
[picture p93: CAD file, 2020-11-07]
release/2_Upper Instrument Panel/manufacturing/3D Printed/OH1A3A-10 - DDI Bezel.STL
163.5 x 172.7 x 25.4
