petersawka/OpenHornet/MCAD/Left AUX Support Bracket, Lower, Inboard.sldprt

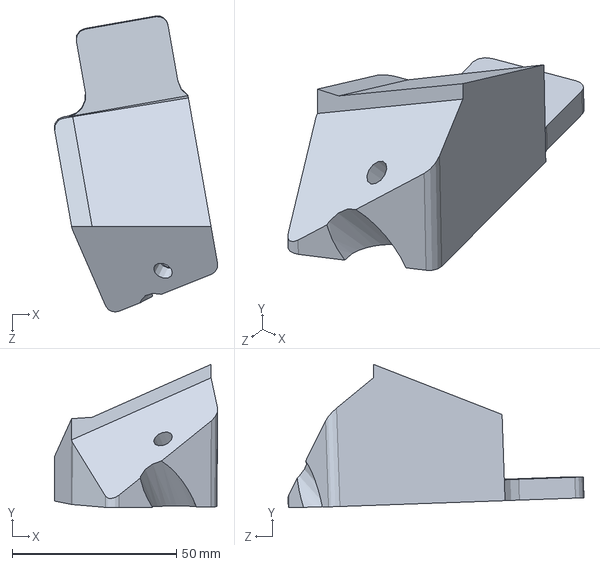
[picture p94: CAD file, 2020-11-07]
MCAD/Left AUX Support Bracket, Lower, Inboard.sldprt
49.7 x 43.7 x 90.2 mm
