petersawka/OpenHornet/(list of files, cad)

Other CAD files:
MCAD/Right Circuit Breakers.sldasm
MCAD/AV COOL Panel.sldasm
release/2_Upper Instrument Panel/manufacturing/CNC/UIP .125 inch Parts/.125 DXF Drawings/UIP Right Glareshield.dxf
release/2_Upper Instrument Panel/manufacturing/CNC/UIP .125 inch Parts/.125 Nested Parts DXF files/.125 Nested Parts.dxf
release/2_Upper Instrument Panel/manufacturing/CNC/UIP .25 inch Parts/.25 DXF Drawings/Upper Instrument Panel Face.dxf
release/2_Upper Instrument Panel/manufacturing/CNC/UIP .25 inch Parts/.25 Nested Parts DXF files/.25 Inch Nested Drawings.dxf
release/2_Upper Instrument Panel/manufacturing/CNC/UIP .50 inch Parts/.50 Nested Parts DXF files/.50 Nested Drawings.dxf
release/2_Upper Instrument Panel/manufacturing/CNC/UIP .75 inch Parts/.75 Nested Parts DXF files/.75 Nested Parts DXF.dxf
release/3_Lower Instrument Panel/Manufacturing/CNC/LIP .0625 inch Parts/.0625 DWG Drawings/0125 Nested Parts.dwg
release/3_Lower Instrument Panel/Manufacturing/CNC/LIP .0625 inch Parts/.0625 Nested Parts DXF files/0625 Nested Parts.dxf
release/3_Lower Instrument Panel/Manufacturing/CNC/LIP .125 inch Parts/.125 Nested Parts DXF files/0125 Nested Parts.dxf
release/3_Lower Instrument Panel/Manufacturing/CNC/LIP .50 inch Parts/.50 DXF Drawings/Left Outboard Bulkhead.dxf
release/3_Lower Instrument Panel/Manufacturing/CNC/LIP .50 inch Parts/.50 Nested Parts DXF files/050 Inch Nested Parts.dxf
release/3_Lower Instrument Panel/Manufacturing/CNC/LIP .75 inch Parts/.75 DXF Drawings/Left Outboard Footwell Wall.dxf
release/3_Lower Instrument Panel/Manufacturing/CNC/LIP .75 inch Parts/.75 Nested Parts DXF files/075 Inch Nested Parts.dxf
release/2_Upper Instrument Panel/manufacturing/CNC/UIP .125 inch Parts/.125 DXF Drawings/UIP Left Glareshield.DXF
release/2_Upper Instrument Panel/manufacturing/CNC/UIP .50 inch Parts/.50 DXF Drawings/UIP Left Outboard Longeron.DXF
release/2_Upper Instrument Panel/manufacturing/CNC/UIP .75 inch Parts/.75 DXF Drawings/UIP FWD Bulkhead.DXF
release/3_Lower Instrument Panel/Manufacturing/CNC/LIP .75 inch Parts/.75 DXF Drawings/Subfloor Brace D.dxf
release/2_Upper Instrument Panel/manufacturing/CNC/UIP .125 inch Parts/.125 DXF Drawings/UIP Upper HUD Box Cover.DXF
release/3_Lower Instrument Panel/Manufacturing/CNC/LIP .50 inch Parts/.50 DXF Drawings/Right Outboard Bulkhead.dxf
release/3_Lower Instrument Panel/Manufacturing/CNC/LIP .75 inch Parts/.75 DXF Drawings/Right Outboard Footwell Wall.dxf
release/2_Upper Instrument Panel/manufacturing/CNC/UIP .75 inch Parts/.75 DXF Drawings/UIP Floor.DXF
release/3_Lower Instrument Panel/Manufacturing/CNC/LIP .75 inch Parts/.75 DXF Drawings/Rib R.dxf
release/3_Lower Instrument Panel/Manufacturing/CNC/LIP .75 inch Parts/.75 DXF Drawings/Rib N.dxf
release/3_Lower Instrument Panel/Manufacturing/CNC/LIP .75 inch Parts/.75 DXF Drawings/Subfloor Brace G.dxf
release/3_Lower Instrument Panel/Manufacturing/CNC/LIP .75 inch Parts/.75 DXF Drawings/Upper Instrument Panel Mount.dxf
release/3_Lower Instrument Panel/Manufacturing/CNC/LIP .75 inch Parts/.75 DXF Drawings/Lower Instrument Panel Base.dxf
release/3_Lower Instrument Panel/Manufacturing/CNC/LIP .75 inch Parts/.75 DXF Drawings/Left LIP Canopy Sill.dxf
release/3_Lower Instrument Panel/Manufacturing/CNC/LIP .75 inch Parts/.75 DXF Drawings/Rib K.dxf
release/3_Lower Instrument Panel/Manufacturing/CNC/LIP .75 inch Parts/.75 DXF Drawings/Rib P.dxf
release/3_Lower Instrument Panel/Manufacturing/CNC/LIP .75 inch Parts/.75 DXF Drawings/Subfloor Brace H.dxf
release/3_Lower Instrument Panel/Manufacturing/CNC/LIP .75 inch Parts/.75 DXF Drawings/Missing Right Inboard Footwell Wall.dxf
MCAD/B-C Lower Stringer.sldprt
release/3_Lower Instrument Panel/Manufacturing/CNC/LIP .75 inch Parts/.75 DXF Drawings/Subfloor Brace F.dxf
release/3_Lower Instrument Panel/Manufacturing/CNC/LIP .75 inch Parts/.75 DXF Drawings/Left Footwell Floor.dxf
release/3_Lower Instrument Panel/Manufacturing/CNC/LIP .75 inch Parts/.75 DXF Drawings/Right Footwell Floor.dxf
release/3_Lower Instrument Panel/Manufacturing/CNC/LIP .75 inch Parts/.75 DXF Drawings/Subfloor Brace E.dxf
release/3_Lower Instrument Panel/Manufacturing/CNC/LIP .75 inch Parts/.75 DXF Drawings/Subfloor Brace B.dxf
release/3_Lower Instrument Panel/Manufacturing/CNC/LIP .75 inch Parts/.75 DXF Drawings/Left Inboard Footwell Wall.dxf
release/3_Lower Instrument Panel/Manufacturing/CNC/LIP .75 inch Parts/.75 DXF Drawings/Outboard Upper Right Instrument Panel Longeron.dxf
release/3_Lower Instrument Panel/Manufacturing/CNC/LIP .75 inch Parts/.75 DXF Drawings/Rib O.dxf
release/3_Lower Instrument Panel/Manufacturing/CNC/LIP .75 inch Parts/.75 DXF Drawings/Rib M.dxf
release/3_Lower Instrument Panel/Manufacturing/CNC/LIP .75 inch Parts/.75 DXF Drawings/Subfloor Brace A.dxf
release/3_Lower Instrument Panel/Manufacturing/CNC/LIP .75 inch Parts/.75 DXF Drawings/Rib Q.dxf
release/3_Lower Instrument Panel/Manufacturing/CNC/LIP .75 inch Parts/.75 DXF Drawings/Right Inboard Footwell Wall.dxf
release/3_Lower Instrument Panel/Manufacturing/CNC/LIP .75 inch Parts/.75 DXF Drawings/Outboard Upper Left Instrument Panel Longeron.dxf
release/3_Lower Instrument Panel/Manufacturing/CNC/LIP .75 inch Parts/.75 DXF Drawings/Subfloor Brace C.dxf
release/2_Upper Instrument Panel/manufacturing/3D Printed/OH1A8A1A-12 - UFC Inner Spacer Plate.STL
release/3_Lower Instrument Panel/Manufacturing/CNC/LIP .75 inch Parts/.75 DXF Drawings/Rib L.dxf
MCAD/SIM CNTL Panel Lightplate.sldprt
MCAD/R AUX Vent Plug.sldprt
MCAD/Left AUX Upper Bracket.sldprt
MCAD/Right AUX Support Bracket, Lower, Outboard.sldprt
release/2_Upper Instrument Panel/manufacturing/3D Printed/OH1A-110 - MFD Lower Support A, Left.stl
release/2_Upper Instrument Panel/manufacturing/3D Printed/OH1A4A-11 - EWI Chassis, Left.STL
MCAD/615250 - GEAR, PINION, .250 BORE, 32 PITCH, .75 PD, 24 TOOTH, .813 OD, BRASS, SERVOCITY.SLDASM
MCAD/90252A11X - FHS, 82 DEG, #8, BLK, STEEL, FOR MDF.sldprt
MCAD/91249A111 - PHS, 4-40 X .50, 18-8, BLACK-OXIDE.SLDPRT
MCAD/92311A105 - SCREW, SET, 4-40 X .1875, CUP POINT, HEX DRIVE, 18-8.SLDPRT
MCAD/92311A189 - SCREW, SET, 8-32 X .1875, CUP POINT, HEX DRIVE, 18-8.SLDPRT
MCAD/A12505RNZQ - SWITCH, ROTARY, 36 DEG, 8 POS, FIXED.sldprt
MCAD/A12505RNZQ - SWITCH, ROTARY, 45 DEG, 8 POS, FIXED.sldprt
MCAD/AMPCD Rocker.sldprt
MCAD/KY58 Panel AFT Legend Plate.sldprt
MCAD/M55116_10-0 v7.sldasm
MCAD/MS21384-04DBN v2.sldprt
MCAD/MS21384-04DNN v1.sldprt
MCAD/MS21387-18BN v4.sldprt
MCAD/Right AUX Support Bracket, Lower, Inboard.sldprt
MCAD/Right AUX Upper Bracket.sldprt
MCAD/SIM CNTL Panel Backplate.sldprt
MCAD/drawings/5_Right Console/OH5A8A_ASSY, SIM CNTL PANEL.SLDDRW
release/2_Upper Instrument Panel/manufacturing/3D Printed/OH1A-107 - Upper UIP Face Mount, Left.stl
release/2_Upper Instrument Panel/manufacturing/3D Printed/OH1A-111 - MFD Lower Support B.stl
release/2_Upper Instrument Panel/manufacturing/3D Printed/OH1A-113 - HUD Panel Aft Support.stl
release/2_Upper Instrument Panel/manufacturing/3D Printed/OH1A-115 - UIP Central Tie Bracket.stl
release/2_Upper Instrument Panel/manufacturing/3D Printed/OH1A2A-11 - Master Arm Lightplate.STL
release/2_Upper Instrument Panel/manufacturing/3D Printed/OH1A2A-20 - Master Mode Pushbutton Base.STL
release/2_Upper Instrument Panel/manufacturing/3D Printed/OH1A2A-25 - Master Mode Pushbutton Actuator.STL
release/2_Upper Instrument Panel/manufacturing/3D Printed/OH1A2A-30 - .55 SQ Indicator Bezel.STL
release/2_Upper Instrument Panel/manufacturing/3D Printed/OH1A2A-36 - .55 SQ Indicator Base.STL
release/2_Upper Instrument Panel/manufacturing/3D Printed/OH1A3A-17 - Rotary Mount Plate.STL
release/2_Upper Instrument Panel/manufacturing/3D Printed/OH1A3A-18 - DDI MS21382-0XBX (MODIFIED).stl
release/2_Upper Instrument Panel/manufacturing/3D Printed/OH1A4A-10 - EWI Legend Plate, Left.STL
release/2_Upper Instrument Panel/manufacturing/3D Printed/OH1A7A-10 - Spin Panel Legend Plate.STL
release/2_Upper Instrument Panel/manufacturing/3D Printed/OH1A7A-13 - Spin Panel Module Bracket.STL
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
