petersawka/OpenHornet/docs/OHDevelopmentRoadmap.pdf

Development | Beta Release (v0.5)

# DRAFT (09/25/2020)

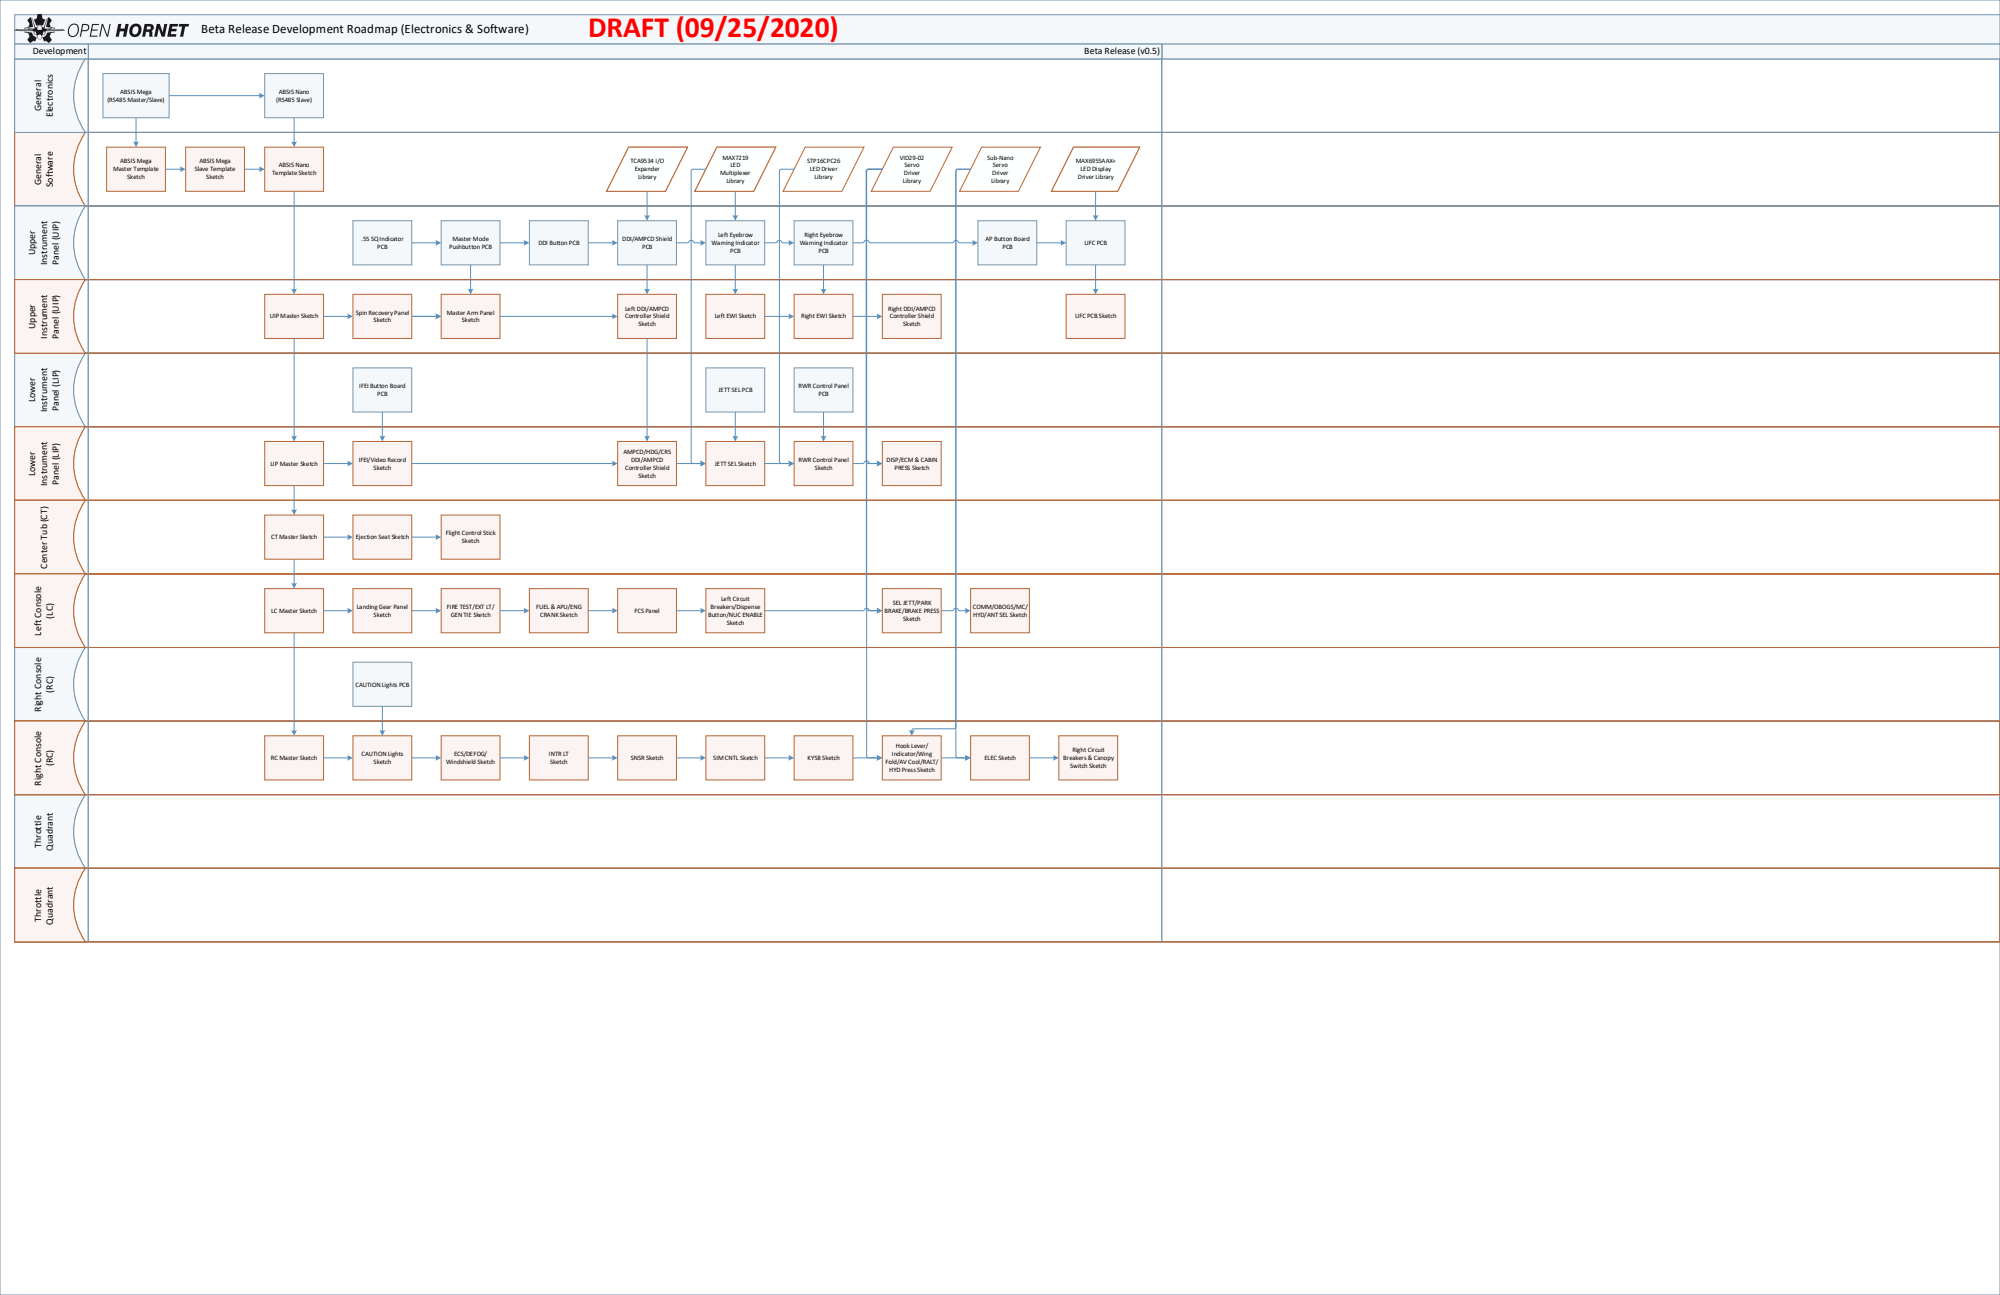
[picture p95: page 1]
ABSIS Mega (RS485 Master/Slave); ABSIS Mega Master Template Sketch; ABSIS Mega Slave Template Sketch; ABSIS Nano (RS485 Slave); ABSIS Nano Template Sketch; DDI Button PCB; DDI/AMPCD Shield; PCB; TCA9534 I/O Expander Library; Left Eyebrow Warning Indicator PCB; MAX7219 LED Multiplexer Library; Right Eyebrow Warning Indicator PCB; UFC PCB; MAX6955AAX+ LED Display Driver Library; STP16CPC26 LED Driver Library; VID29-02 Servo Driver Library; CT Master Sketch; Ejection Seat Sketch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

Beta Release Development Roadmap (Electronics & Software) General Software General Electronics Upper Instrument Panel (UIP⁾ Lower Instrument Panel (LIP⁾ Right Console (RC⁾ Throttle Quadrant Upper Instrument Panel (UIP⁾ Lower Instrument Panel (LIP⁾ Center Tub ⁽CT⁾ Left Console (LC⁾ Right Console (RC⁾ Throttle Quadrant

AP Button Board
PCB

Spin Recovery Panel
Sketch

Left EWI Sketch Master Arm Panel

Left DDI/AMPCD
Controller Shield

Right DDI/AMPCD

UIP Master Sketch

Right EWI Sketch

UFC PCB Sketch

IFEI Button Board

JETT SEL PCB

RWR Control Panel

AMPCD/HDG/CRS
DDI/AMPCD

LIP Master Sketch

IFEI/Video Record

JETT SEL Sketch

DISP/ECM & CABIN
PRESS Sketch

Left Circuit
Breakers/Dispense
Button/NUC ENABLE

FIRE TEST/EXT LT/
GEN TIE Sketch

FUEL & APU/ENG

SEL JETT/PARK
BRAKE/BRAKE PRESS

COMM/OBOGS/MC/
HYD/ANT SEL Sketch

CAUTION Lights PCB

Hook Lever/
Indicator/Wing
Fold/AV Cool/RALT/
HYD Press Sketch

RC Master Sketch
