petersawka/OpenHornet/ECAD/PCBs/Specialty/DDI/ddi_button_board/Buttons_DDI.kicad_pcb

## KiCad design ECAD/PCBs/Specialty/DDI/ddi_button_board/Buttons_DDI.kicad_pcb (2020-11-07)

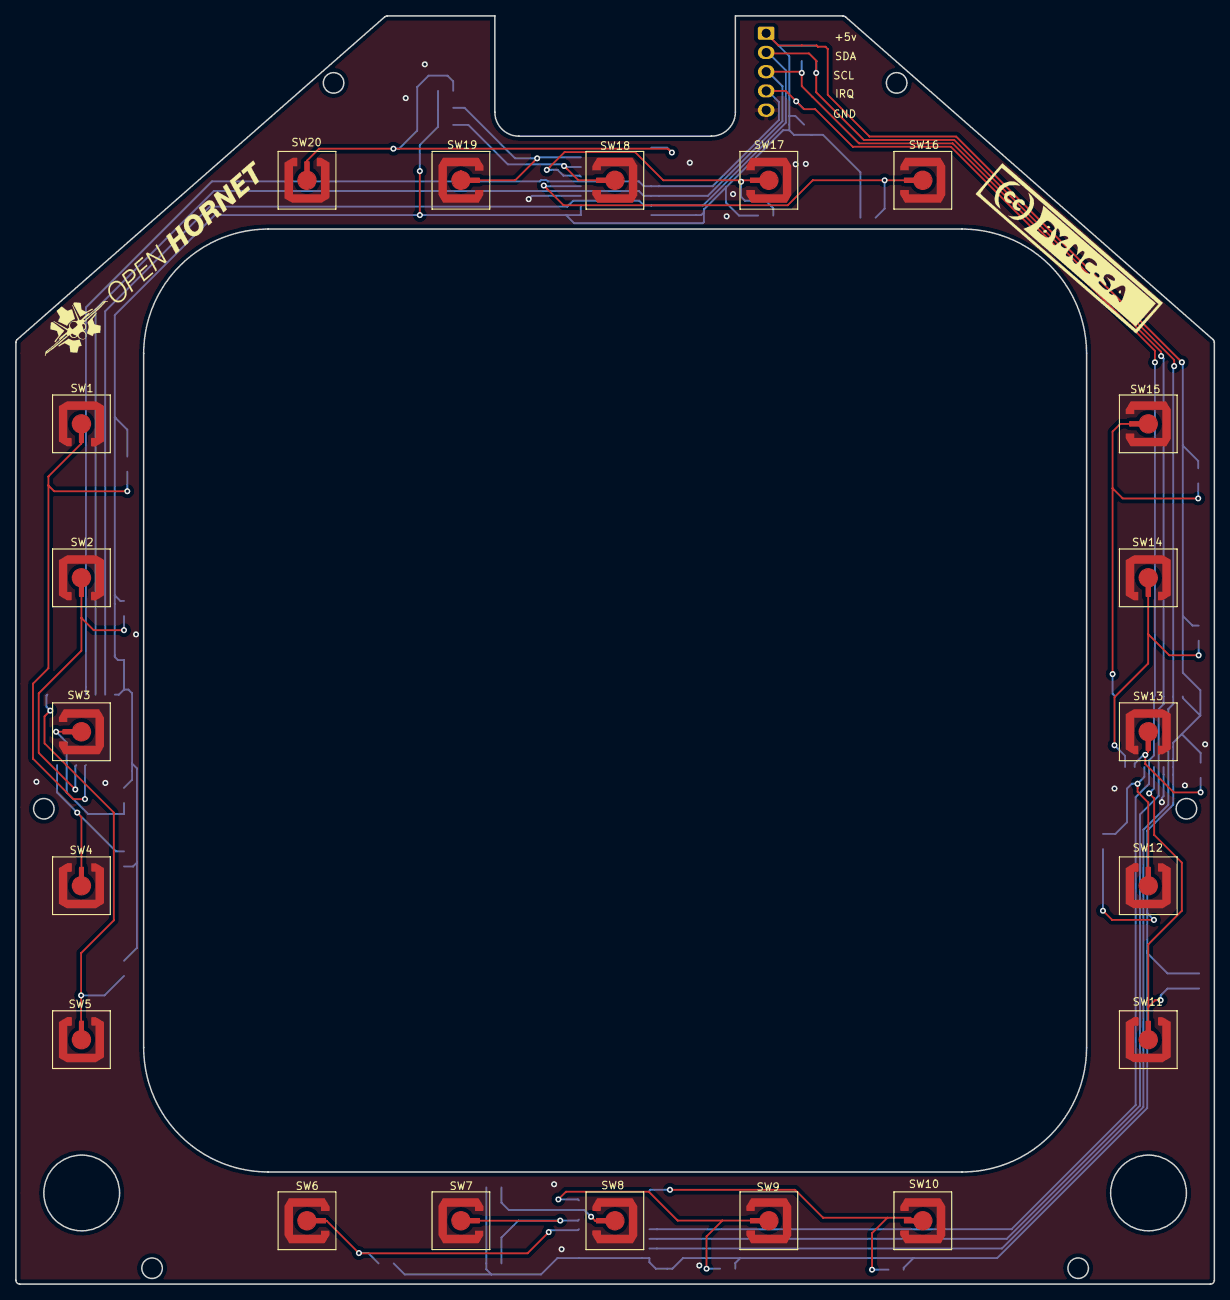
[picture p112: board Buttons_DDI.kicad_pcb from above]

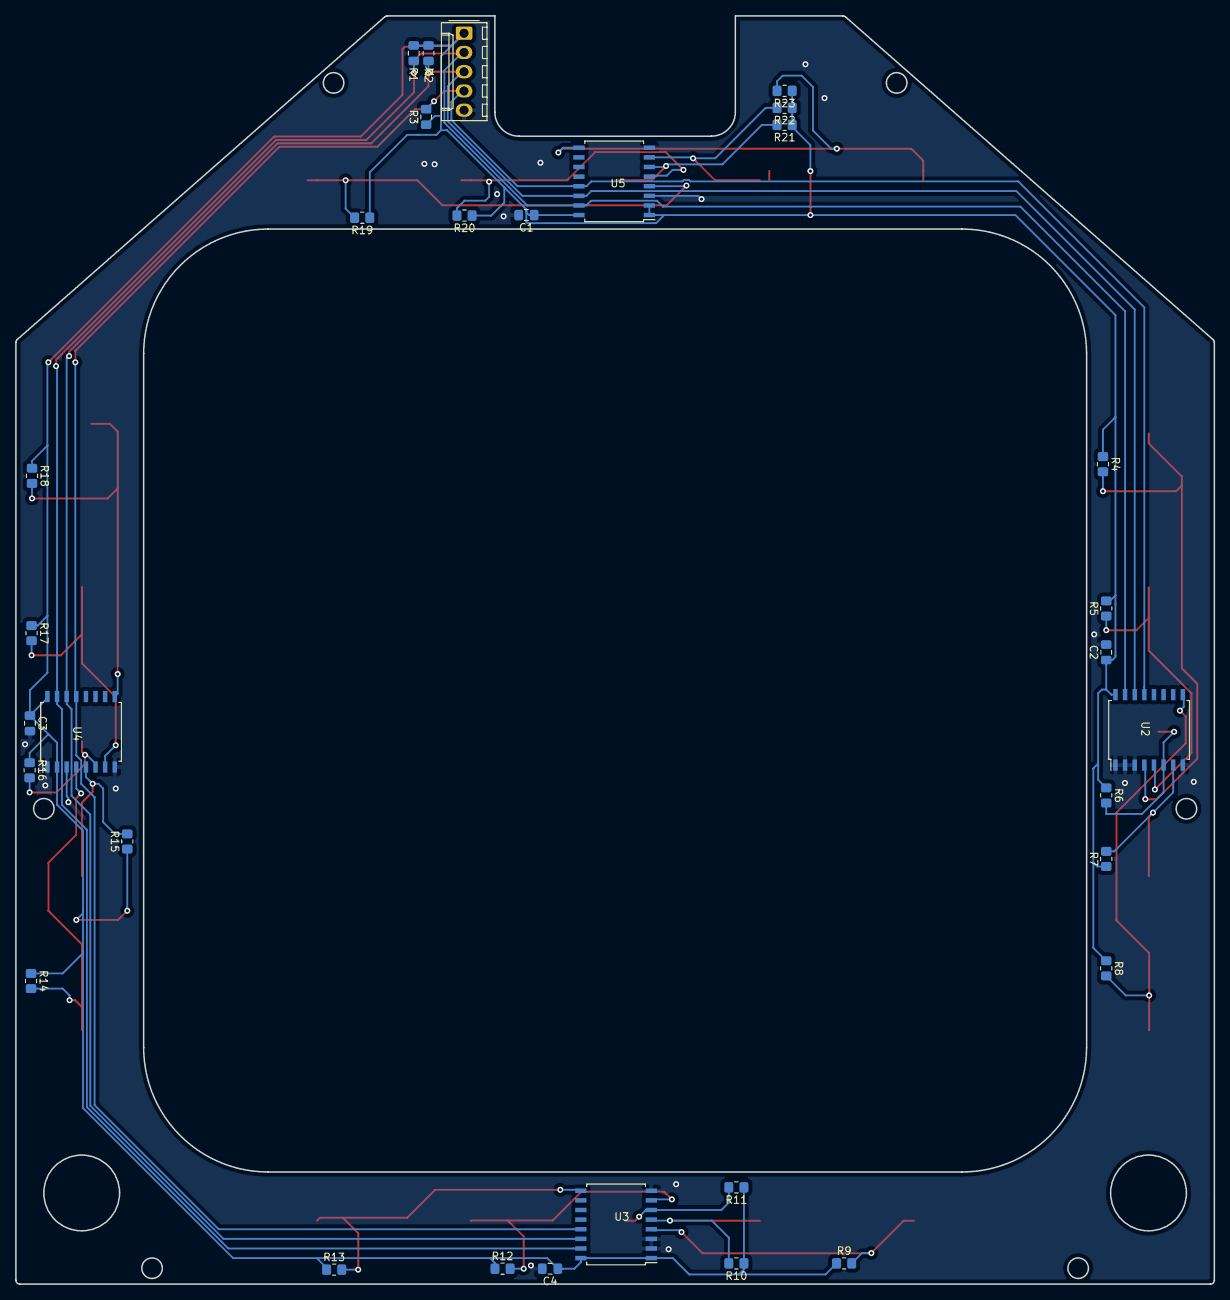
[picture p113: board Buttons_DDI.kicad_pcb from below]

Board: 2 copper layers, 158.2 x 167.4 mm, 52 parts (32 on the bottom side), 25 nets.

Parts:
C1, C2, C3, C4: 47uF; C_0805_2012Metric_Pad1.15x1.40mm_HandSolder
J1: ExpansionPort; Molex_KK-254_AE-6410-05A_1x05_P2.54mm_Vertical
R1, R2, R3: 10k; R_0805_2012Metric_Pad1.15x1.40mm_HandSolder
R4, R5, R6, R7, R8, R9, R10, R11, R12, R13, R14, R15, R16, R17, R18, R19, R20, R21, R22, R23: 10k; R_0805_2012Metric_Pad1.20x1.40mm_HandSolder
SW1, SW2, SW3, SW4, SW5, SW6, SW7, SW8, SW9, SW10, SW11, SW12, SW13, SW14, SW15, SW16, SW17, SW18, SW19, SW20: SW_Push; SWITCH_SNAP_DOME_6.3mm_DIA_SINGLE_SIDE_PCB
U2, U3, U4, U5: TCA9534; SOIC-16W_7.5x10.3mm_P1.27mm

Connections:
+5V: C1.1, C2.1, C3.1, C4.1, J1.1, R1.1, R2.1, R3.1, R4.1, R5.1, R6.1, R7.1, R8.1, R9.1, R10.1, R11.1, R12.1, R13.1, R14.1, R15.1, R16.1, R17.1, R18.1, R19.1, R20.1, R21.1, R22.1, R23.1, U2.16, U3.1, U3.16, U4.2, U4.16, U5.1, U5.2, U5.16
GND: C1.2, C2.2, C3.2, C4.2, J1.5, SW1.2, SW2.2, SW3.2, SW4.2, SW5.2, SW6.2, SW7.2, SW8.2, SW9.2, SW10.2, SW11.2, SW12.2, SW13.2, SW14.2, SW15.2, SW16.2, SW17.2, SW18.2, SW19.2, SW20.2, U2.1, U2.2, U2.3, U2.8, U3.2, U3.3, U3.8, U4.1, U4.3, U4.8, U5.3, U5.8
IRQ: J1.4, R3.2, U2.13, U3.13, U4.13, U5.13
unnamed: R4.2, SW1.1, U2.4
unnamed: R5.2, SW2.1, U2.5
unnamed: R6.2, SW3.1, U2.6
unnamed: R7.2, SW4.1, U2.7
unnamed: R8.2, SW5.1, U2.9
unnamed: R9.2, SW6.1, U3.4
unnamed: R10.2, SW7.1, U3.5
unnamed: R11.2, SW8.1, U3.6
unnamed: R12.2, SW9.1, U3.7
unnamed: R13.2, SW10.1, U3.9
unnamed: R14.2, SW11.1, U4.4
unnamed: R15.2, SW12.1, U4.5
unnamed: R16.2, SW13.1, U4.6
unnamed: R17.2, SW14.1, U4.7
unnamed: R18.2, SW15.1, U4.9
unnamed: R19.2, SW16.1, U5.4
unnamed: R20.2, SW17.1, U5.5
unnamed: R21.2, SW18.1, U5.6
unnamed: R22.2, SW19.1, U5.7
unnamed: R23.2, SW20.1, U5.9
SCL: J1.3, R2.2, U2.14, U3.14, U4.14, U5.14
SDA: J1.2, R1.2, U2.15, U3.15, U4.15, U5.15
